connythecreator/crimson-veil/3Dmodels/case/drawings/base.png

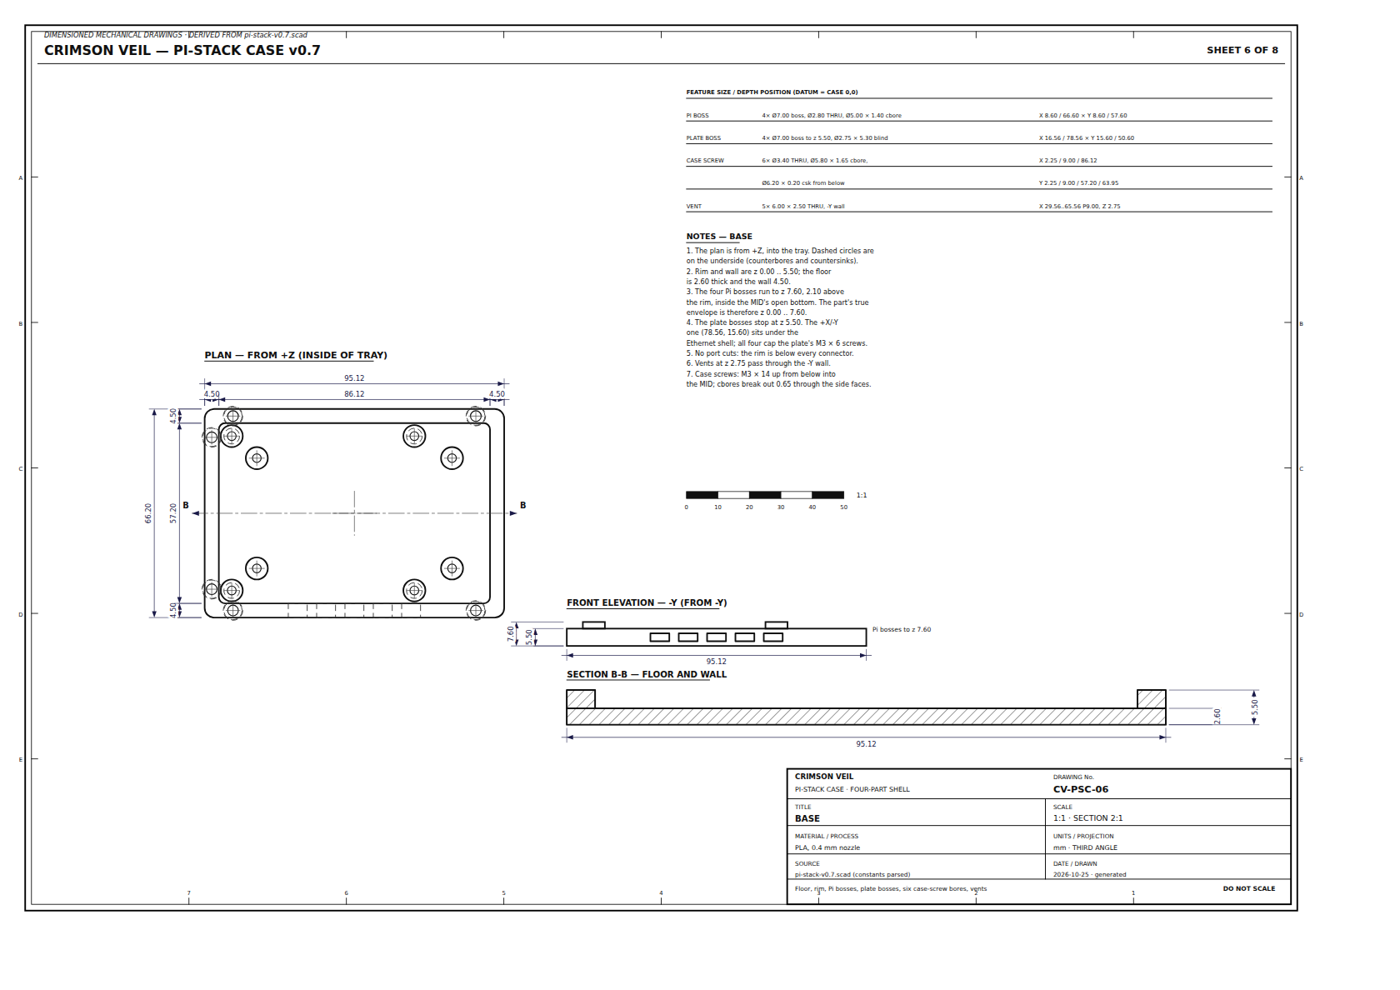
3Dmodels/case/drawings/base.png
