connythecreator/crimson-veil/3Dmodels/case/drawings/bezel.png

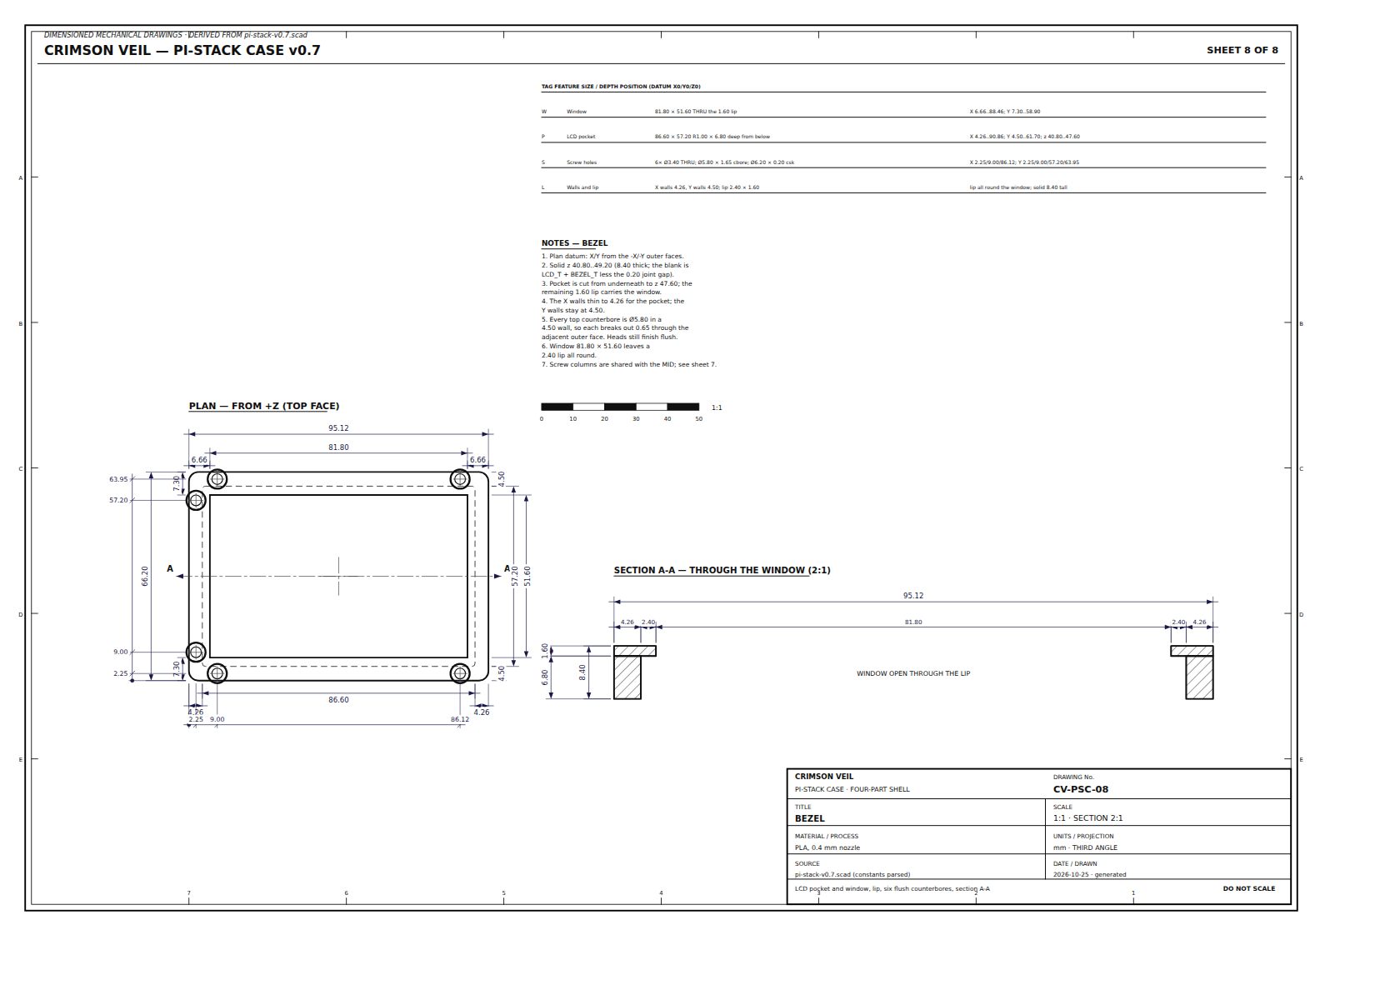
3Dmodels/case/drawings/bezel.png
