connythecreator/crimson-veil/3Dmodels/case/drawings/mid.png

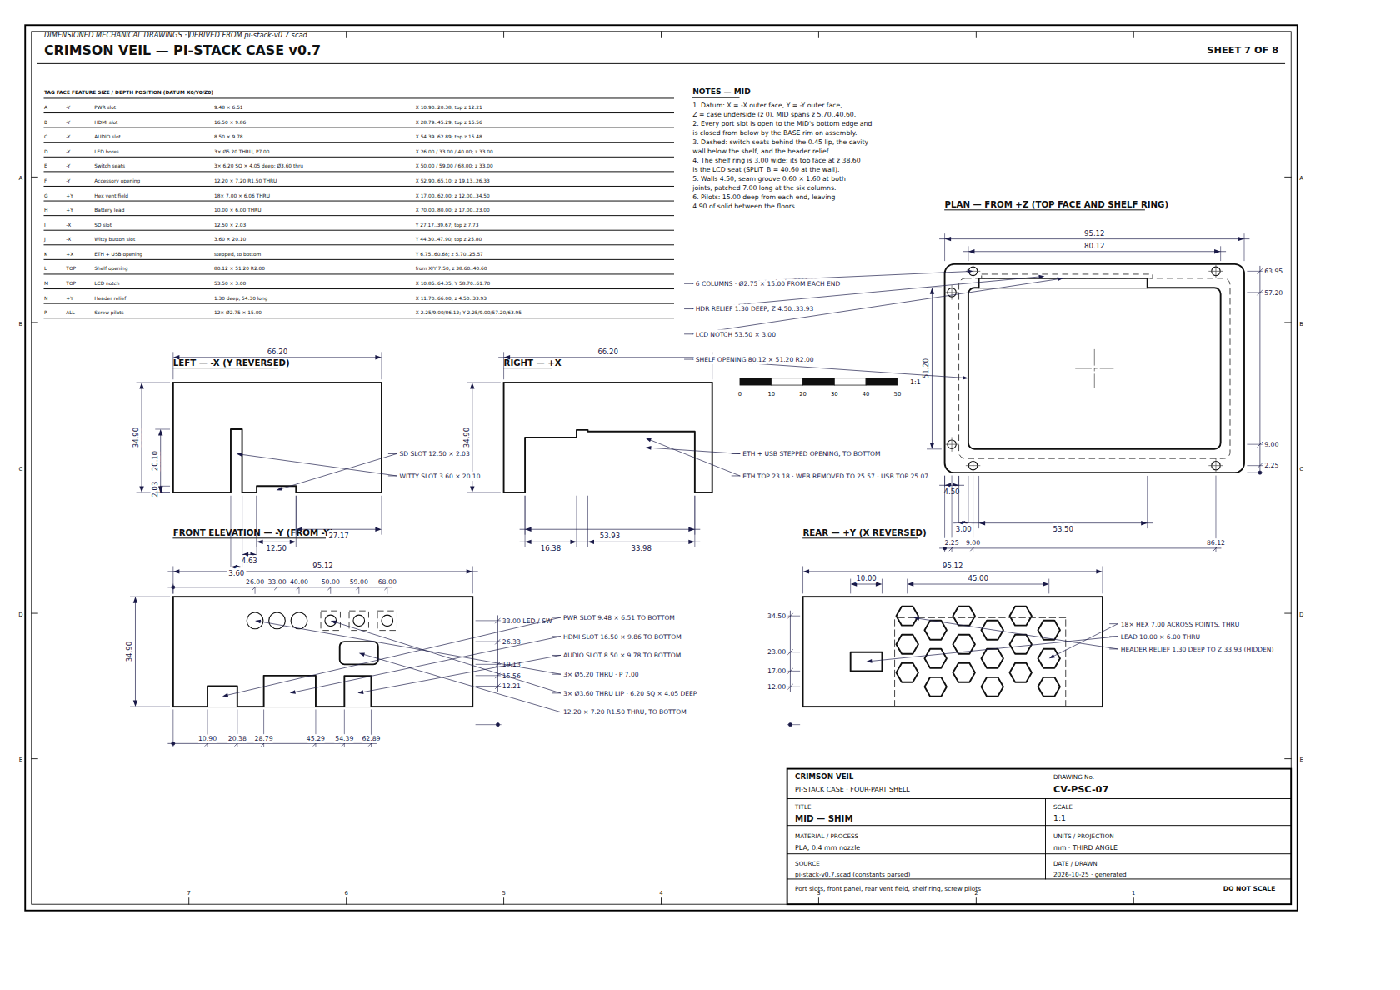
3Dmodels/case/drawings/mid.png
