connythecreator/crimson-veil/3Dmodels/case/drawings/plate.png

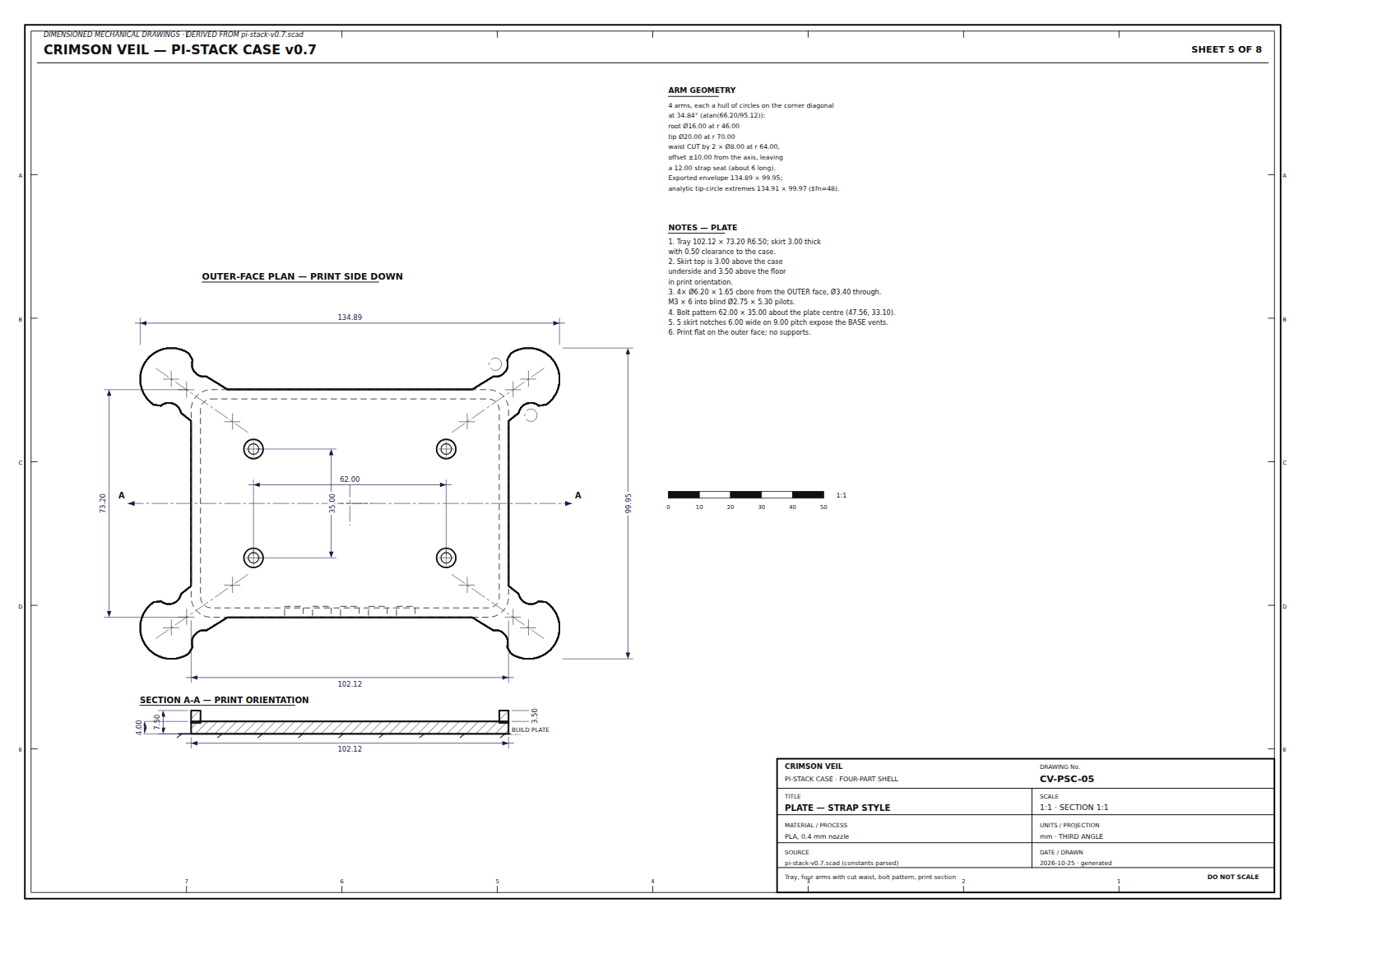
3Dmodels/case/drawings/plate.png
