connythecreator/crimson-veil/3Dmodels/case/preview/pi-stack-v0.1.png

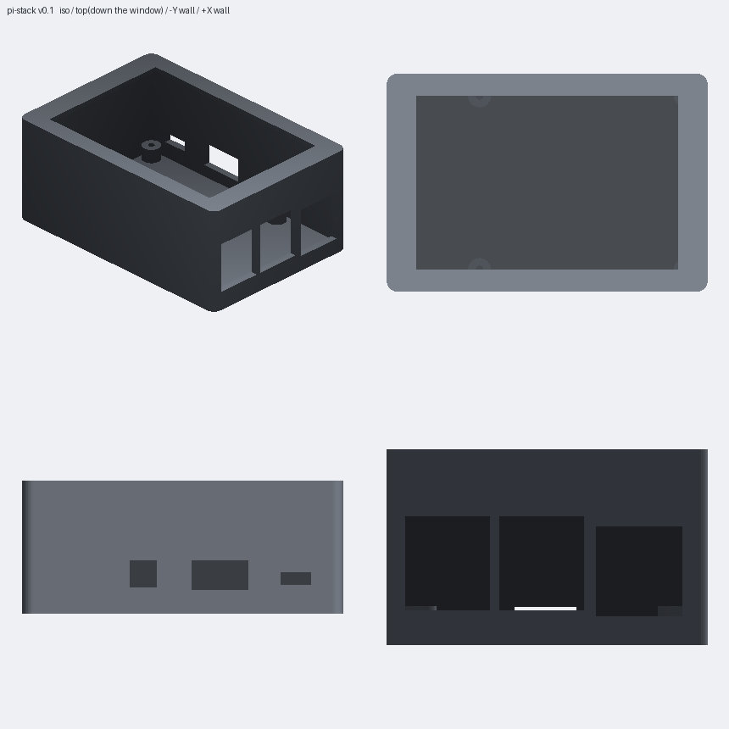
3Dmodels/case/preview/pi-stack-v0.1.png
