connythecreator/crimson-veil/3Dmodels/case/preview/v0.3-internals.png

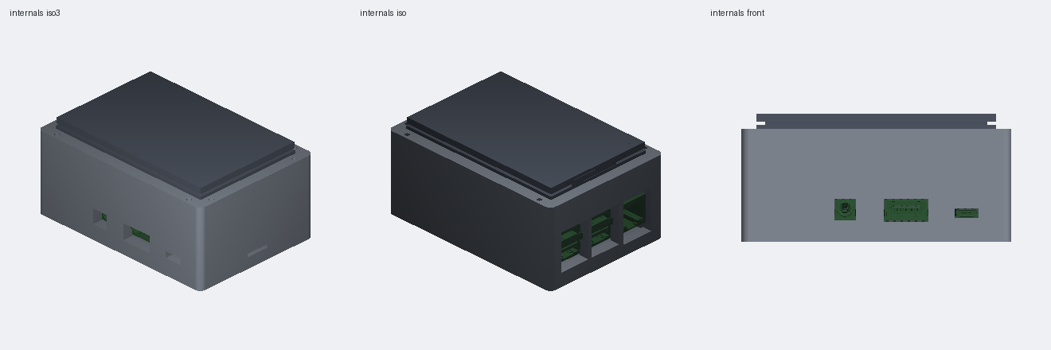
3Dmodels/case/preview/v0.3-internals.png
