connythecreator/crimson-veil/3Dmodels/case/preview/v0.3-stack.png

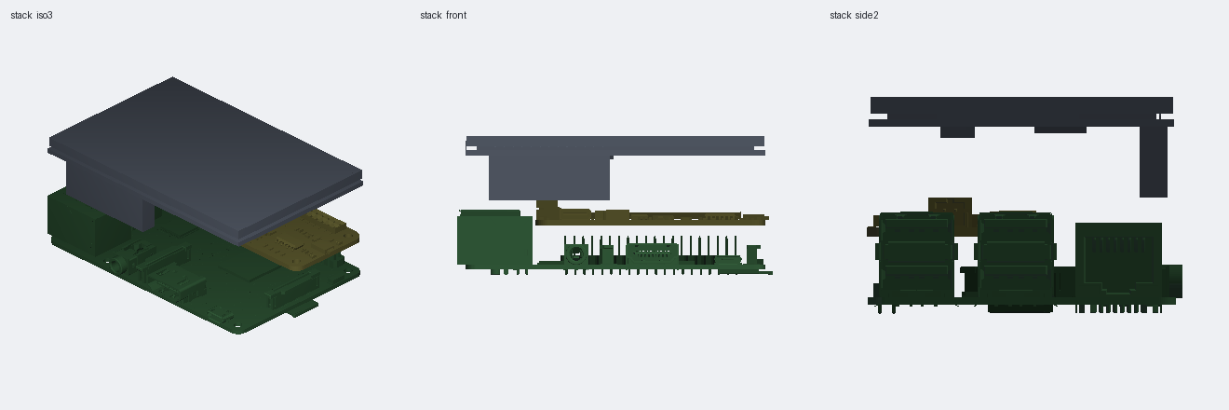
3Dmodels/case/preview/v0.3-stack.png
