connythecreator/crimson-veil/3Dmodels/case/preview/v0.4-joints.png

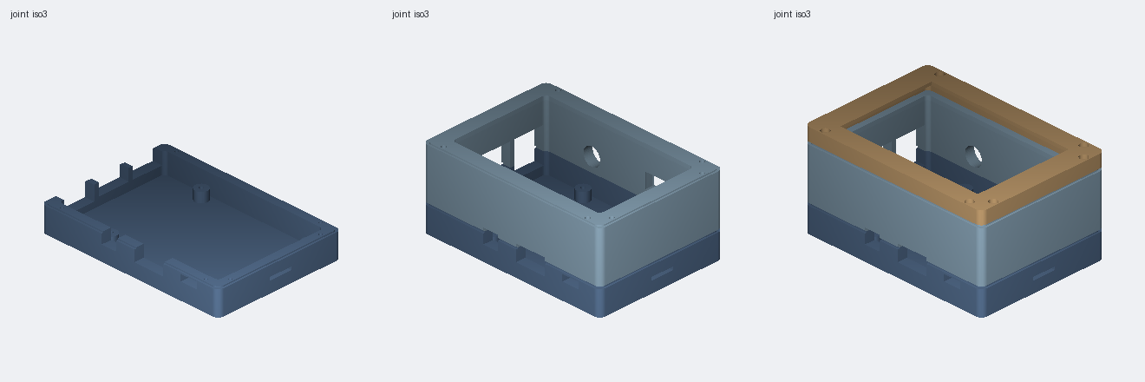
3Dmodels/case/preview/v0.4-joints.png
