connythecreator/crimson-veil/3Dmodels/case/preview/v0.5-joints.png

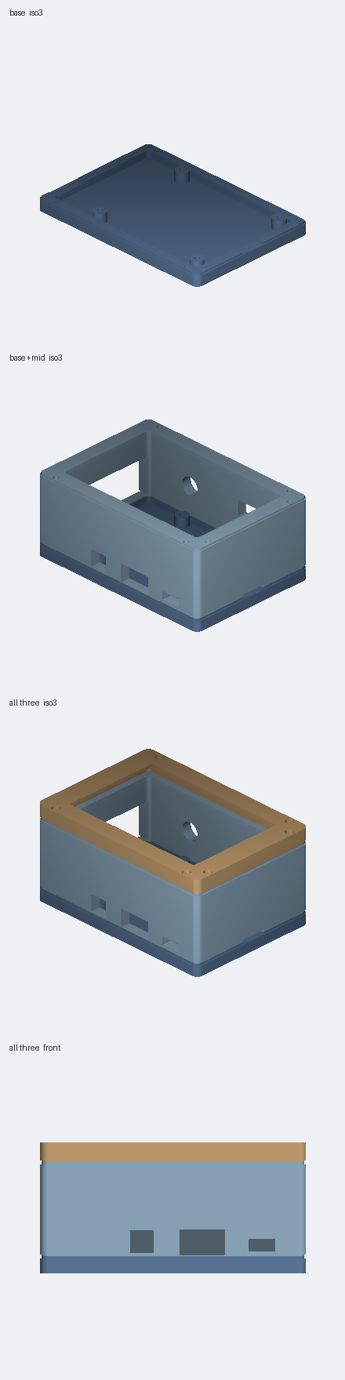
3Dmodels/case/preview/v0.5-joints.png
