connythecreator/crimson-veil/3Dmodels/case/preview/v0.6-joints.png

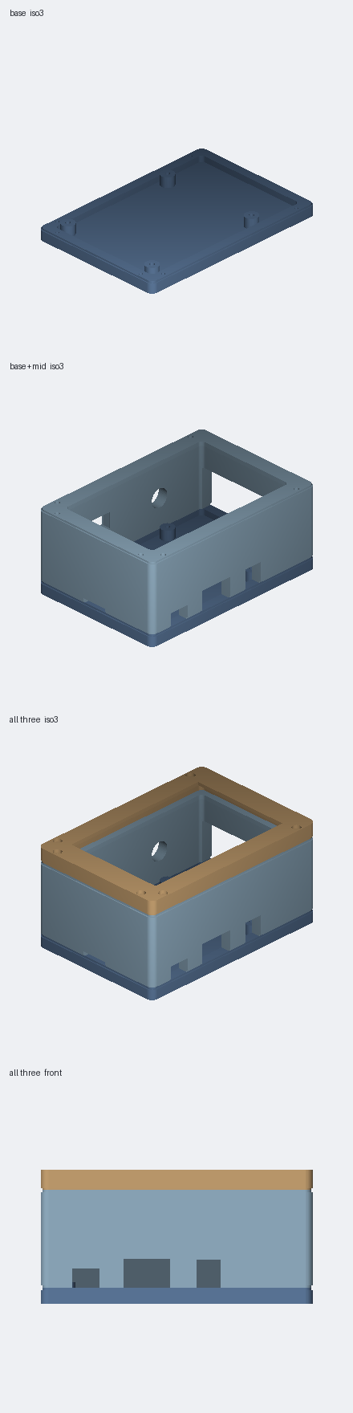
3Dmodels/case/preview/v0.6-joints.png
