connythecreator/crimson-veil/3Dmodels/case/preview/v0.6-section.png

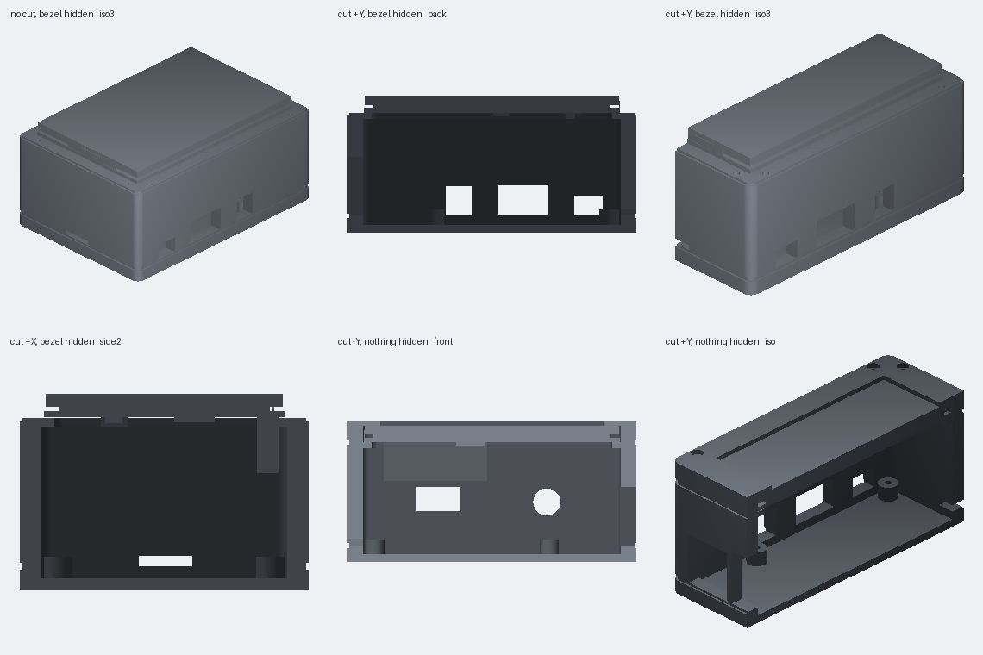
3Dmodels/case/preview/v0.6-section.png
