connythecreator/crimson-veil/3Dmodels/case/preview/v0.6-stack.png

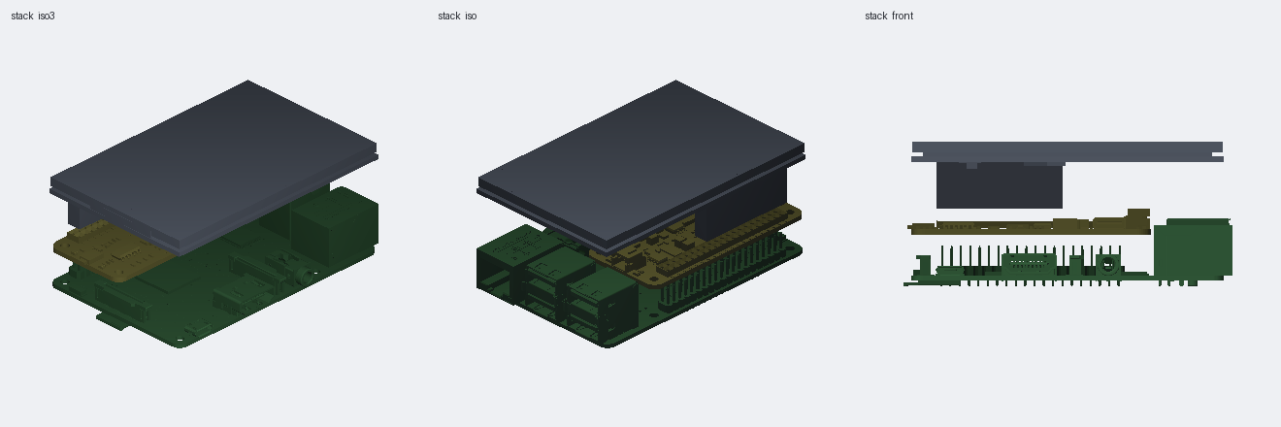
3Dmodels/case/preview/v0.6-stack.png
