connythecreator/crimson-veil/3Dmodels/case/preview/v0.7-base.png

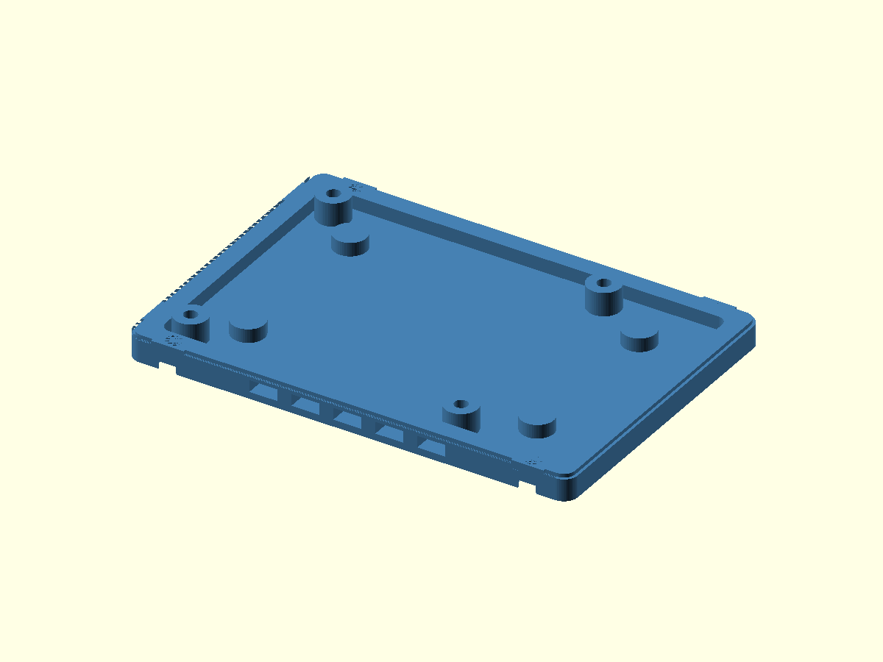
3Dmodels/case/preview/v0.7-base.png
