connythecreator/crimson-veil/3Dmodels/case/preview/v0.7-fittings.png

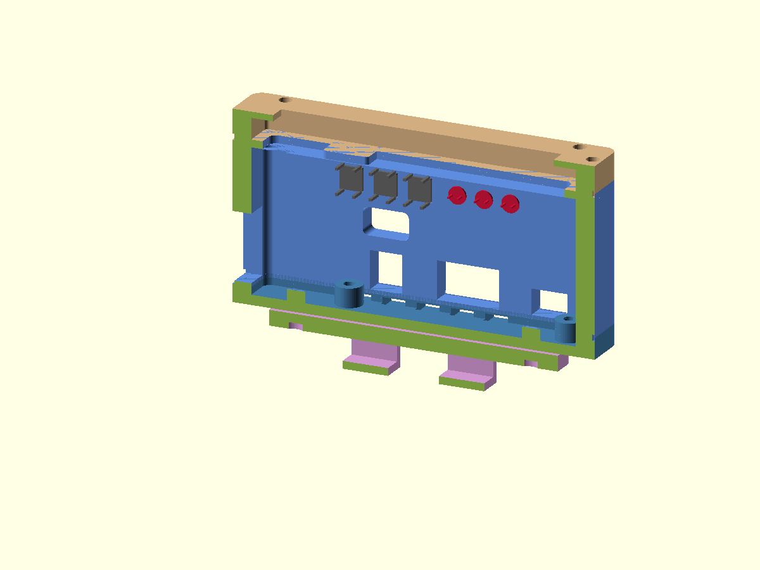
3Dmodels/case/preview/v0.7-fittings.png
