connythecreator/crimson-veil/3Dmodels/case/preview/v0.7-front.png

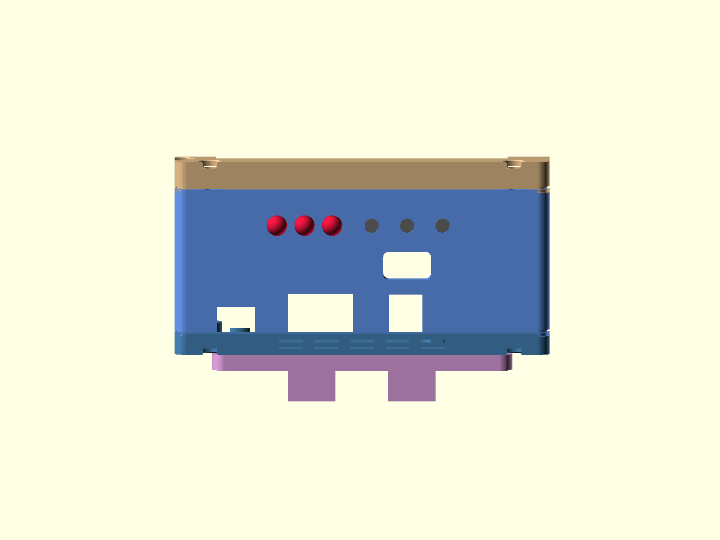
3Dmodels/case/preview/v0.7-front.png
