connythecreator/crimson-veil/3Dmodels/case/preview/v0.7-internals.png

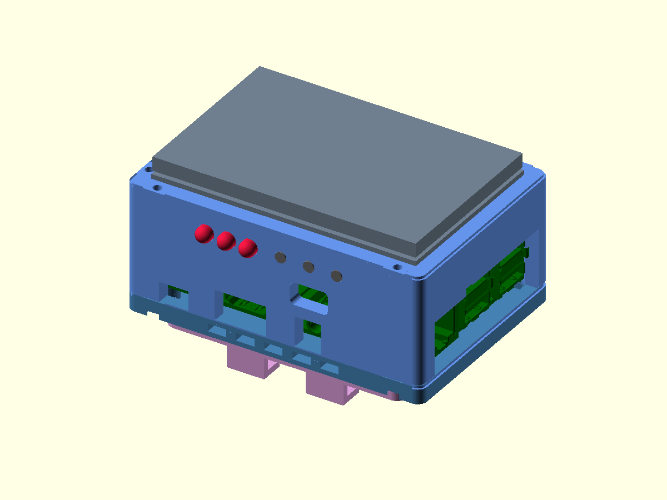
3Dmodels/case/preview/v0.7-internals.png
