connythecreator/crimson-veil/3Dmodels/case/preview/v0.7-joints.png

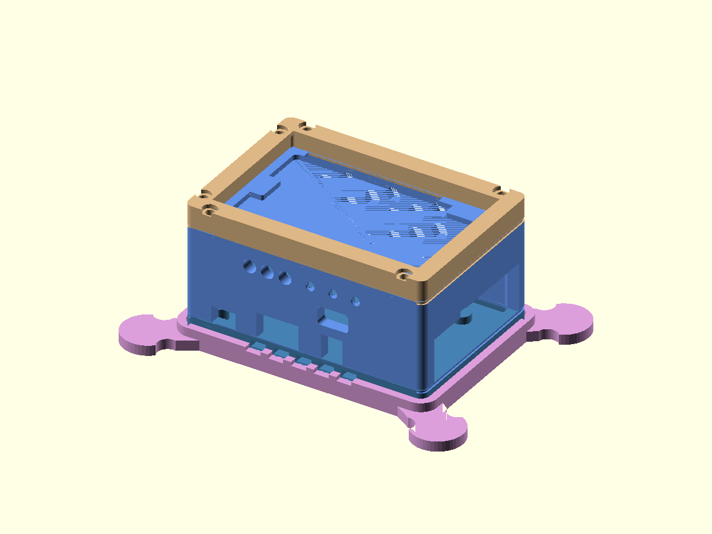
3Dmodels/case/preview/v0.7-joints.png
