connythecreator/crimson-veil/3Dmodels/case/preview/v0.7-midpanel.png

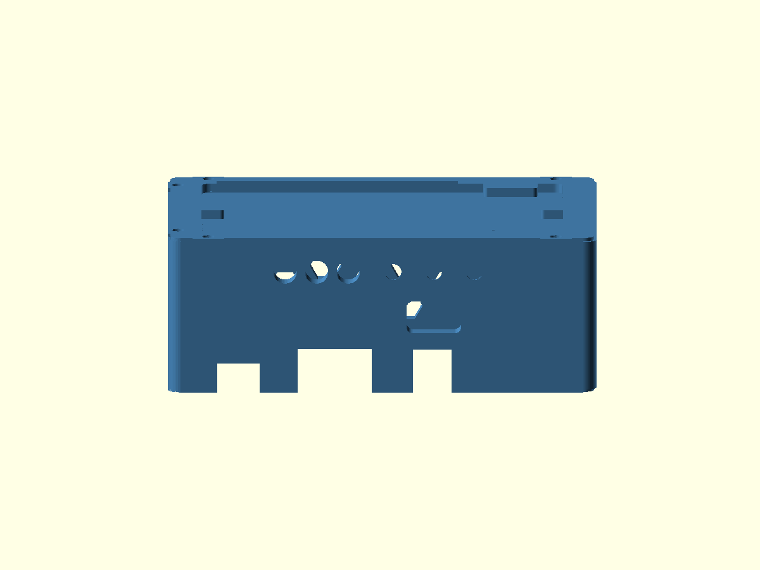
3Dmodels/case/preview/v0.7-midpanel.png
