connythecreator/crimson-veil/3Dmodels/case/preview/v0.7-pads.png

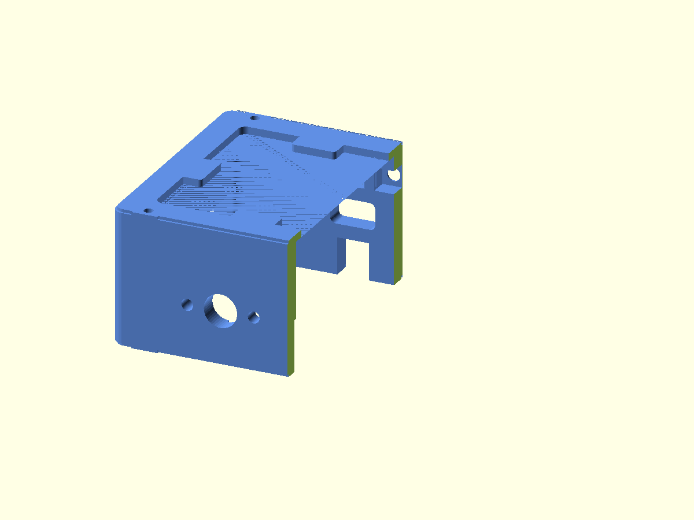
3Dmodels/case/preview/v0.7-pads.png
