connythecreator/crimson-veil/3Dmodels/case/preview/v0.7-panel.png

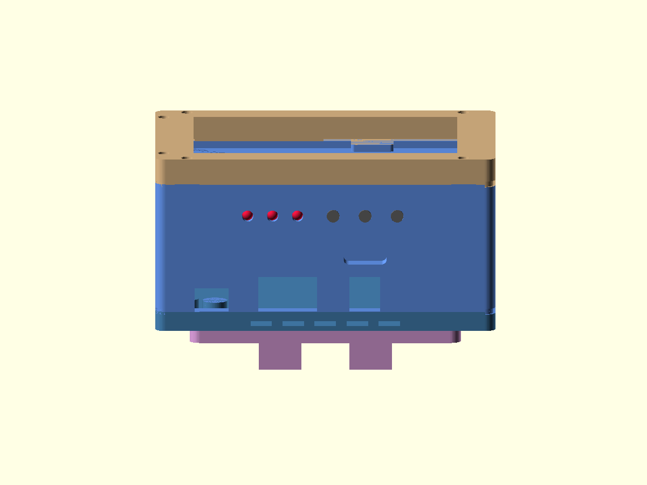
3Dmodels/case/preview/v0.7-panel.png
