connythecreator/crimson-veil/3Dmodels/case/preview/v0.7-plate.png

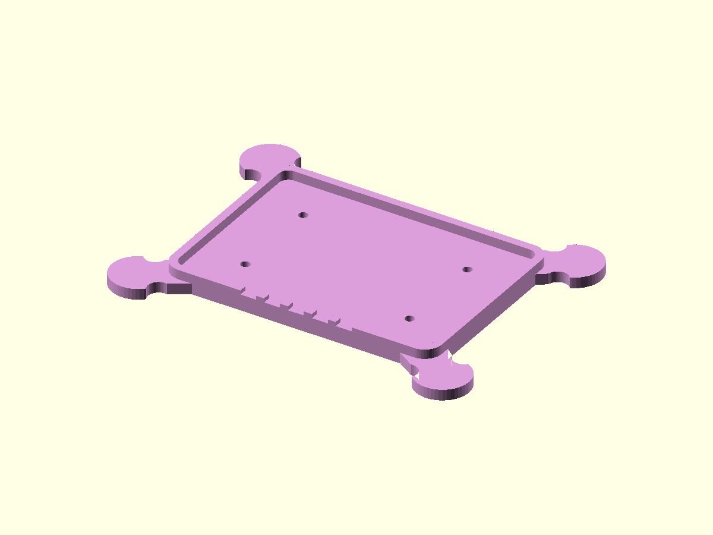
3Dmodels/case/preview/v0.7-plate.png
