connythecreator/crimson-veil/3Dmodels/case/preview/v0.7-rear.png

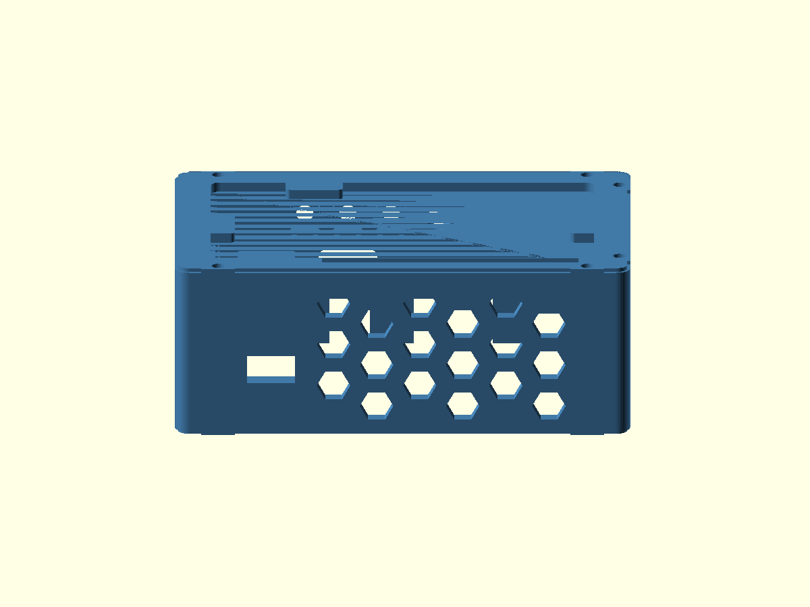
3Dmodels/case/preview/v0.7-rear.png
