connythecreator/crimson-veil/3Dmodels/case/preview/v0.7-section.png

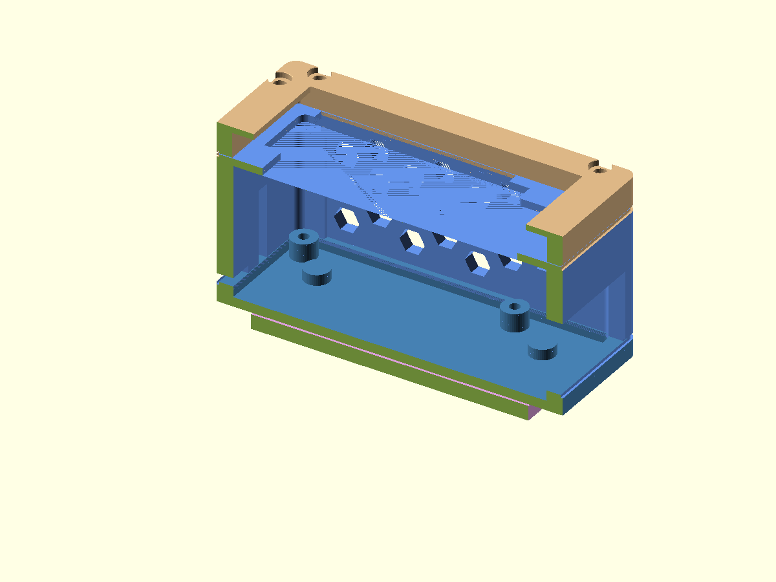
3Dmodels/case/preview/v0.7-section.png
