connythecreator/crimson-veil/3Dmodels/case/preview/v0.7-stack.png

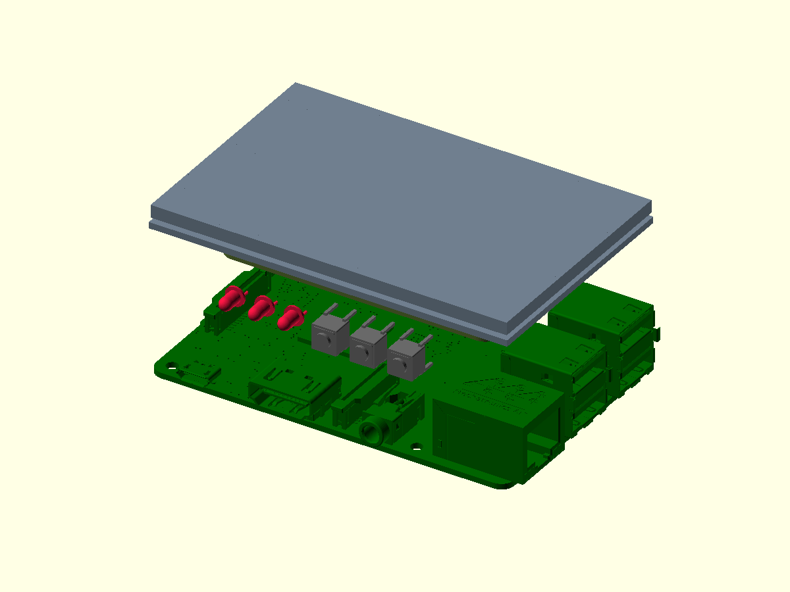
3Dmodels/case/preview/v0.7-stack.png
