connythecreator/crimson-veil/3Dmodels/case/preview/v0.7-underside.png

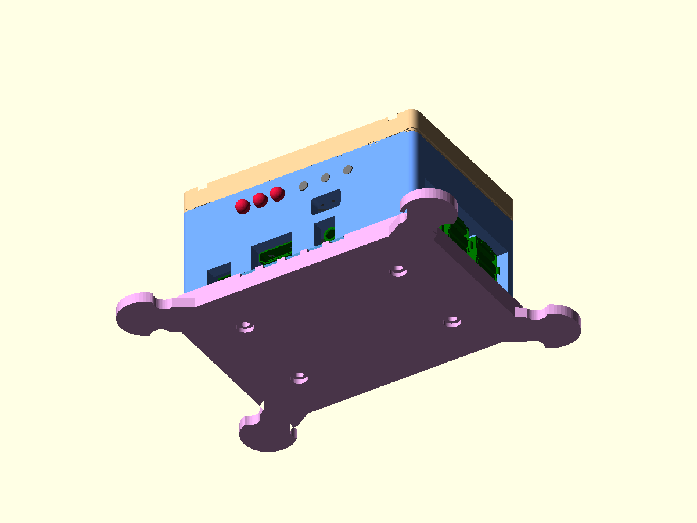
3Dmodels/case/preview/v0.7-underside.png
