connythecreator/crimson-veil/architecture-repo-wide.png

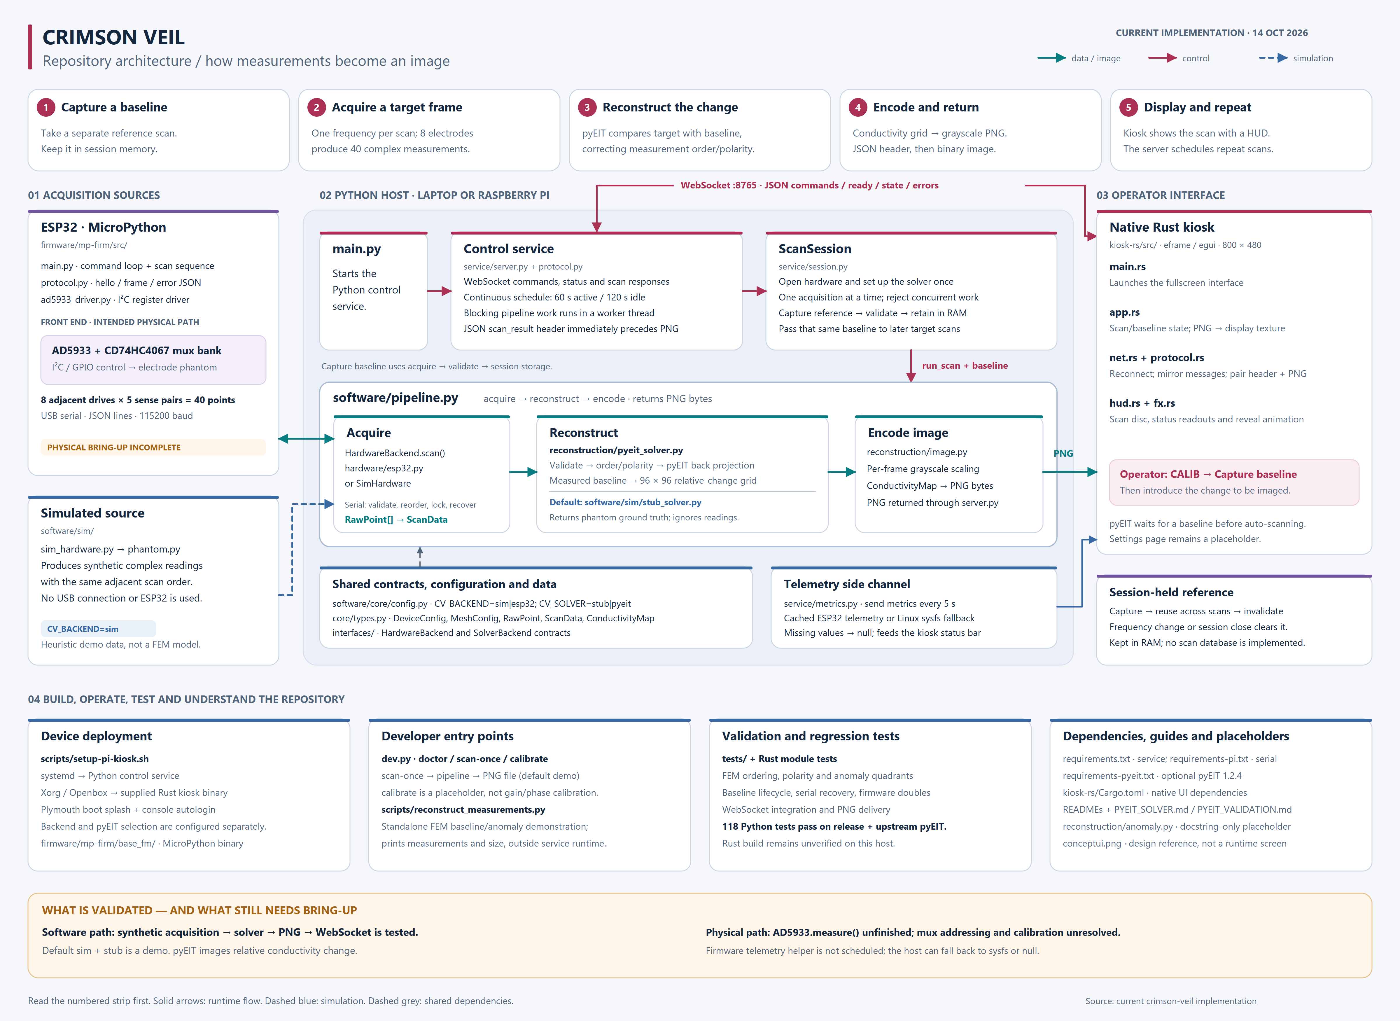
architecture-repo-wide.png
