connythecreator/crimson-veil/bleed/Pasted image.png

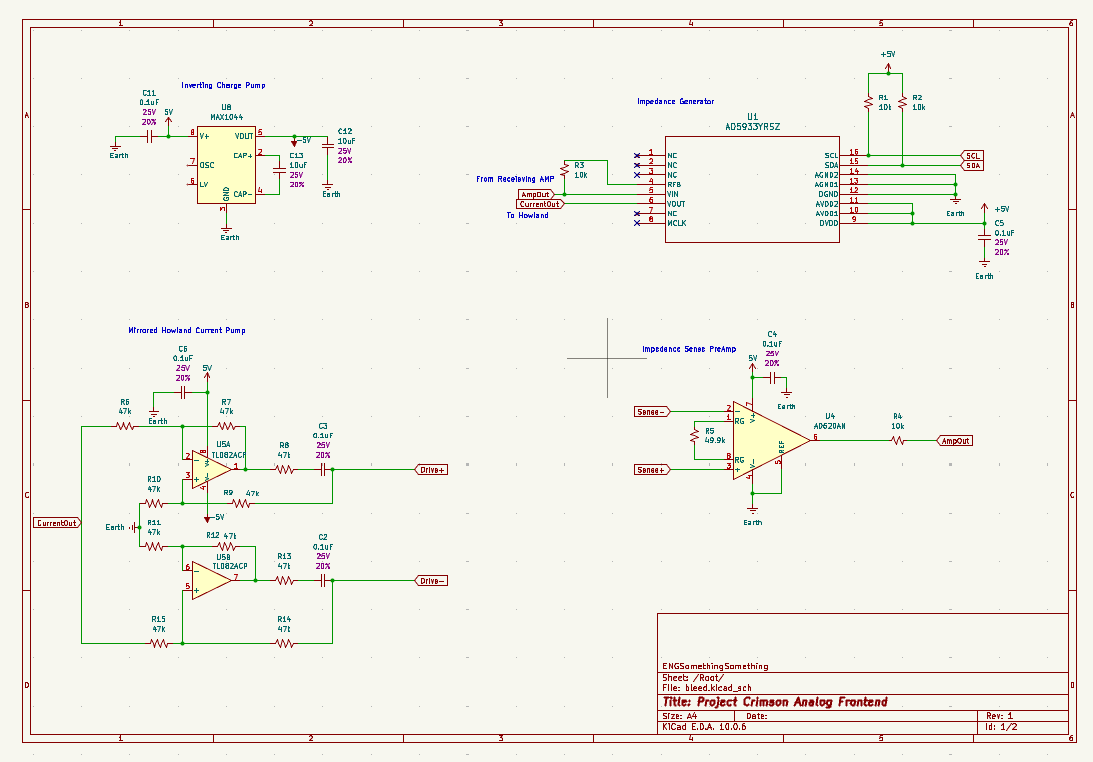
bleed/Pasted image.png
