connythecreator/crimson-veil/conceptui.png

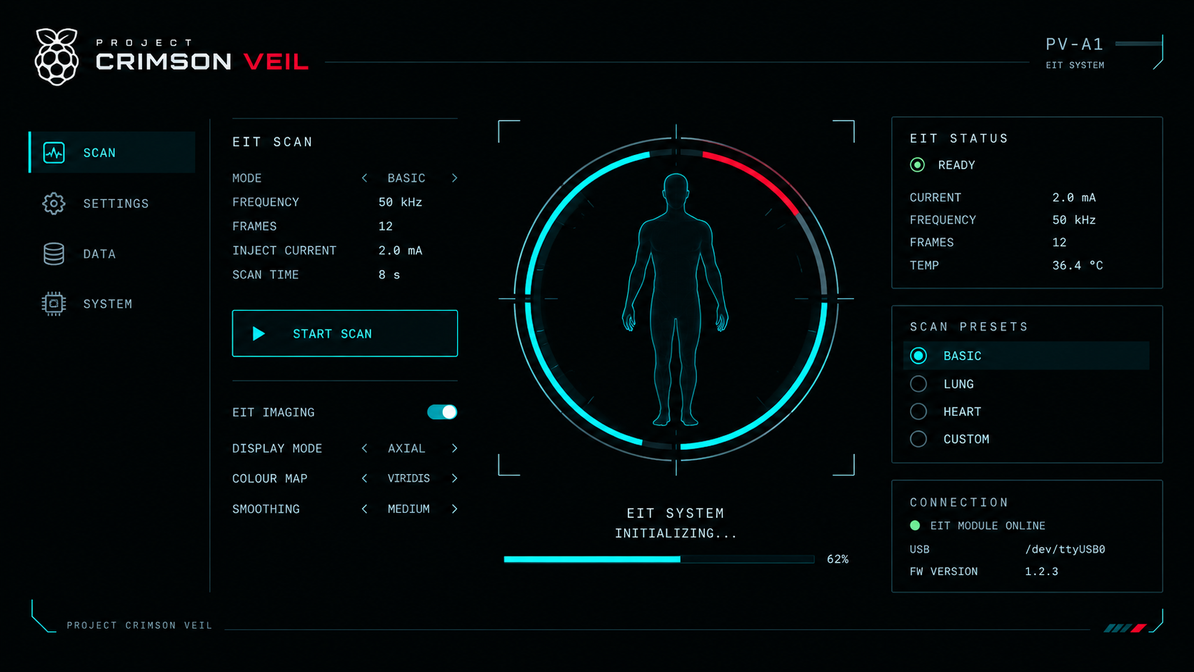
conceptui.png
