connythecreator/crimson-veil/3Dmodels/case/preview/v0.2-parts.png

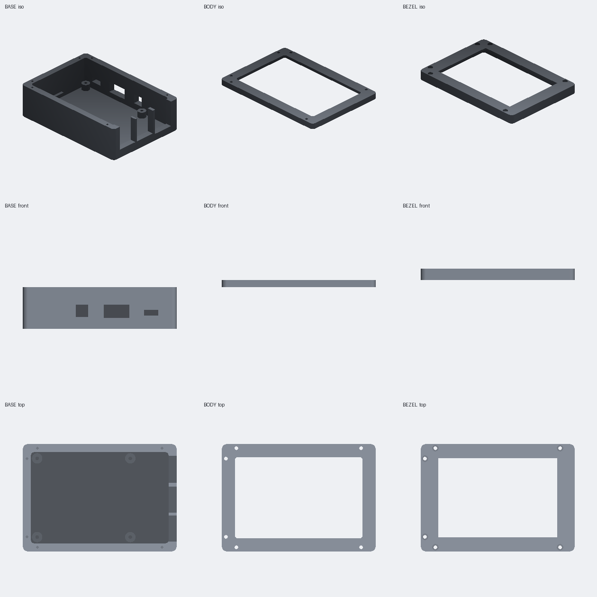
3Dmodels/case/preview/v0.2-parts.png
