connythecreator/crimson-veil/3Dmodels/case/preview/v0.6-parts.png

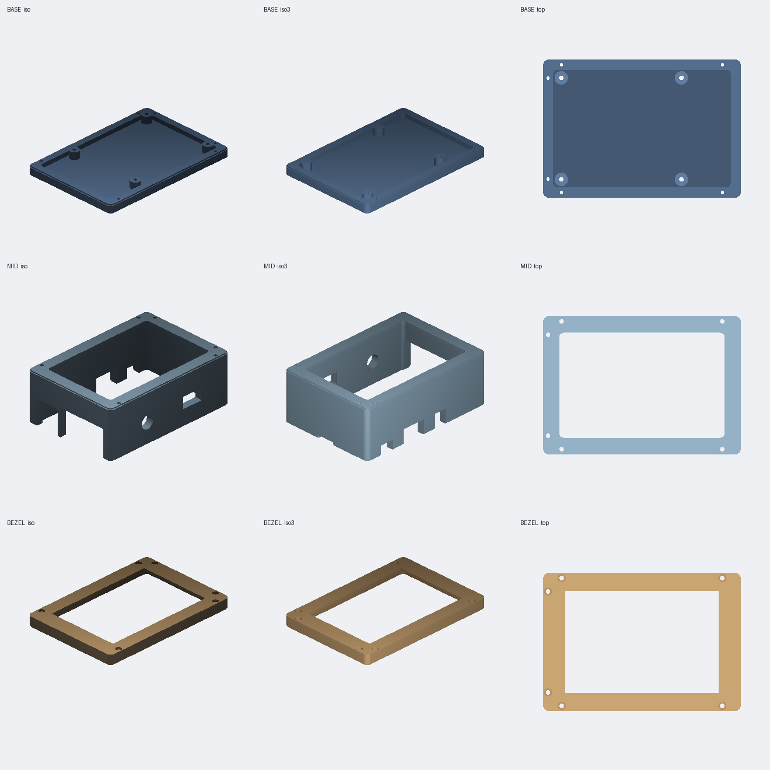
3Dmodels/case/preview/v0.6-parts.png
