connythecreator/crimson-veil/3Dmodels/case/preview/v0.7-parts.png

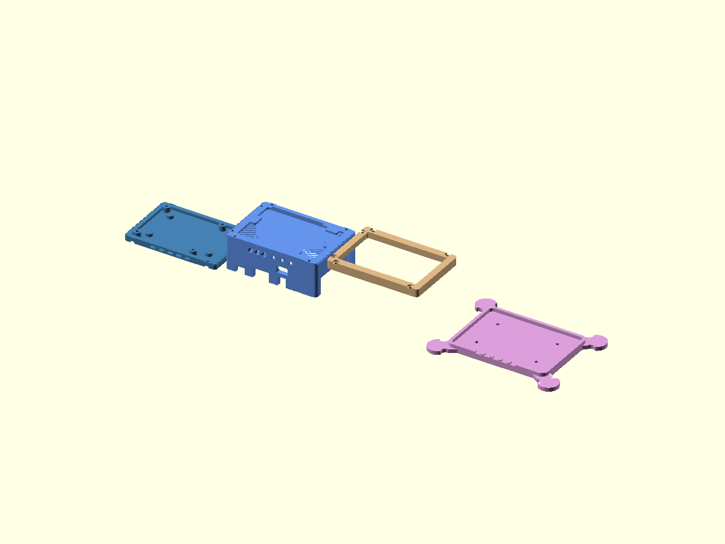
3Dmodels/case/preview/v0.7-parts.png
