connythecreator/crimson-veil/3Dmodels/base/ECG Snap Button 4mm.STEP

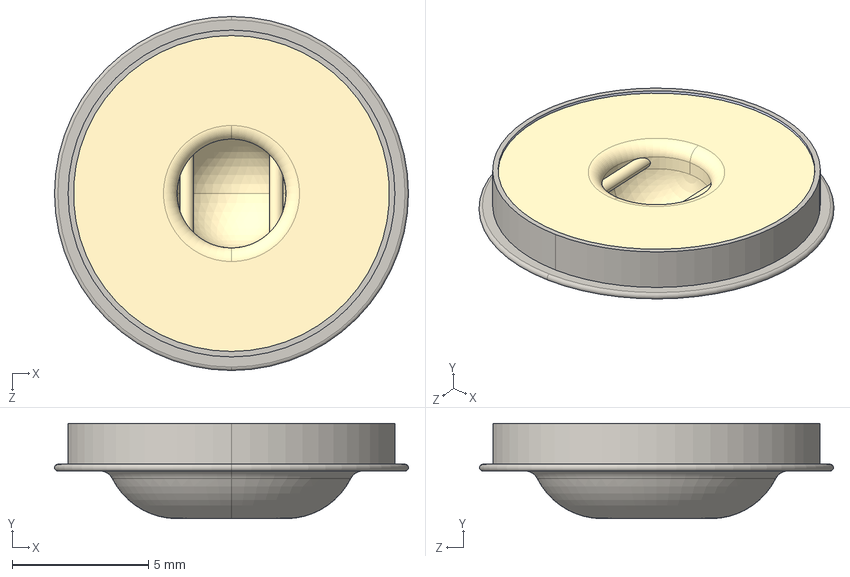
[picture p32: CAD file, 2026-10-19]
3Dmodels/base/ECG Snap Button 4mm.STEP
13.0 x 3.50 x 13.0 mm
