connythecreator/crimson-veil/3Dmodels/base/caseHighVents.stl

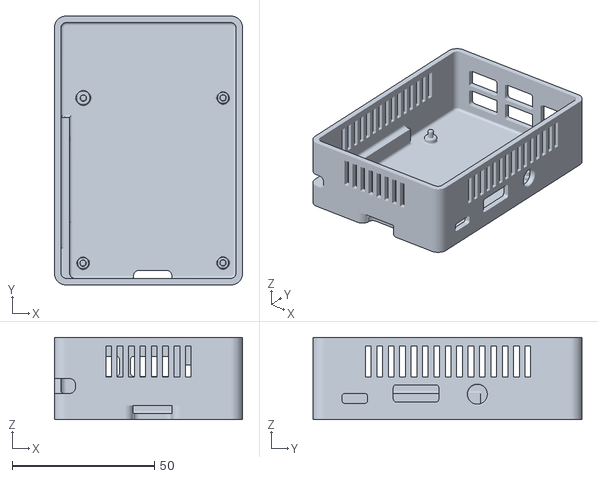
[picture p33: CAD file, 2026-10-19]
3Dmodels/base/caseHighVents.stl
66.0 x 94.4 x 29.0
