connythecreator/crimson-veil/3Dmodels/derived/WittyPi4L3V7.stl

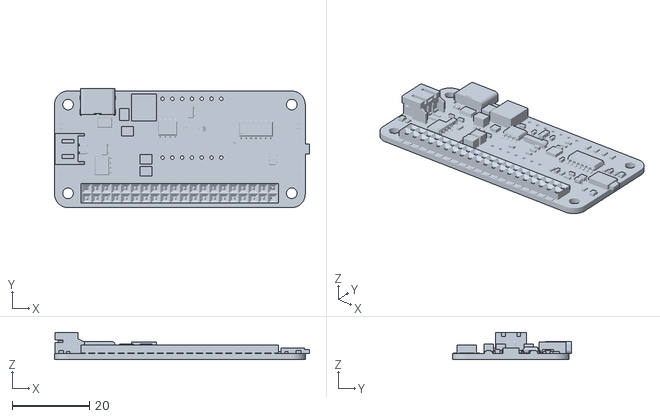
[picture p34: CAD file, 2026-10-19]
3Dmodels/derived/WittyPi4L3V7.stl
66.1 x 30.9 x 7.08
