connythecreator/crimson-veil/3Dmodels/base/3.5inch RPi LCD.stp

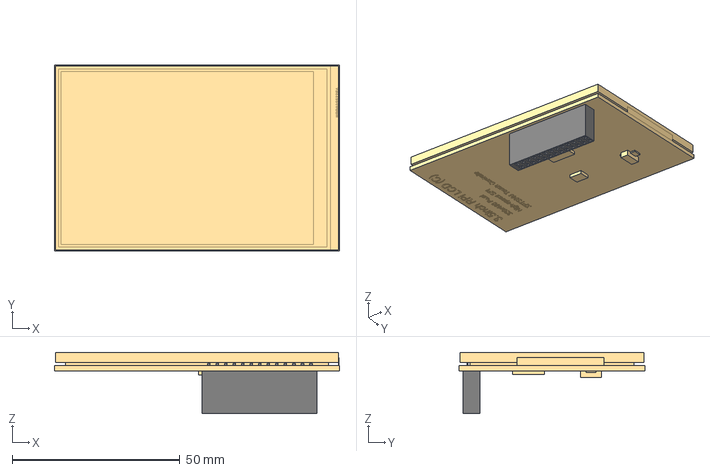
[picture p35: CAD file, 2026-10-19]
3Dmodels/base/3.5inch RPi LCD.stp
85.0 x 55.5 x 18.3 mm
