connythecreator/crimson-veil/3Dmodels/case/stl/pi-stack-v0.7-plate.stl

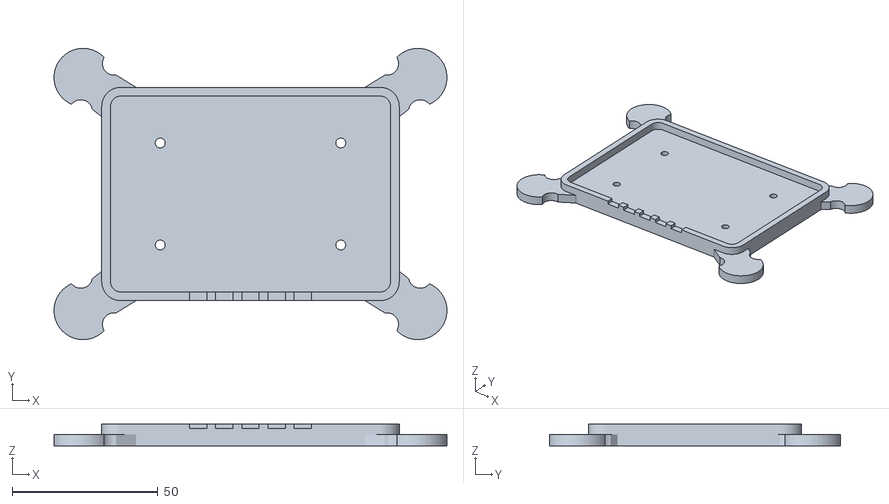
[picture p36: CAD file, 2026-10-27]
3Dmodels/case/stl/pi-stack-v0.7-plate.stl
134.9 x 100.0 x 7.50
