connythecreator/crimson-veil/3Dmodels/case/stl/pi-stack-v0.7-base.stl

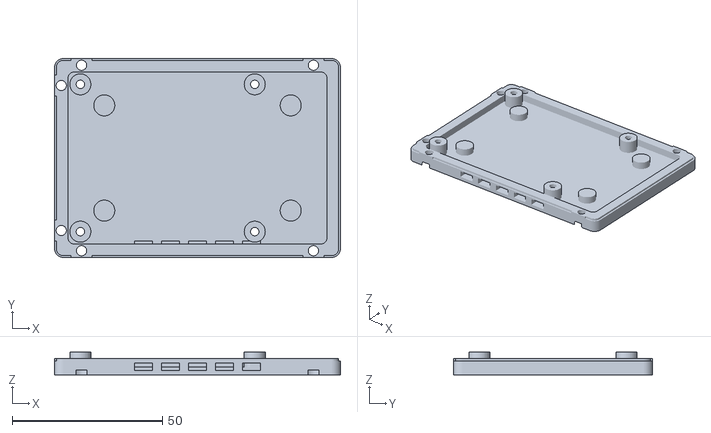
[picture p37: CAD file, 2026-10-19]
3Dmodels/case/stl/pi-stack-v0.7-base.stl
95.1 x 66.2 x 7.60
