connythecreator/crimson-veil/3Dmodels/base/topEdit3.stl

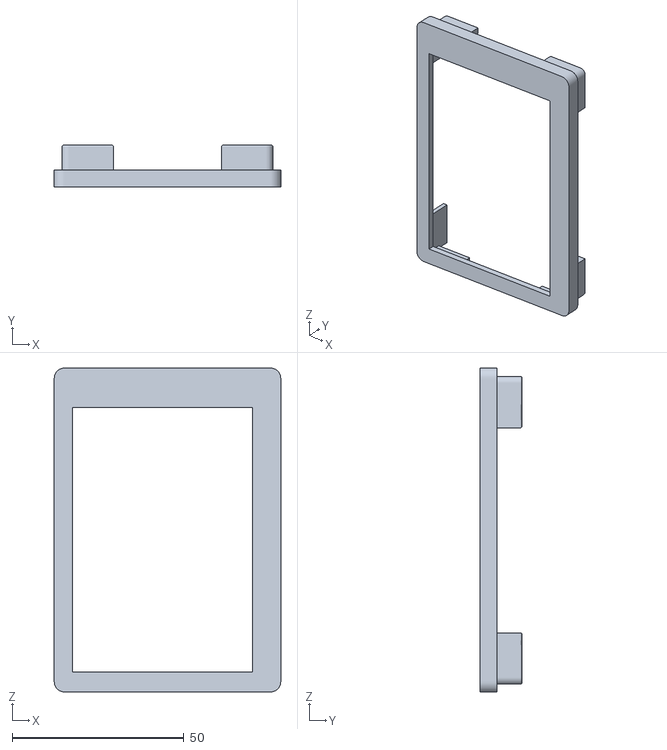
[picture p38: CAD file, 2026-10-19]
3Dmodels/base/topEdit3.stl
66.0 x 12.3 x 94.4
