connythecreator/crimson-veil/3Dmodels/case/stl/pi-stack-v0.7-mid.stl

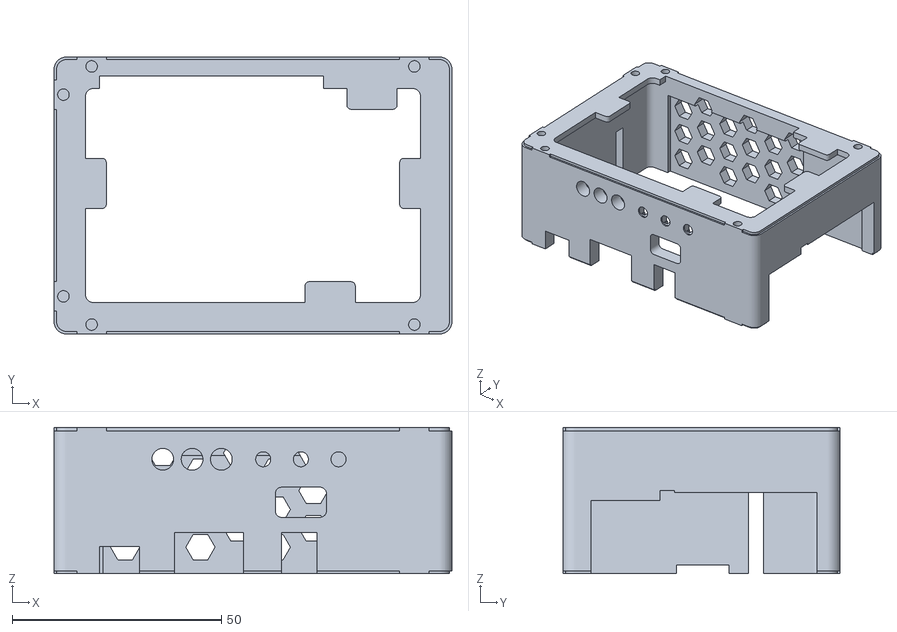
[picture p39: CAD file, 2026-10-19]
3Dmodels/case/stl/pi-stack-v0.7-mid.stl
95.1 x 66.2 x 34.9
