connythecreator/crimson-veil/3Dmodels/case/stl/pi-stack-v0.7-bezel.stl

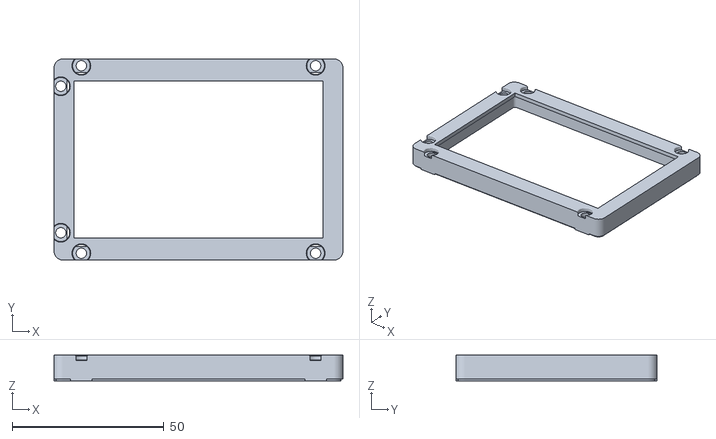
[picture p40: CAD file, 2026-10-19]
3Dmodels/case/stl/pi-stack-v0.7-bezel.stl
95.1 x 66.2 x 8.40
