connythecreator/crimson-veil/3Dmodels/case/stl/ce07929-lid.stl

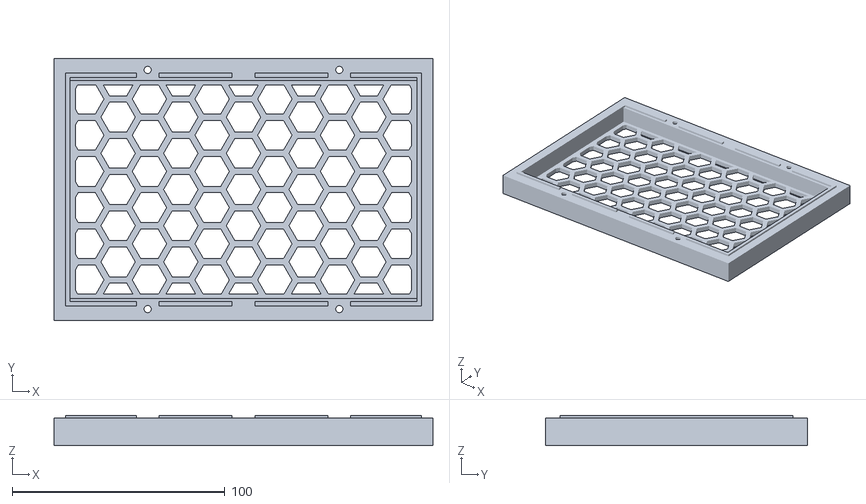
[picture p41: CAD file, 2026-11-07]
3Dmodels/case/stl/ce07929-lid.stl
178.0 x 123.0 x 14.2
