connythecreator/crimson-veil/3Dmodels/case/stl/ce07929-base.stl

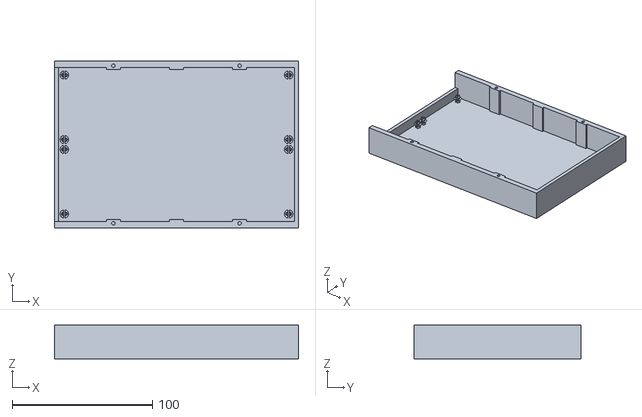
[picture p42: CAD file, 2026-11-07]
3Dmodels/case/stl/ce07929-base.stl
174.0 x 119.0 x 24.0
