connythecreator/crimson-veil/3Dmodels/case/stl/pi-stack-mid.stl

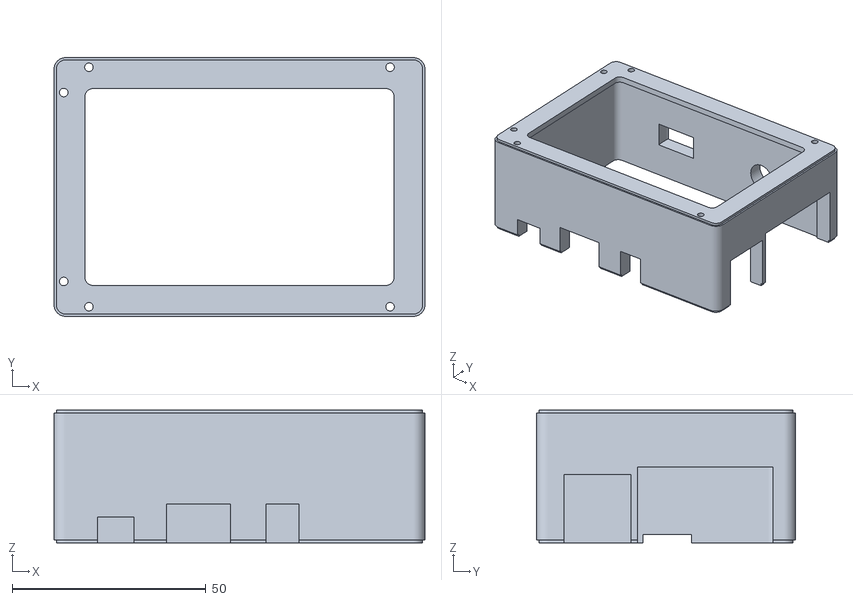
[picture p43: CAD file, 2026-10-19, an earlier design]
3Dmodels/case/stl/pi-stack-mid.stl
95.6 x 66.7 x 34.3
