connythecreator/crimson-veil/(list of files, cad)

Other CAD files:
3Dmodels/derived/ECG_Snap_Button_4mm.stl
3Dmodels/derived/3.5inch_RPi_LCD.stl
3Dmodels/base/WittyPi4L3V7.step
