connythecreator/crimson-veil/software/reconstruction/mock-impedances.csv

n_electrodes | point | table | drive_pos | drive_neg | sense_pos | sense_neg | raw_re | raw_im | z_k1_re | z_k1_im
4 | 0 | baseline | 0 | 1 | 2 | 3 | -0.22052067 | 0 | -4.53472230064 | -0
4 | 1 | baseline | 1 | 2 | 3 | 0 | -0.22062943 | 0 | -4.53248689443 | -0
4 | 2 | baseline | 2 | 3 | 0 | 1 | -0.22052067 | 0 | -4.53472230064 | -0
4 | 3 | baseline | 3 | 0 | 1 | 2 | -0.22062943 | 0 | -4.53248689443 | -0
4 | 0 | target_0 | 0 | 1 | 2 | 3 | -0.212828996 | 0 | -4.69860789082 | -0
4 | 1 | target_0 | 1 | 2 | 3 | 0 | -0.211870575 | 0 | -4.71986258592 | -0
4 | 2 | target_0 | 2 | 3 | 0 | 1 | -0.212828996 | 0 | -4.69860789082 | -0
4 | 3 | target_0 | 3 | 0 | 1 | 2 | -0.211870575 | 0 | -4.71986258592 | -0
4 | 0 | target_1 | 0 | 1 | 2 | 3 | -0.222228389 | 0 | -4.49987512622 | -0
4 | 1 | target_1 | 1 | 2 | 3 | 0 | -0.208803419 | 0 | -4.7891936099 | -0
4 | 2 | target_1 | 2 | 3 | 0 | 1 | -0.222228389 | 0 | -4.49987512622 | -0
4 | 3 | target_1 | 3 | 0 | 1 | 2 | -0.208803419 | 0 | -4.7891936099 | -0
4 | 0 | target_2 | 0 | 1 | 2 | 3 | -0.212983037 | 0 | -4.69520960019 | -0
4 | 1 | target_2 | 1 | 2 | 3 | 0 | -0.212698911 | 0 | -4.70148152286 | -0
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
