connythecreator/crimson-veil/3Dmodels/case/drawings/assembly-bottom.png

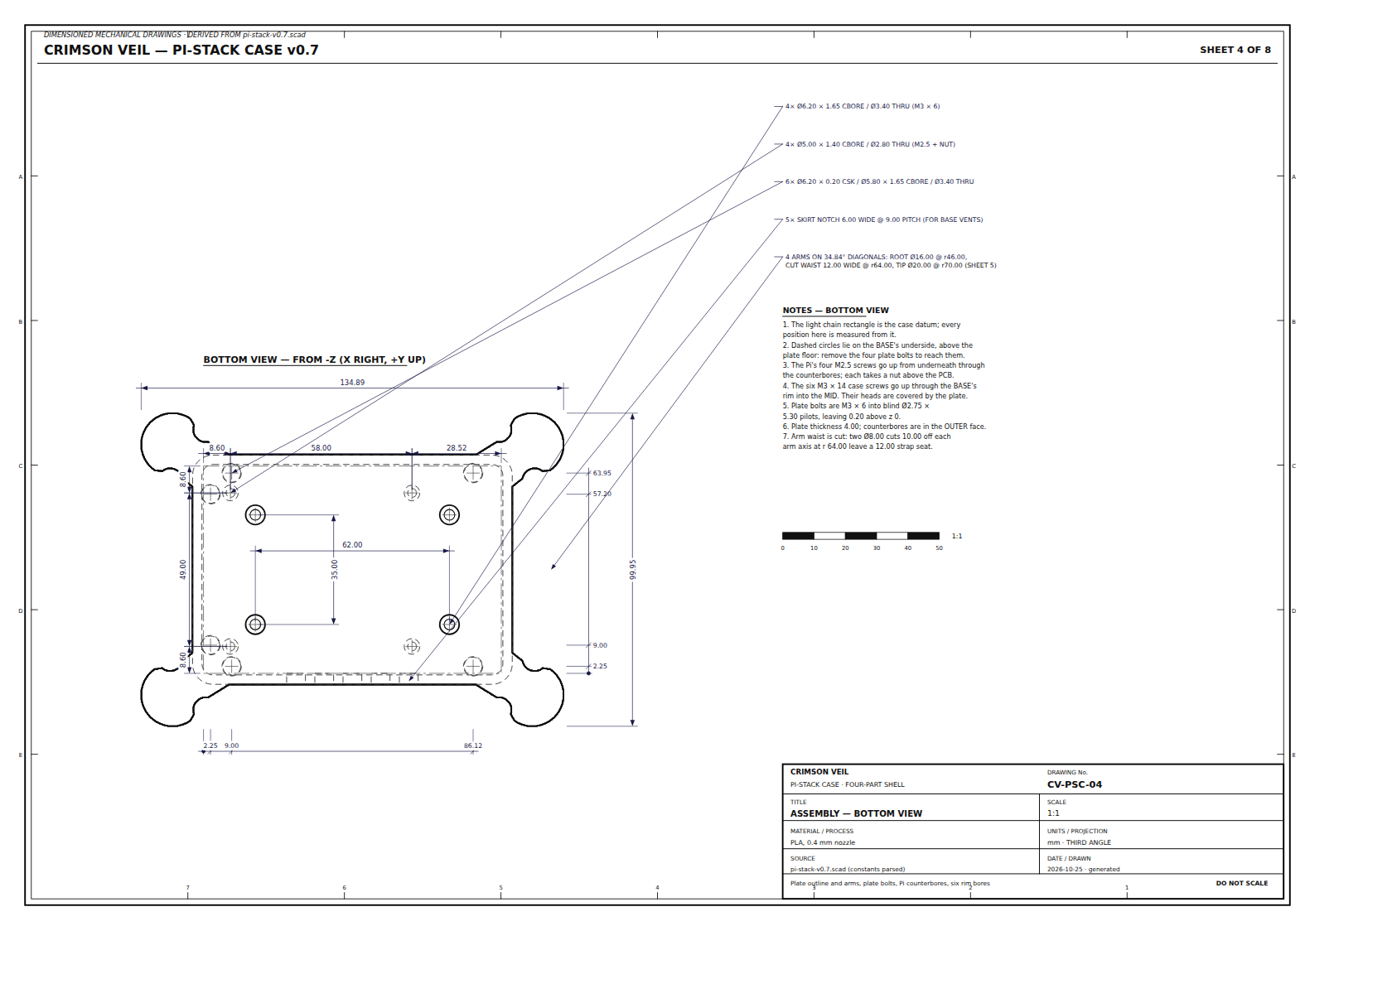
3Dmodels/case/drawings/assembly-bottom.png
