connythecreator/crimson-veil/3Dmodels/case/drawings/assembly-front.png

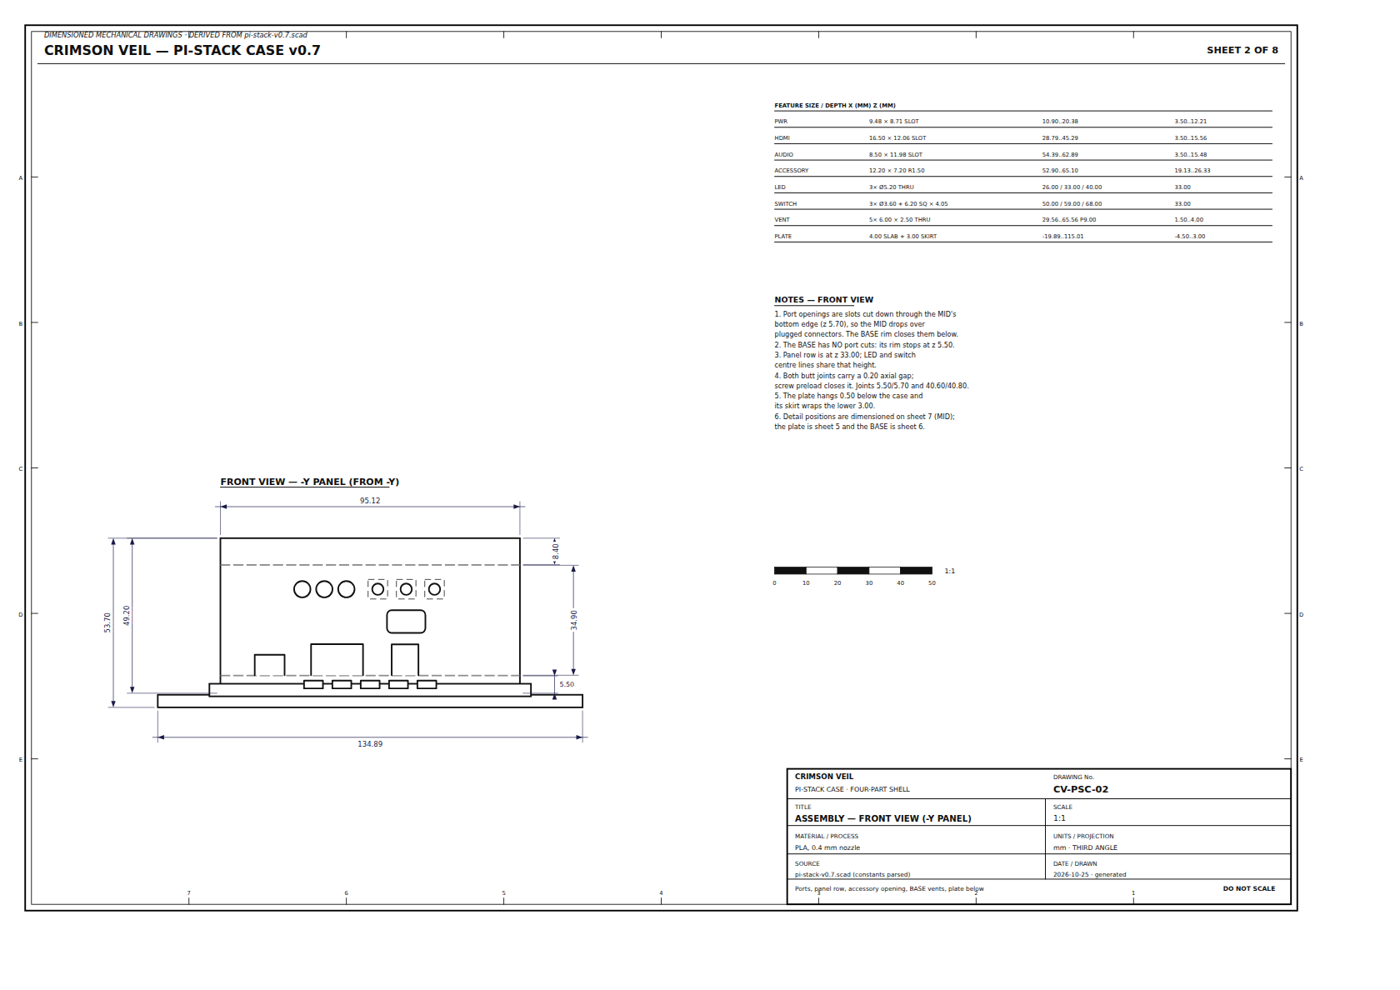
3Dmodels/case/drawings/assembly-front.png
