connythecreator/crimson-veil/3Dmodels/case/drawings/assembly-side.png

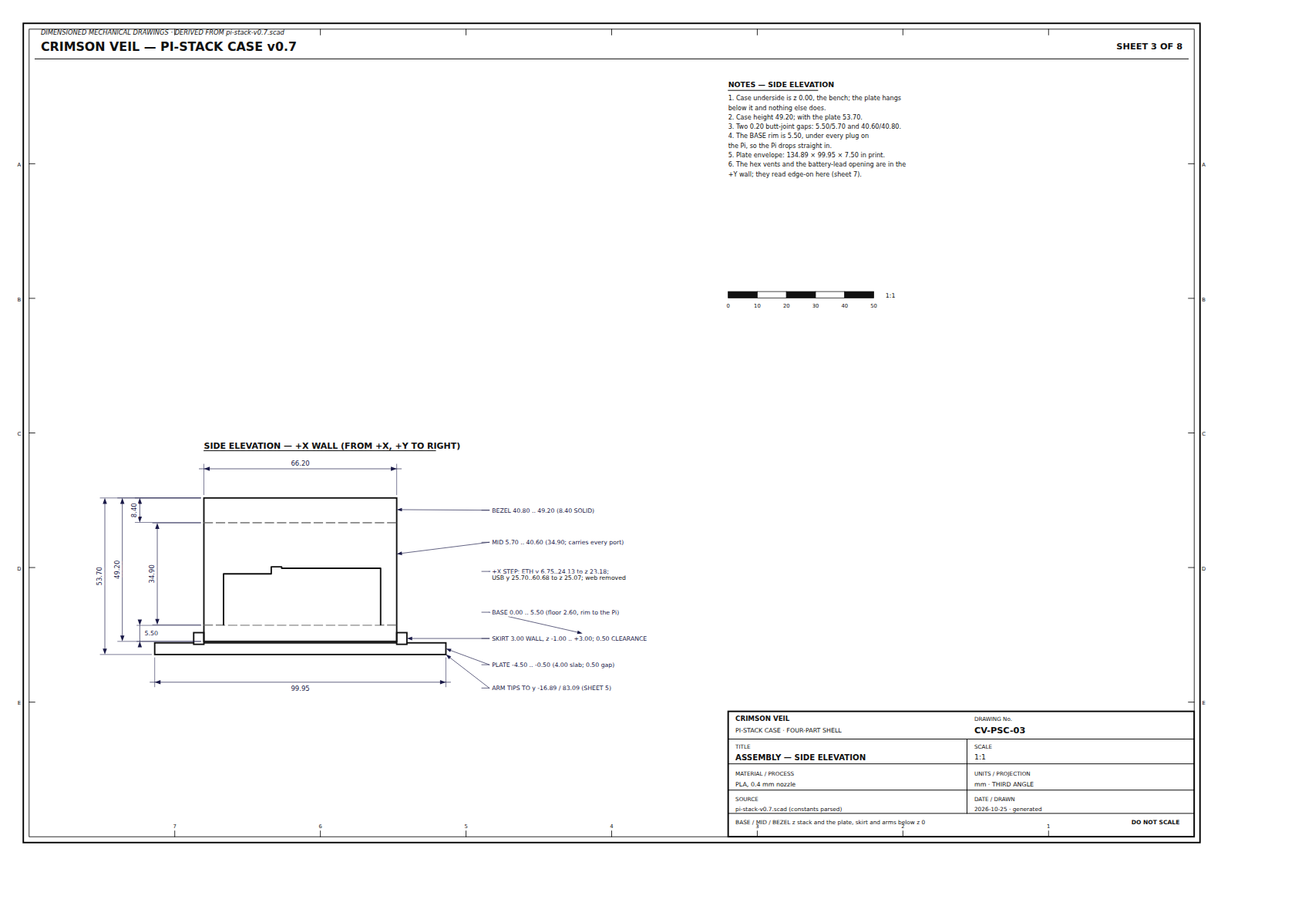
3Dmodels/case/drawings/assembly-side.png
