connythecreator/crimson-veil/3Dmodels/case/drawings/assembly-top.png

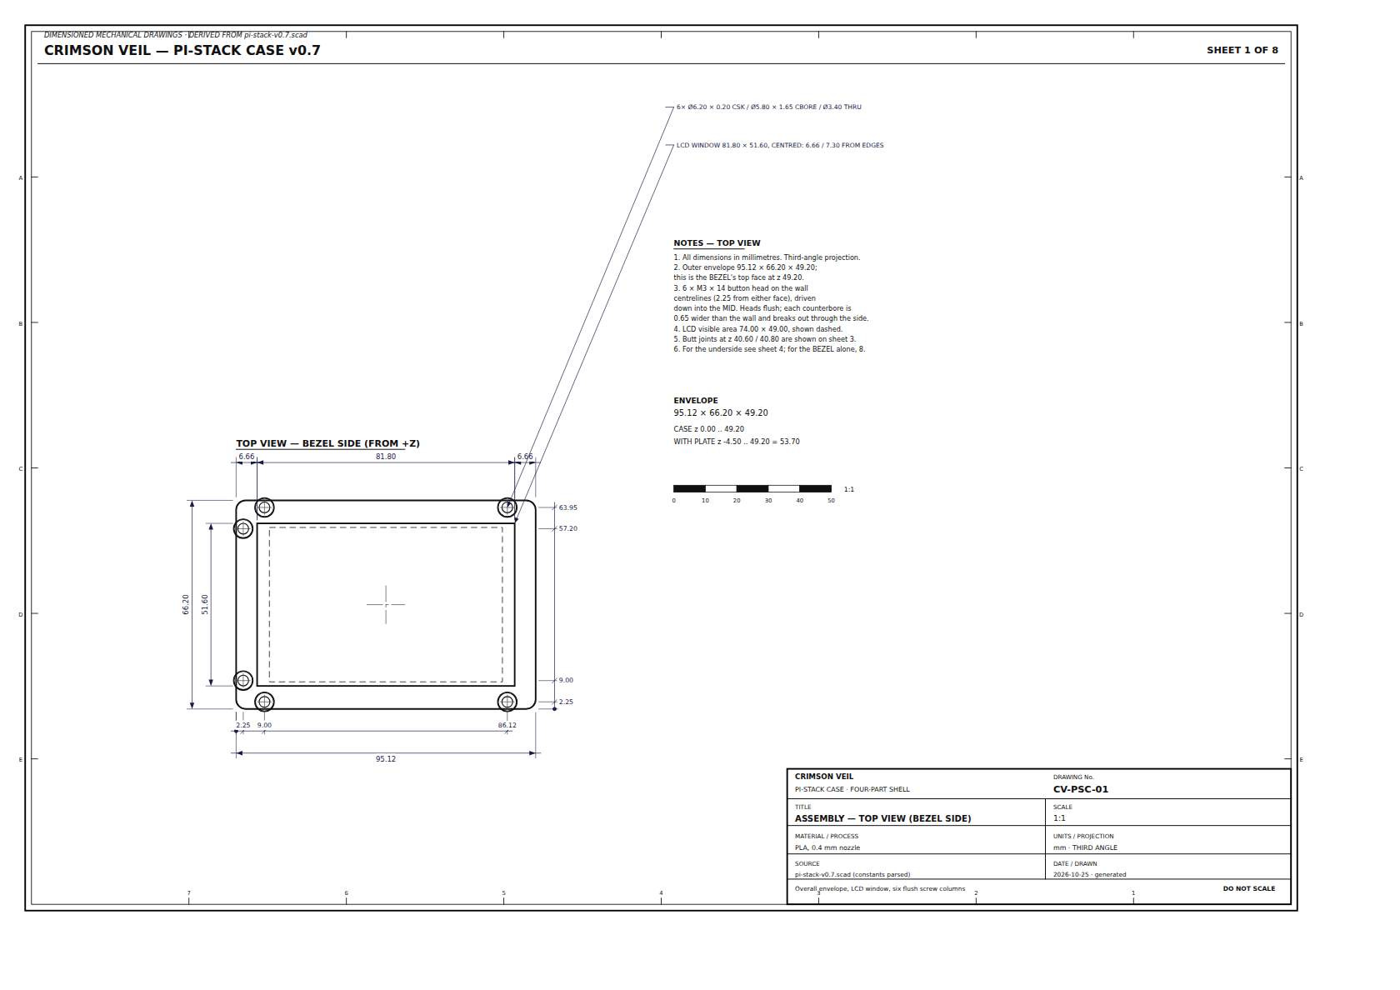
3Dmodels/case/drawings/assembly-top.png
