connythecreator/crimson-veil/3Dmodels/case/preview/v0.2-assembly.png

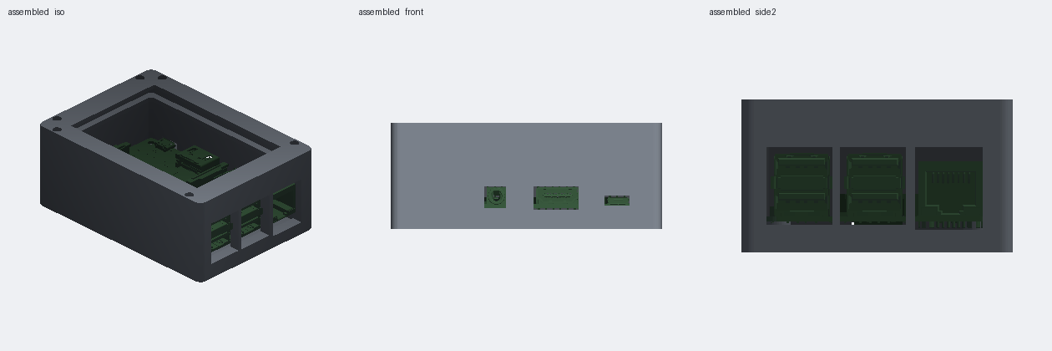
3Dmodels/case/preview/v0.2-assembly.png
