connythecreator/crimson-veil/3Dmodels/case/preview/v0.6-assembly.png

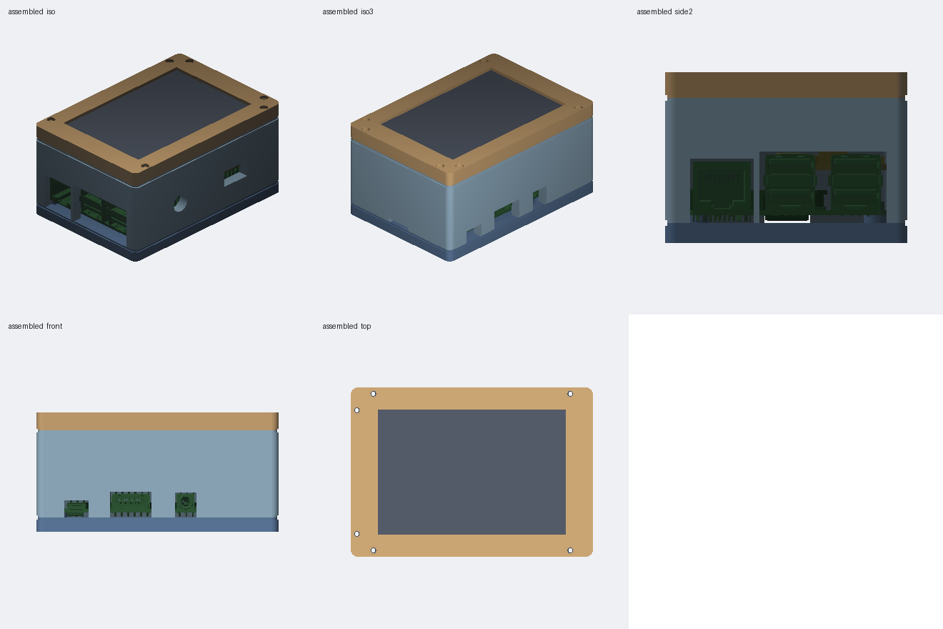
3Dmodels/case/preview/v0.6-assembly.png
