connythecreator/crimson-veil/software/reconstruction/PYEIT_VALIDATION.md

# pyEIT integration validation

Validated on 14 October 2026, and re-run against the current host and firmware
on 28 October 2026. The numerical solver, host pipeline and synthetic
end-to-end path pass. The as-built analog chain (excluding the mux bank) has
been bench-verified; the mux wiring and a full saline phantom have not.

## Reference comparison

The [EIT Community page](https://eit.org.uk/systems/software_python/pyEIT/pyEIT_index.html)
identifies pyEIT and links to its repository; it does not specify a separate
pipeline or API. Implementation checks used the official
[eitcom/pyEIT repository](https://github.com/eitcom/pyEIT), at commit
`106863ab123e7763e6cdad0d43b338672731121c`, and the installed 1.2.4 release.

| Reference | Project behavior and result |
| --- | --- |
| [BP example](https://github.com/eitcom/pyEIT/blob/106863ab123e7763e6cdad0d43b338672731121c/examples/eit_dynamic_bp.py) | Circular mesh, adjacent drive/sense, `parser_meas="std"`, `weight="none"`, and `solve(v1, v0, normalize=True)` match. The example's display multiplier is not needed for arbitrary-unit, per-frame PNG scaling. |
| [Protocol](https://github.com/eitcom/pyEIT/blob/106863ab123e7763e6cdad0d43b338672731121c/pyeit/eit/protocol.py) | Added support for upstream flat `[N, M, excitation_index]` rows while retaining 1.2.4's grouped sense pairs. Count is derived from the mapped rows. Drive electrodes are excluded from voltage measurement. |
| [BP normalization](https://github.com/eitcom/pyEIT/blob/106863ab123e7763e6cdad0d43b338672731121c/pyeit/eit/bp.py) | BP divides differences by `sign(v0.real)`. Finite readings and nonzero real baseline values are now required. This is not amplitude normalisation or an absolute conductivity estimate. |
| [Forward solver](https://github.com/eitcom/pyEIT/blob/106863ab123e7763e6cdad0d43b338672731121c/pyeit/eit/fem.py) | Independent test acquisition samples node potentials in firmware order, without consulting the adapter mapping. Reordered measurements agree with upstream boundary voltages. |
| [Mesh geometry](https://github.com/eitcom/pyEIT/blob/106863ab123e7763e6cdad0d43b338672731121c/pyeit/mesh/shape.py) | Electrode 0 lies at the left of the unit disk; increasing indices run clockwise through the upper half. Descending image y coordinates preserve quadrant orientation. Physical placement must match. |

## Corrections made

- Support both upstream protocol layouts, maintaining one-to-one ordering and
  sense polarity correction.
- Render difference maps on a symmetric zero-centred scale using the classic
  EIT blue/white/red ramp: positive conductivity change (lower impedance) is
  red, the baseline is white and negative change (higher impedance) is blue.
  Difference PNGs are RGB and the kiosk crops the full field; absolute maps
  stay grayscale and keep the luminance crop.
- Treat the mock impedance tables as post-calibration boundary voltages. The
  firmware now skips `Z = K / S` for a mock driver (`is_mock`), and an empty
  calibration leaves measurements unchanged instead of returning their
  reciprocal. Previously the mock's single baseline/target pair was inverted
  in the live kiosk and in the saved diagnostic figures.
- Require a captured baseline by default. The homogeneous unit-model reference
  is available only with explicit `allow_homogeneous_reference=True` for FEM
  simulations. Raw device counts do not have a demonstrated common scale with it.
- Add validated baseline capture and retention in `ScanSession`, WebSocket
  commands, and the kiosk's CALIB page. Frequency changes invalidate references;
  concurrent capture, scan and frequency changes are rejected.
- Validate serial frame lengths, finite values and indices; restore firmware
  order when indexed points arrive shuffled. Wholly unindexed legacy frames
  retain their incoming order.
- Prevent telemetry from consuming scan responses. Buffer incomplete serial
  lines so nonblocking polling does not discard part of a JSON frame. After a
  receive error, drain through a new identify handshake before another scan;
  delayed old responses cannot become a new target or baseline. Recovery keeps
  the requested frequency and rejects changed electrode counts.
- Keep the firmware command loop alive after scans and stop commands. Close
  partially opened resources after setup failure, and wait for an active scan
  before closing its resources.
- Add `requirements-pyeit.txt` with pyEIT 1.2.4 pinned. Base stub dependencies
  remain separate. Existing untracked user scripts and OneDrive conflict files
  were left unchanged.

## Test evidence

Last re-run on the consolidated tree: Python 3.12, NumPy 2.5.4, pyEIT 1.2.4,
pytest 9.x.

| Final run | Result |
| --- | --- |
| Full suite, installed pyEIT 1.2.4 (`pytest -q`) | **246 passed**, 13.3 seconds |
| Rust kiosk (`cargo test`) | **22 passed** |
| Whitespace/error check (`git diff --check`) | Passed |

The suite covers:

- Adjacent protocols for 4, 8 and 16 electrodes; eight electrodes yield 40 points.
- Independent FEM voltage acquisition, equal baseline/frame producing zero,
  and both increased and decreased conductivity localized in all four quadrants.
- Correct positive/negative reconstruction signs and finite image values.
- Zero-centred classic EIT rendering: positive conductivity change (lower
  impedance) is red, negative change (higher impedance) is blue, and the
  baseline is black. The mock firmware's baseline/target pair is verified end
  to end through the real command loop, including the calibration bypass.
- Rejection of malformed counts, electrode/frequency mismatches, NaN/Inf and
  zero-real baseline measurements.
- Real `Esp32Hardware` parsing → `ScanSession` baseline capture → `pipeline` →
  `PyEITSolver` → PNG → live localhost WebSocket client. The fake serial device
  sends independently generated FEM readings, shuffled indices and telemetry.
  Two target scans return the expected PNG exactly and retain the same baseline.
- Frequency invalidation, busy handling, capture failure/retry, cleanup after
  setup failure, shutdown during acquisition, and recovery from complete or
  partial delayed serial frames without reusing stale data.
- Firmware command-loop and calibration-file behavior using host-side driver
  doubles; these do not exercise real GPIO, I2C or an AD5933.

Run from the repository root:

```bash
.venv/bin/python -m pytest -q
cargo test --manifest-path kiosk-rs/Cargo.toml
```

For upstream verification, download the pyEIT repository at the commit above
into a separate folder and place that folder first on `sys.path` for a test
process. Do not overwrite the installed package. Both layouts are exercised
against actual pyEIT implementations, not just mocked protocol objects.

## Remaining limits

1. **Full-ring physical acquisition is unverified.** The AD5933 driver and
   analog chain (excluding the mux bank) are bench-verified, and
   `tools/hwtest.py` exercises the channel with a known fixture, but no
   full-ring capture has been compared against a phantom or an independent
   impedance analyser.
2. **Mux bank and full-ring scan are unverified.** The firmware drives four
   independent 3-bit address buses for the always-enabled, non-latching muxes,
   and `selftest` now runs an all-roles-per-electrode continuity check that
   fails if any electrode is open. The real mux wiring, channel matching and
   on-resistance still need bench confirmation, and `cal.json` must be
   re-derived with the mux bank in the signal path.
3. **Calibration is bench-derived, not clinical.** The production firmware now
   loads `cal.json` written by `firmware/mp-firm/hwtest/` and refuses scans when
   it is missing or invalid. That establishes gain and phase for the bench
   fixture; it does not establish polarity, units or geometry on the body.
4. **Default `SimHardware` is a demonstration model.** Its heuristic impedance
   values are not FEM-consistent. Quantitative validation uses independent FEM
   acquisition in the tests, not the default toy phantom.
5. **The Rust kiosk is covered by protocol/state tests only.** `cargo test`
   passes; the CALIB flow still needs a check on the target kiosk panel.

These checks demonstrate numerical and host transport correctness for synthetic
data. They do not establish physical phantom performance, clinical accuracy,
absolute conductivity, or robustness to electrode contact impedance and noise.
