connythecreator/crimson-veil/bleed/sim/afe_parts_build.asc

C2: cap; 0.1u
C3: cap; 0.1u
C17: cap; 10u
C18: cap; 0.1u
R4: res; 10k
R6: res; 47k
R7: res; 47k
R8: res; 10k
R9: res; 47k
R10: res; 47k
R11: res; 47k
R12: res; 47k
R13: res; 10k
R14: res; 47k
R15: res; 47k
R16: res; 10k
R17: res; 10k
R18: res; 10k
R20: res; 47k
R21: res; 47k
RL: res; 1k
RV1: res; 50k
U4: DIP8; AD620
U5A: opamp2; ADTL082
U5B: opamp2; ADTL082
U6A: opamp2; ADTL082
VCC: voltage; 5
VEE: voltage; 5
VOUT: voltage; DC 2.24 AC 1 SINE(2.24 {VAMP} 50k)
VVIN: voltage; 2.5
Named nets: 0, VOUT, IN_NET, VCC, VEE, DRV_P, DRV_M, VREF, AMP_OUT
Parts-constrained AFE: 5k current-set, AD620, 2.5 V ref
AD5933 output 3.00 V p-p at 2.24 V bias
RL = 1k electrode/load stand-in
.include ADTL082.lib
.include AD620.lib
.tran 0 2m 0 0.05u
.param VAMP 1.5
.step param VAMP list 1.5 0.735
