connythecreator/crimson-veil/bleed/sim/howland_parts.asc

C2: cap; 0.1u
C3: cap; 0.1u
CIN: cap; 10u
R6: res; 47k
R7: res; 47k
R8: res; 3.33k
R9: res; 47k
R10: res; 47k
R11: res; 47k
R12: res; 47k
R13: res; 3.33k
R14: res; 47k
R15: res; 47k
RBIAS: res; 47k
RL: res; 1k
U5A: opamp2; ADTL082
U5B: opamp2; ADTL082
VCC: voltage; 5
VEE: voltage; 5
VOUT: voltage; DC 0 AC 1 SINE(0 1.5 50k)
Named nets: 0, IN, IN_NET, VCC, VEE, DRV_P, DRV_M
Parts build: R8=R13=3.33k (3x10k), RBIAS=47k
Input HPF CIN=10u
.include ADTL082.lib
.tran 0 20m 0 0.05u
.meas tran iL_pp PP I(RL) FROM 19m TO 20m
