connythecreator/crimson-veil/bleed/sim/afe_body.asc

C2: cap; 0.1u
C3: cap; 0.1u
C17: cap; 10u
C18: cap; 0.1u
R4: res; 10k
R6: res; 47k
R7: res; 47k
R8: res; 10k
R9: res; 47k
R10: res; 47k
R11: res; 47k
R12: res; 47k
R13: res; 10k
R14: res; 47k
R15: res; 47k
R16: res; 10k
R17: res; 10k
R18: res; 10k
R20: res; 47k
R21: res; 47k
RBIAS: res; {RBIAS}
RCD1: res; 300
RCD2: res; 300
RCS1: res; 300
RCS2: res; 300
RT: res; {RTIS}
RV1: res; {RG}
U4: DIP8; AD620
U5A: opamp2; ADTL082
U5B: opamp2; ADTL082
U6A: opamp2; ADTL082
VCC: voltage; 5
VEE: voltage; 5
VOUT: voltage; DC 2.24 AC 1 SINE(2.24 1.5 50k)
VVIN: voltage; 2.5
Named nets: 0, VOUT, IN_NET, VCC, VEE, DRV_P, DRV_M, SP, SM, VREF, AMP_OUT
Tetrapolar body model: drive contact, tissue, sense contact
RTIS swept 10/20/50 ohm; RG 50k/4.95k
RBIAS swept 1e12 (none) and 10k (spare part)
.include ADTL082.lib
.include AD620.lib
.tran 0 2m 0 0.05u
.param RTIS 20
.param RG 50k
.param RBIAS 1e12
.step param RTIS list 10 20 50
.step param RG list 50k 4.95k
.step param RBIAS list 1e12 10k
