connythecreator/crimson-veil/bleed/sim/afe_body_ac.asc

C2: cap; 0.1u
C3: cap; 0.1u
C17: cap; 10u
C18: cap; 0.1u
R4: res; 10k
R6: res; 47k
R7: res; 47k
R8: res; 10k
R9: res; 47k
R10: res; 47k
R11: res; 47k
R12: res; 47k
R13: res; 10k
R14: res; 47k
R15: res; 47k
R16: res; 10k
R17: res; 10k
R18: res; 10k
R20: res; 47k
R21: res; 47k
RBIAS: res; 10k
RCD1: res; 300
RCD2: res; 300
RCS1: res; 300
RCS2: res; 300
RT: res; 20
RV1: res; 4.95k
U4: DIP8; AD620
U5A: opamp2; ADTL082
U5B: opamp2; ADTL082
U6A: opamp2; ADTL082
VCC: voltage; 5
VEE: voltage; 5
VOUT: voltage; DC 2.24 AC 1
VVIN: voltage; 2.5
Named nets: 0, VOUT, IN_NET, VCC, VEE, DRV_P, DRV_M, SP, SM, VREF, AMP_OUT
Body model frequency response, 500 Hz to 2 MHz
.include ADTL082.lib
.include AD620.lib
.ac dec 20 500 2meg
