connythecreator/crimson-veil/bleed/sim/afe_body_loads.asc

C2: cap; 0.1u
C3: cap; 0.1u
C17: cap; 10u
C18: cap; 0.1u
R4: res; 10k
R6: res; 47k
R7: res; 47k
R8: res; 10k
R9: res; 47k
R10: res; 47k
R11: res; 47k
R12: res; 47k
R13: res; 10k
R14: res; 47k
R15: res; 47k
R16: res; 10k
R17: res; 10k
R18: res; 10k
R20: res; 47k
R21: res; 47k
RBIAS: res; 10k
RCD1: res; {RC}
RCD2: res; {RC}
RCS1: res; {RC}
RCS2: res; {RC}
RT: res; 20
RV1: res; 4.95k
U4: DIP8; AD620
U5A: opamp2; ADTL082
U5B: opamp2; ADTL082
U6A: opamp2; ADTL082
VCC: voltage; 5
VEE: voltage; 5
VOUT: voltage; DC 2.24 AC 1 SINE(2.24 1.5 50k)
VVIN: voltage; 2.5
Named nets: 0, VOUT, IN_NET, VCC, VEE, DRV_P, DRV_M, SP, SM, VREF, AMP_OUT
Electrode contact sweep: 100 ohm to 4.7k
Sensed voltage should stay nearly flat (tetrapolar)
.include ADTL082.lib
.include AD620.lib
.tran 0 2m 0 0.05u
.param RC 300
.step param RC list 100 300 1k 2.2k 4.7k
