connythecreator/crimson-veil/bleed/sim/howland_1mA_peak.asc

C2: cap; 0.1u
C3: cap; 0.1u
R6: res; 47k
R7: res; 47k
R8: res; 1k
R9: res; 47k
R10: res; 47k
R11: res; 47k
R12: res; 47k
R13: res; 1k
R14: res; 47k
R15: res; 47k
RL: res; 1k
U5A: opamp2; ADTL082
U5B: opamp2; ADTL082
VCC: voltage; 5
VEE: voltage; 5
VOUT: voltage; DC 1.65 AC 1 SINE(1.65 1.0 50k)
Named nets: 0, IN, VCC, VEE, DRV_P, DRV_M
Mirrored Howland, 1 mA peak operating point
2 V p-p input, R8=R13=1k, 47k bridge, RL=1k
.include ADTL082.lib
.tran 0 20m 0 0.05u
.meas tran vin_pp PP V(IN) FROM 19m TO 20m
.meas tran iL_pp PP I(RL) FROM 19m TO 20m
.meas tran vL_pp PP V(DRV_P,DRV_M) FROM 19m TO 20m
