connythecreator/crimson-veil/bleed/sim/howland_5v_r2_dc.asc

C2: cap; 0.1u
C3: cap; 0.1u
R6: res; 47k
R7: res; 47k
R8: res; 1k
R9: res; 47k
R10: res; 47k
R11: res; 47k
R12: res; 47k
R13: res; 1k
R14: res; 47k
R15: res; 47k
RL: res; 1k
U5A: opamp2; ADTL082
U5B: opamp2; ADTL082
VCC: voltage; 5
VEE: voltage; 5
VOUT: voltage; DC 1.152 AC 1 SINE(1.152 0.735 50k)
Named nets: 0, IN, VCC, VEE, DRV_P, DRV_M
1000 mV p-p range: DC and AC load current
.include ADTL082.lib
.tran 0 20m 0 0.05u
.meas tran iL_pp PP I(RL) FROM 19m TO 20m
.meas tran iL_dc AVG I(RL) FROM 19m TO 20m
.meas tran vp_dc AVG V(DRV_P) FROM 19m TO 20m
.meas tran vm_dc AVG V(DRV_M) FROM 19m TO 20m
