connythecreator/crimson-veil/bleed/sim/howland_asdrawn.asc

C2: cap; 0.1u
C3: cap; 0.1u
R6: res; 47k
R7: res; 47k
R8: res; 47k
R9: res; 47k
R10: res; 47k
R11: res; 47k
R12: res; 47k
R13: res; 47k
R14: res; 47k
R15: res; 47k
RL: res; 1k
U5A: opamp2; ADTL082
U5B: opamp2; ADTL082
VCC: voltage; 5
VEE: voltage; 5
VOUT: voltage; DC 0 AC 1 SINE(0 0.5 50k)
Named nets: 0, IN, VCC, VEE, DRV_P, DRV_M
As drawn: every resistor 47k
R8/R13=47k gives only 26.5 uA p-p, not 1 mA
.include ADTL082.lib
.tran 0 400u 0 0.02u
.meas tran iL_pp PP I(RL) FROM 300u TO 400u
.meas tran ir8_pp PP I(R8) FROM 300u TO 400u
.meas tran ir13_pp PP I(R13) FROM 300u TO 400u
