connythecreator/crimson-veil/bleed/sim/howland_dcbias.asc

C2: cap; 0.1u
C3: cap; 0.1u
R6: res; 47k
R7: res; 47k
R8: res; 1k
R9: res; 47k
R10: res; 47k
R11: res; 47k
R12: res; 47k
R13: res; 1k
R14: res; 47k
R15: res; 47k
RL: res; 1k
U5A: opamp2; ADTL082
U5B: opamp2; ADTL082
VCC: voltage; 5
VEE: voltage; 5
VOUT: voltage; DC {VDC} AC 1 SINE({VDC} 0.5 50k)
Named nets: 0, IN, VCC, VEE, DRV_P, DRV_M
VOUT DC bias sweep: 0, 1.65, 2.5 V
.include ADTL082.lib
.param VDC 1.65
.step param VDC list 0 1.65 2.5
.tran 0 20m 0 0.05u
