connythecreator/crimson-veil/bleed/bleed.kicad_sch

## KiCad design bleed/bleed.kicad_sch (2026-10-27)

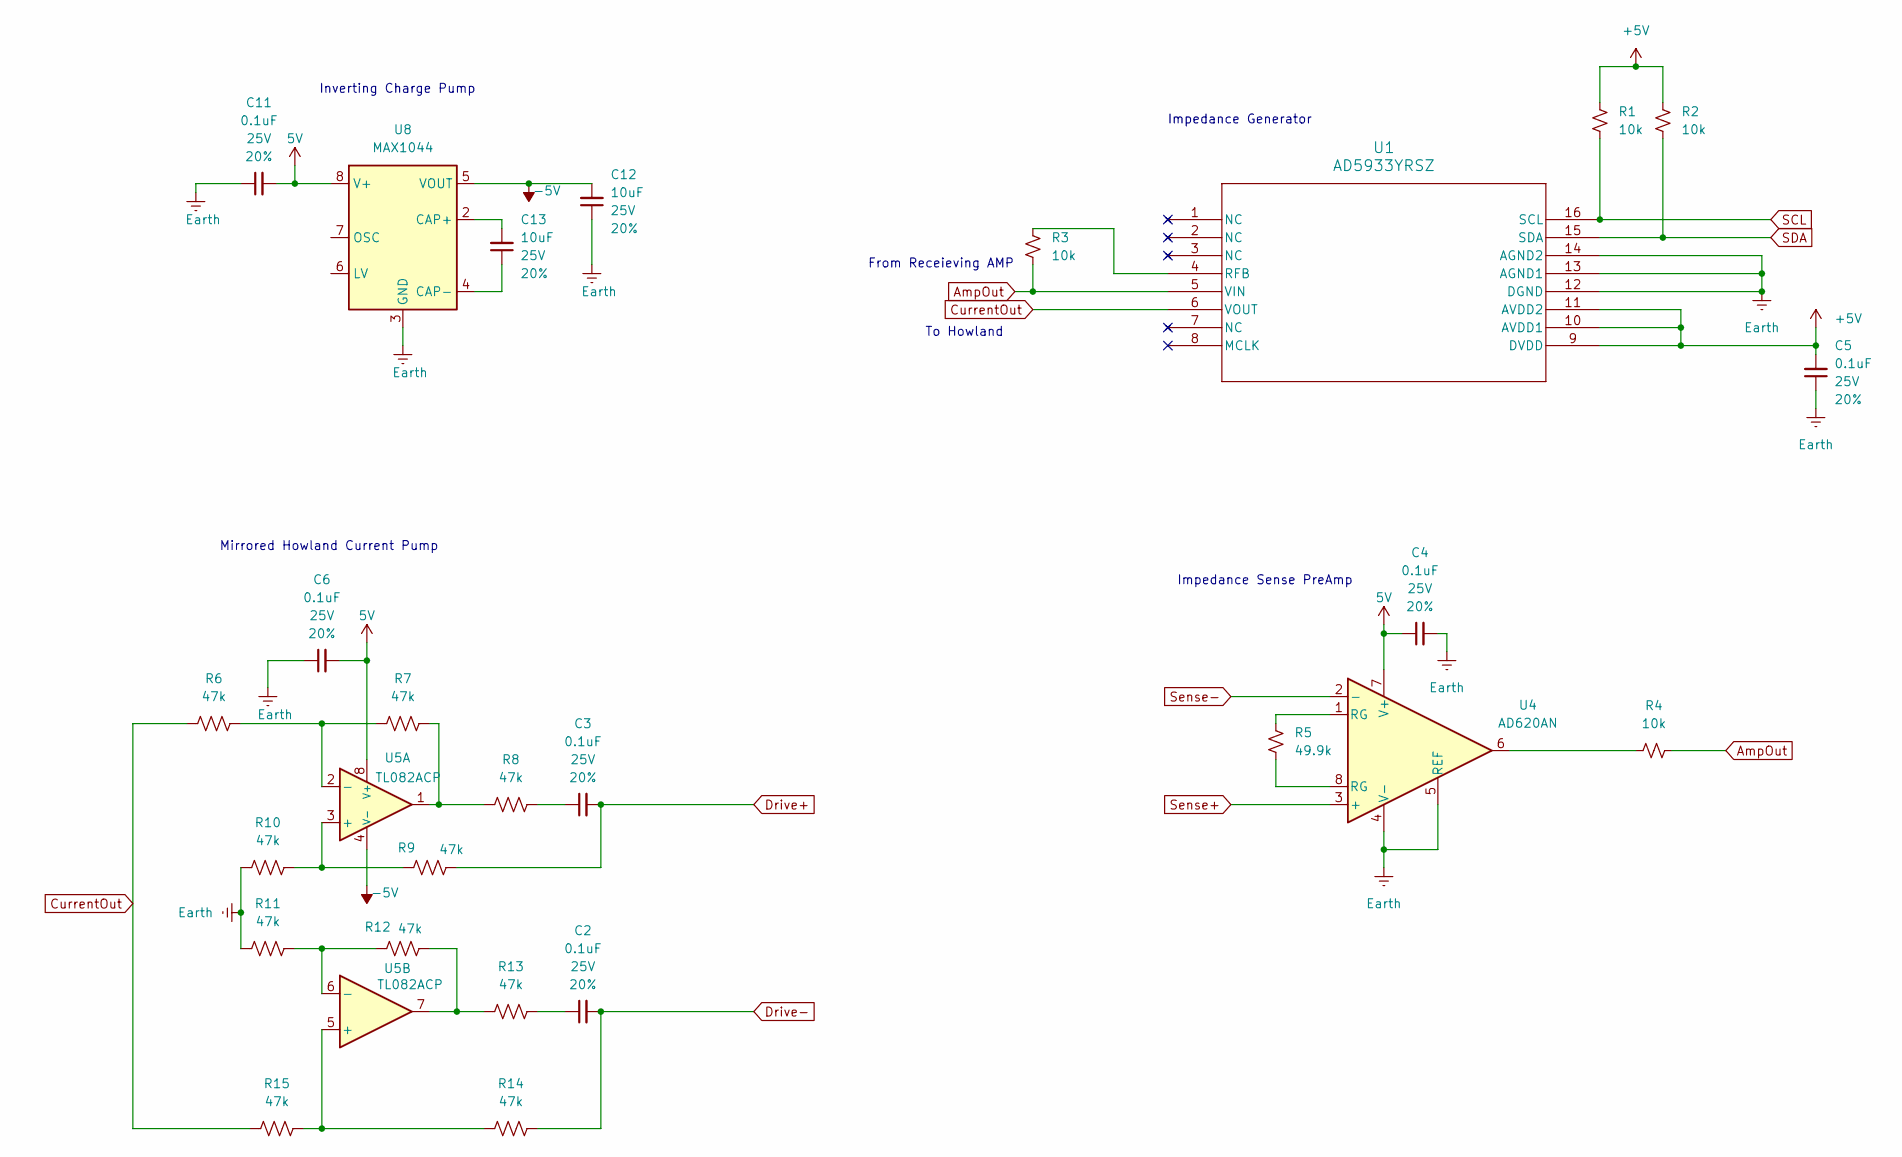
[picture p50: schematic bleed.kicad_sch]

Parts:
C2, C3, C4, C5, C6, C11: 0.1uF; C_0603_1608Metric; Voltage 25V; Tolerance 20%
C12, C13: 10uF; C_0603_1608Metric; Voltage 25V; Tolerance 20%
R1, R2, R3, R4: 10k; R_Axial_DIN0207_L6.3mm_D2.5mm_P7.62mm_Horizontal
R5: 49.9k; R_0603_1608Metric; Tolerance 1%
R6, R7, R8, R9, R10, R11, R12, R13, R14, R15: 47k; R_0603_1608Metric
U1: AD5933YRSZ; RS_16_ADI
U4: AD620AN; DIP-8_W7.62mm_LongPads
U5: TL082ACP; DIP-8_W7.62mm_LongPads
U8: MAX1044

Connections:
5V: C4.1, C6.2, C11.2, U4.7 (V+), U5.8 (V+), U8.8 (V+)
+5V: C5.2, R1.2, R2.2, U1.9 (DVDD), U1.10 (AVDD1), U1.11 (AVDD2)
-5V: C12.2, U5.4 (V-), U8.5 (VOUT)
AmpOut: R3.1, R4.1, U1.5 (VIN)
CurrentOut: R6.2, R15.2, U1.6 (VOUT)
Drive+: C3.2, R9.1
Drive-: C2.2, R14.1
Earth: C4.2, C5.1, C6.1, C11.1, C12.1, R10.2, R11.2, U1.12 (DGND), U1.13 (AGND1), U1.14 (AGND2), U4.4 (V-), U4.5 (REF), U8.3 (GND)
unnamed: C2.1, R13.1
unnamed: C3.1, R8.1
unnamed: C13.1, U8.4 (CAP-)
unnamed: C13.2, U8.2 (CAP+)
unnamed: R3.2, U1.4 (RFB)
unnamed: R4.2, U4.6
unnamed: R5.1, U4.8 (RG)
unnamed: R5.2, U4.1 (RG)
unnamed: R6.1, R7.2, U5.2 (-)
unnamed: R7.1, R8.2, U5.1
unnamed: R9.2, R10.1, U5.3 (+)
unnamed: R11.1, R12.2, U5.6 (-)
unnamed: R12.1, R13.2, U5.7
unnamed: R14.2, R15.1, U5.5 (+)
SCL: R1.1, U1.16 (SCL)
SDA: R2.1, U1.15 (SDA)
Sense+: U4.3 (+)
Sense-: U4.2 (-)

Notes on the sheet:
To Howland
Inverting Charge Pump
From Receieving AMP
Impedance Generator
Impedance Sense PreAmp
Mirrored Howland Current Pump
