connythecreator/crimson-veil/bleed/bleed_parts_build.kicad_sch

## KiCad design bleed/bleed_parts_build.kicad_sch (2026-11-07)

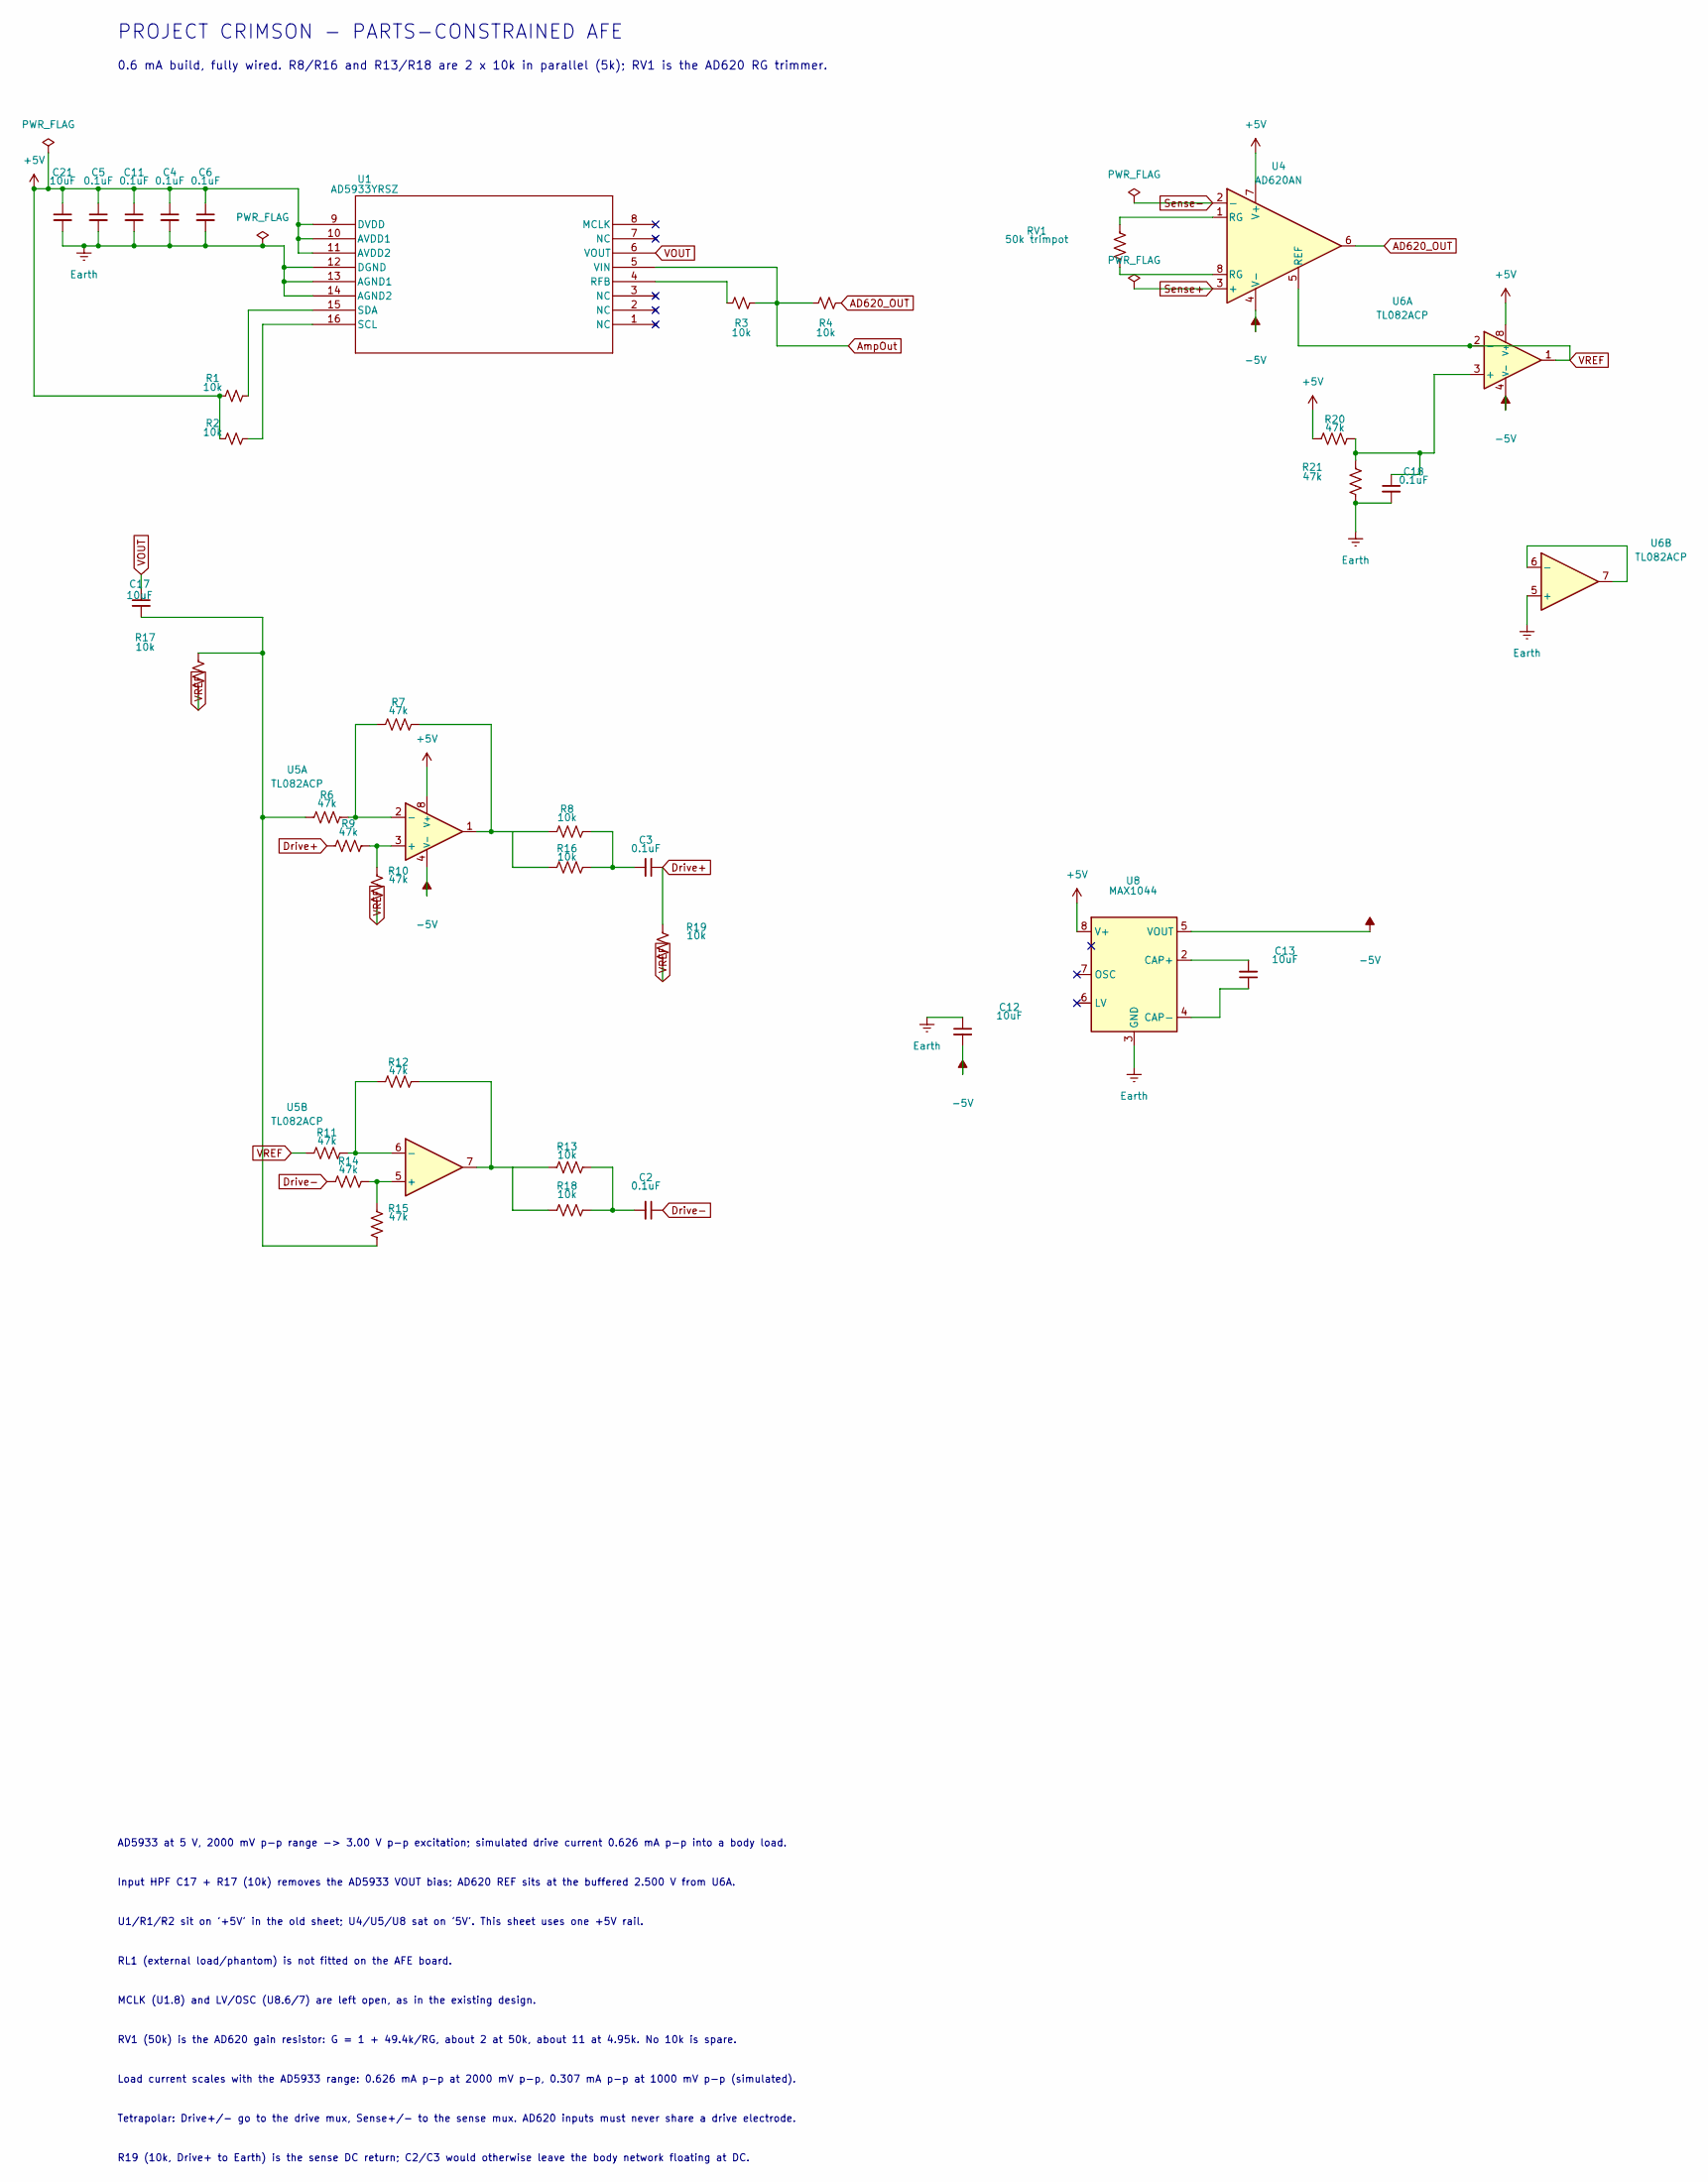
[picture p51: schematic bleed_parts_build.kicad_sch]

Parts:
C2, C3, C4, C5, C6, C11, C18: 0.1uF; C_0603_1608Metric
C12, C13, C17, C21: 10uF; C_0603_1608Metric
R1, R2, R3, R4, R8, R13, R16, R17, R18, R19: 10k; R_Axial_DIN0207_L6.3mm_D2.5mm_P7.62mm_Horizontal
R6, R7, R9, R10, R11, R12, R14, R15, R20, R21: 47k; R_Axial_DIN0207_L6.3mm_D2.5mm_P7.62mm_Horizontal
RV1: 50k trimpot; R_Axial_DIN0207_L6.3mm_D2.5mm_P7.62mm_Horizontal
U1: AD5933YRSZ; RS_16_ADI
U4: AD620AN; DIP-8_W7.62mm_LongPads
U5, U6: TL082ACP; DIP-8_W7.62mm_LongPads
U8: MAX1044

Connections:
+5V: C4.1, C5.1, C6.1, C11.1, C21.1, R1.1, R2.1, R20.2, U1.9 (DVDD), U1.10 (AVDD1), U1.11 (AVDD2), U4.7 (V+), U5.8 (V+), U6.8 (V+), U8.8 (V+)
-5V: C12.2, U4.4 (V-), U5.4 (V-), U6.4 (V-), U8.5 (VOUT)
AD620_OUT: R4.2, U4.6
AmpOut: R3.1, R4.1, U1.5 (VIN)
Drive+: C3.1, R9.2, R19.1
Drive-: C2.1, R14.2
Earth: C4.2, C5.2, C6.2, C11.2, C12.1, C18.2, C21.2, R21.2, U1.12 (DGND), U1.13 (AGND1), U1.14 (AGND2), U6.5 (+), U8.3 (GND)
unnamed: C2.2, R13.2, R18.2
unnamed: C3.2, R8.2, R16.2
unnamed: C13.1, U8.4 (CAP-)
unnamed: C13.2, U8.2 (CAP+)
unnamed: C17.2, R6.1, R15.2, R17.1
unnamed: C18.1, R20.1, R21.1, U6.3 (+)
unnamed: R1.2, U1.15 (SDA)
unnamed: R2.2, U1.16 (SCL)
unnamed: R3.2, U1.4 (RFB)
unnamed: R6.2, R7.1, U5.2 (-)
unnamed: R9.1, R10.1, U5.3 (+)
unnamed: R11.2, R12.1, U5.6 (-)
unnamed: R12.2, R13.1, R18.1, U5.7
unnamed: R14.1, R15.1, U5.5 (+)
unnamed: R7.2, R8.1, R16.1, U5.1
unnamed: RV1.1, U4.1 (RG)
unnamed: RV1.2, U4.8 (RG)
unnamed: U6.6 (-), U6.7
Sense+: U4.3 (+)
Sense-: U4.2 (-)
VOUT: C17.1, U1.6 (VOUT)
VREF: R10.2, R11.1, R17.2, R19.2, U4.5 (REF), U6.1, U6.2 (-)

Notes on the sheet:
PROJECT CRIMSON - PARTS-CONSTRAINED AFE
U1/R1/R2 sit on '+5V' in the old sheet; U4/U5/U8 sat on '5V'. This sheet uses one +5V rail.
RV1 (50k) is the AD620 gain resistor: G = 1 + 49.4k/RG, about 2 at 50k, about 11 at 4.95k. No 10k is spare.
Tetrapolar: Drive+/- go to the drive mux, Sense+/- to the sense mux. AD620 inputs must never share a drive electrode.
Input HPF C17 + R17 (10k) removes the AD5933 VOUT bias; AD620 REF sits at the buffered 2.500 V from U6A.
RL1 (external load/phantom) is not fitted on the AFE board.
AD5933 at 5 V, 2000 mV p-p range -> 3.00 V p-p excitation; simulated drive current 0.626 mA p-p into a body load.
MCLK (U1.8) and LV/OSC (U8.6/7) are left open, as in the existing design.
R19 (10k, Drive+ to Earth) is the sense DC return; C2/C3 would otherwise leave the body network floating at DC.
0.6 mA build, fully wired. R8/R16 and R13/R18 are 2 x 10k in parallel (5k); RV1 is the AD620 RG trimmer.
Load current scales with the AD5933 range: 0.626 mA p-p at 2000 mV p-p, 0.307 mA p-p at 1000 mV p-p (simulated).
