connythecreator/crimson-veil/bleed/untitled.kicad_sch

## KiCad design bleed/untitled.kicad_sch (2026-10-27)

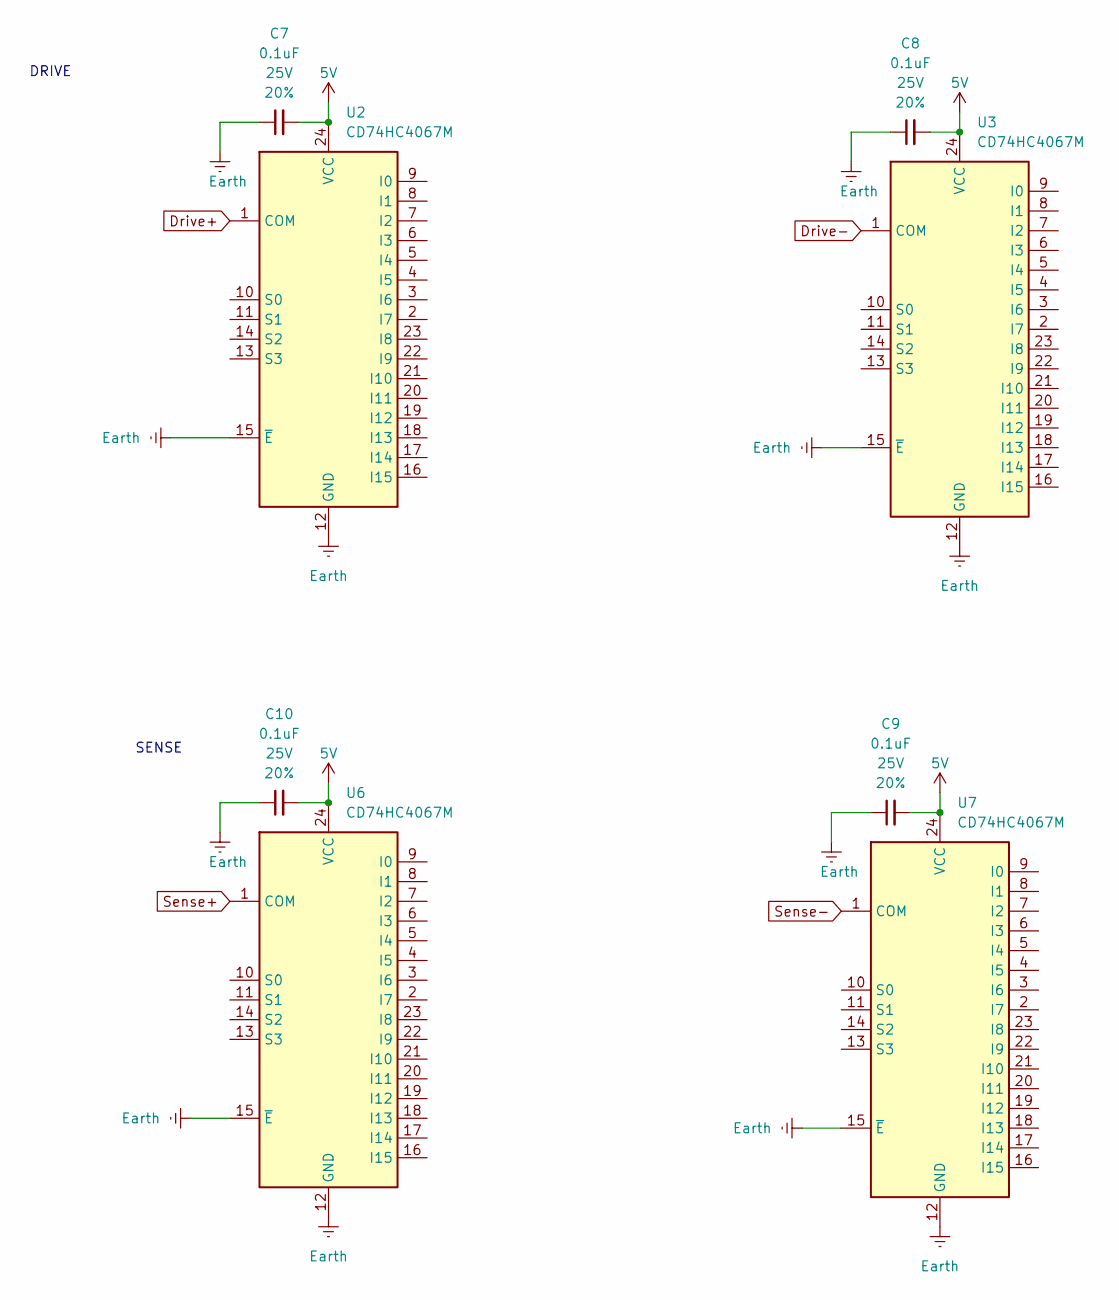
[picture p52: schematic untitled.kicad_sch]

Parts:
C7, C8, C9, C10: 0.1uF; C_0603_1608Metric; Voltage 25V; Tolerance 20%
U2, U3, U6, U7: CD74HC4067M; SOIC-24W_7.5x15.4mm_P1.27mm

Connections:
5V: C7.2, C8.2, C9.2, C10.2, U2.24 (VCC), U3.24 (VCC), U6.24 (VCC), U7.24 (VCC)
Drive+: U2.1 (COM)
Drive-: U3.1 (COM)
Earth: C7.1, C8.1, C9.1, C10.1, U2.12 (GND), U2.15 (~E), U3.12 (GND), U3.15 (~E), U6.12 (GND), U6.15 (~E), U7.12 (GND), U7.15 (~E)
Sense+: U6.1 (COM)
Sense-: U7.1 (COM)

Notes on the sheet:
DRIVE
SENSE
