connythecreator/crimson-veil/kiosk-rs/src/app.rs

//! Kiosk application: state machine, networking glue, and egui frame.

use std::time::{Duration, Instant};

use eframe::egui;
use egui::{Color32, ColorImage, TextureHandle, TextureOptions};

use crate::fx::ScanFx;
use crate::hud::{self, Action};
use crate::net::{Net, NetEvent};
use crate::protocol::{Check, ClientMessage, ServerMessage};

pub const FPS: u64 = 15;
pub const FRAME: Duration = Duration::from_millis(1000 / FPS);
// Effects animate at a higher cadence for smoothness (Pi 3 can afford this
// briefly): ~30 fps while scanning/revealing.
pub const ANIM_FRAME: Duration = Duration::from_millis(33);
// Debounce intervals (seconds): scan often while the user is interacting,
// back off when idle. The server enforces these; sent on continuous start.
// Overridable via CV_ACTIVE_INTERVAL_S / CV_IDLE_INTERVAL_S for testing.
pub fn active_interval_s() -> f64 {
    env_f64("CV_ACTIVE_INTERVAL_S", 15.0)
}
pub fn idle_interval_s() -> f64 {
    env_f64("CV_IDLE_INTERVAL_S", 30.0)
}
fn env_f64(key: &str, default: f64) -> f64 {
    std::env::var(key).ok().and_then(|v| v.parse().ok()).unwrap_or(default)
}
fn env_f32(key: &str, default: f32) -> f32 {
    std::env::var(key).ok().and_then(|v| v.parse().ok()).unwrap_or(default)
}
fn env_u32(key: &str, default: u32) -> u32 {
    std::env::var(key).ok().and_then(|v| v.parse().ok()).unwrap_or(default)
}

/// Turn a scan PNG into a circular disc: crop a square centred on the content
/// and bake a hard circular alpha so the padding corners disappear.
///
/// `full_field` is used for the RGB difference heatmap, where the circular
/// field already fills the square and a black baseline is valid content. The
/// grayscale absolute map keeps the luminance bounding-box crop.
fn to_disc(src: &image::RgbaImage, full_field: bool) -> ColorImage {
    let (w, h) = (src.width() as i32, src.height() as i32);
    if w == 0 || h == 0 {
        return ColorImage::default();
    }
    let lum = |p: &image::Rgba<u8>| (p[0] as u32 + p[1] as u32 + p[2] as u32) / 3;

    // Content bounds: pixels brighter than the near-black background.
    let (mut minx, mut miny, mut maxx, mut maxy) = (w, h, -1i32, -1i32);
    if !full_field {
        for y in 0..h {
            for x in 0..w {
                if lum(src.get_pixel(x as u32, y as u32)) > 18 {
                    minx = minx.min(x);
                    miny = miny.min(y);
                    maxx = maxx.max(x);
                    maxy = maxy.max(y);
                }
            }
        }
    }
    if full_field || maxx < 0 {
        // The heatmap square is the field; or the grayscale frame is all
        // black. Either way, mask the whole square to a circle.
        minx = 0;
        miny = 0;
        maxx = w - 1;
        maxy = h - 1;
    }

    let (cx, cy) = ((minx + maxx) as f32 / 2.0, (miny + maxy) as f32 / 2.0);
    // Inscribed square side = the smaller content extent (the body is round).
    // Extents are inclusive pixel coordinates, so add one for the pixel count.
    let side = ((maxx - minx + 1).min(maxy - miny + 1)).max(2) as f32;
    let radius = side / 2.0;
    let out = side as usize;
    let mut pixels = vec![egui::Color32::TRANSPARENT; out * out];
    let r2 = radius * radius;

    for oy in 0..out {
        for ox in 0..out {
            let dx = ox as f32 + 0.5 - radius;
            let dy = oy as f32 + 0.5 - radius;
            if dx * dx + dy * dy > r2 {
                continue; // outside the disc -> transparent
            }
            let sx = (cx + dx).round().clamp(0.0, (w - 1) as f32) as u32;
            let sy = (cy + dy).round().clamp(0.0, (h - 1) as f32) as u32;
            let p = src.get_pixel(sx, sy);
            pixels[oy * out + ox] = egui::Color32::from_rgb(p[0], p[1], p[2]);
        }
    }

    ColorImage {
        size: [out, out],
        pixels,
    }
}

#[derive(Debug, Clone, Copy, PartialEq, Eq)]
pub enum Connection {
    Connecting,
    Connected,
}

/// Left-hand menu destinations.
#[derive(Debug, Clone, Copy, PartialEq, Eq)]
pub enum Page {
    Scan,
    Settings,
    Calibration,
}

/// Pre-start self-test, or the main HUD.
#[derive(Debug, Clone, Copy, PartialEq, Eq)]
pub enum Phase {
    SelfTest,
    Main,
}

pub struct AppState {
    pub connection: Connection,
    pub page: Page,
    pub phase: Phase,
    pub checks: Vec<Check>,
    pub self_test_running: bool,
    pub self_test_done: bool,
    pub baseline_ready: bool,
    pub capturing_baseline: bool,
    pub backend: String,
    pub solver: String,
    pub n_electrodes: u32,
    pub frequency_hz: f64,
    pub active_interval_s: f64,
    pub idle_interval_s: f64,
    pub scanning: bool,
    pub continuous: bool,
    pub scan_count: u32,
    pub last_result: Option<Instant>,
    pub boot_error: Option<String>,
    pub last_error: Option<String>,
    pub frames: u64,
    // Device metrics.
    pub battery_pct: Option<f32>,
    pub battery_charging: bool,
    pub on_battery: bool,
    pub battery_v: Option<f32>,
    pub runtime_s: Option<u32>,
    pub low_v: Option<f32>,
    pub temp_wittypi_c: Option<f32>,
    pub temp_esp32_c: Option<f32>,
    pub temp_ad5933_c: Option<f32>,
    pub temp_pi_c: Option<f32>,
    // Difference-image anomaly alert.
    pub anomaly_score: f32,
    pub anomaly_streak: u32,
    pub anomaly_alert: bool,
    pub anomaly_threshold: f32,
    pub anomaly_persist_scans: u32,
    pub demo_mode: bool,
    pub demo_busy: bool,
}

impl Default for AppState {
    fn default() -> Self {
        Self {
            connection: Connection::Connecting,
            page: Page::Scan,
            phase: Phase::SelfTest,
            checks: Vec::new(),
            self_test_running: false,
            self_test_done: false,
            baseline_ready: false,
            capturing_baseline: false,
            backend: "connecting...".into(),
            solver: "-".into(),
            n_electrodes: 8,
            frequency_hz: 0.0,
            active_interval_s: active_interval_s(),
            idle_interval_s: idle_interval_s(),
            scanning: false,
            continuous: false,
            scan_count: 0,
            last_result: None,
            boot_error: None,
            last_error: None,
            frames: 0,
            battery_pct: None,
            battery_charging: false,
            on_battery: false,
            battery_v: None,
            runtime_s: None,
            low_v: None,
            temp_wittypi_c: None,
            temp_esp32_c: None,
            temp_ad5933_c: None,
            temp_pi_c: None,
            anomaly_score: 0.0,
            anomaly_streak: 0,
            anomaly_alert: false,
            anomaly_threshold: env_f32("CV_ANOMALY_THRESHOLD", 0.05),
            anomaly_persist_scans: env_u32("CV_ANOMALY_PERSIST_SCANS", 3),
            demo_mode: false,
            demo_busy: false,
        }
    }
}

impl AppState {
    pub fn connection_label(&self) -> (String, Color32) {
        if let Some(err) = &self.boot_error {
            return (format!("BOOT ERROR  ({err})"), Color32::from_rgb(255, 59, 74));
        }
        if let Some(err) = &self.last_error {
            return (format!("SCAN ERROR  ({err})"), Color32::from_rgb(255, 59, 74));
        }
        let base = match self.connection {
            Connection::Connecting => "CONNECTING".to_string(),
            Connection::Connected => {
                if self.scanning {
                    "SCANNING".to_string()
                } else if self.continuous {
                    "CONTINUOUS".to_string()
                } else {
                    "READY".to_string()
                }
            }
        };
        let color = match self.connection {
            Connection::Connecting => Color32::from_rgb(234, 179, 8),
            Connection::Connected => Color32::from_rgb(34, 197, 94),
        };
        (base, color)
    }

    /// pyEIT reconstruction needs a measured reference before scans.
    pub fn needs_baseline(&self) -> bool {
        self.solver == "pyeit" && !self.baseline_ready
    }

    pub fn can_scan(&self) -> bool {
        !self.needs_baseline()
    }
}

pub struct KioskApp {
    net: Net,
    state: AppState,
    texture: Option<TextureHandle>,
    pending_image: Option<ColorImage>,
    fx: ScanFx,
    dev: bool,
    self_test_requested: bool,
    self_test_started: Instant,
    started: Instant,
}

impl KioskApp {
    pub fn new(url: &str, dev: bool) -> Self {
        let mut state = AppState::default();
        if dev {
            // Mock visuals: skip the hardware gate entirely.
            state.phase = Phase::Main;
        }
        Self {
            net: Net::new(url),
            state,
            texture: None,
            pending_image: None,
            fx: ScanFx::default(),
            dev,
            self_test_requested: false,
            self_test_started: Instant::now(),
            started: Instant::now(),
        }
    }

    fn handle(&mut self, event: NetEvent) {
        match event {
            NetEvent::Connected => {
                self.state.connection = Connection::Connected;
                self.request_self_test();
            }
            NetEvent::Disconnected => {
                self.state.connection = Connection::Connecting;
                self.state.boot_error = None;
                self.state.scanning = false;
                self.state.capturing_baseline = false;
                self.state.demo_busy = false;
                self.fx.abort();
                // Allow a fresh request when the service reconnects.
                self.self_test_requested = false;
            }
            NetEvent::Server(msg) => self.handle_server(msg),
            NetEvent::Image { id, width, height, png } => match image::load_from_memory(&png) {
                Ok(img) => {
                    // RGB PNGs are the difference heatmap and fill the square;
                    // grayscale PNGs are absolute maps and use the luminance box.
                    let full_field = img.color().has_color();
                    let rgba = img.to_rgba8();
                    if width != rgba.width() || height != rgba.height() {
                        log::warn!(
                            "scan {id}: header {width}x{height} != PNG {}x{}",
                            rgba.width(),
                            rgba.height()
                        );
                    }
                    self.pending_image = Some(to_disc(&rgba, full_field));
                }
                Err(err) => log::warn!("failed to decode scan {id} PNG: {err}"),
            },
        }
    }

    fn handle_server(&mut self, msg: ServerMessage) {
        match msg.kind.as_str() {
            "ready" => {
                self.state.backend = msg.backend;
                self.state.solver = msg.solver;
                self.state.n_electrodes = msg.n_electrodes;
                self.state.frequency_hz = msg.frequency_hz;
                self.state.baseline_ready = msg.baseline_ready;
                self.state.boot_error = None;
            }
            "baseline_captured" => {
                self.state.baseline_ready = true;
                self.state.capturing_baseline = false;
                self.state.frequency_hz = msg.frequency_hz;
                self.state.n_electrodes = msg.n_electrodes;
                self.state.last_error = None;
                self.state.anomaly_streak = 0;
                self.state.anomaly_alert = false;
                self.state.anomaly_score = 0.0;
            }
            "self_test_result" => {
                self.state.checks = msg.checks;
                self.state.self_test_running = false;
                self.state.self_test_done = true;
            }
            "metrics" => {
                self.state.battery_pct = msg.battery_pct;
                self.state.battery_charging = msg.battery_charging;
                self.state.on_battery = msg.on_battery;
                self.state.battery_v = msg.battery_v;
                self.state.runtime_s = msg.runtime_s;
                self.state.low_v = msg.low_v;
                self.state.temp_wittypi_c = msg.temp_wittypi_c;
                self.state.temp_esp32_c = msg.temp_esp32_c;
                self.state.temp_ad5933_c = msg.temp_ad5933_c;
                self.state.temp_pi_c = msg.temp_pi_c;
            }
            "firmware_uploaded" => {
                self.state.demo_busy = false;
                self.state.demo_mode = msg.mock;
                self.state.baseline_ready = false;
                self.state.last_error = None;
                if msg.electrodes >= 4 {
                    self.state.n_electrodes = msg.electrodes;
                }
            }
            "mock_mode_result" => {
                self.state.last_error = None;
            }
            "boot_error" => {
                self.state.boot_error = Some(msg.message);
                self.state.demo_busy = false;
            }
            "scan_error" => {
                self.state.last_error = Some(msg.message);
                self.state.scanning = false;
                self.state.capturing_baseline = false;
                self.state.demo_busy = false;
                self.fx.abort();
            }
            "progress" => {
                self.state.scanning = true;
                self.fx.start_scan();
            }
            "state" => {
                self.state.continuous = msg.continuous;
                self.state.scanning = msg.scanning;
                if msg.scanning {
                    self.fx.start_scan();
                } else if !msg.continuous {
                    // Stopped: any cancelled acquisition will never deliver a
                    // frame, so clear the pulsing field.
                    self.fx.abort();
                }
            }
            "scan_result" => {
                self.state.scanning = true; // animating until the image frame lands
                update_anomaly_state(&mut self.state, msg.anomaly_score);
                self.fx.start_scan();
            }
            _ => {}
        }
    }

    fn request_self_test(&mut self) {
        if self.dev || self.state.phase != Phase::SelfTest || self.self_test_requested {
            return;
        }
        if !self.net.is_connected() {
            return;
        }
        self.self_test_requested = true;
        self.state.self_test_running = true;
        self.state.self_test_done = false;
        self.state.checks.clear();
        self.self_test_started = Instant::now();
        self.net.send(&ClientMessage::SelfTest);
    }

    /// Close/reopen the hardware backend and re-run the self-test. This is the
    /// UI recovery path when the ESP was unplugged, reset, or dropped off USB.
    fn retry_hardware(&mut self) {
        if self.dev || !self.net.is_connected() {
            return;
        }
        self.state.phase = Phase::SelfTest;
        self.self_test_requested = true;
        self.state.self_test_running = true;
        self.state.self_test_done = false;
        self.state.checks.clear();
        self.state.boot_error = None;
        self.self_test_started = Instant::now();
        self.net.send(&ClientMessage::HardwareRetry);
    }

    fn dismiss_bleeding_alert(&mut self) {
        self.state.anomaly_alert = false;
        self.state.anomaly_streak = 0;
    }

    /// Upload the mock firmware (or restore real firmware if already in demo),
    /// then let the service capture the homogeneous mock baseline.
    fn enable_demo_mode(&mut self) {
        if self.dev || self.state.demo_busy || !self.net.is_connected() {
            return;
        }
        self.state.demo_busy = true;
        self.state.last_error = None;
        self.state.anomaly_alert = false;
        self.state.anomaly_streak = 0;
        let mock = !self.state.demo_mode;
        self.net.send(&ClientMessage::UploadFirmware {
            mock,
            electrodes: self.state.n_electrodes.max(4),
        });
    }

    /// Force the mock target table and immediately run one scan. Three presses
    /// (or subsequent SINGLE SCAN presses) satisfy the persistence alert.
    fn inject_anomaly(&mut self) {
        if self.dev
            || self.state.demo_busy
            || !self.state.demo_mode
            || !self.state.baseline_ready
            || self.state.scanning
            || !self.net.is_connected()
        {
            return;
        }
        self.state.last_error = None;
        self.net.send(&ClientMessage::MockMode {
            mode: "target".into(),
        });
        self.send_scan();
    }

    /// Capture the measured reference required by pyEIT.
    fn request_baseline(&mut self) {
        if self.state.scanning
            || self.state.continuous
            || self.state.capturing_baseline
            || self.state.solver != "pyeit"
        {
            return;
        }
        self.state.capturing_baseline = true;
        self.state.last_error = None;
        self.net.send(&ClientMessage::CaptureBaseline {
            id: "kiosk-baseline".into(),
        });
    }

    /// Ask the service for one single-shot scan.
    fn send_scan(&mut self) {
        if self.state.continuous || self.state.scanning || !self.state.can_scan() {
            return;
        }
        self.state.scanning = true;
        self.state.last_error = None;
        self.fx.start_scan();
        self.net.send(&ClientMessage::Scan {
            id: format!("kiosk-{}", self.state.scan_count + 1),
        });
    }

    /// Toggle continuous ("monitor") mode.
    fn toggle_monitor(&mut self) {
        if self.state.capturing_baseline || !self.state.can_scan() {
            return;
        }
        let on = !self.state.continuous;
        self.state.continuous = on;
        if on {
            self.state.last_error = None;
        } else {
            // Cancelled mid-scan: no result will arrive.
            self.state.scanning = false;
            self.fx.abort();
        }
        self.net.send(&ClientMessage::Continuous {
            on,
            active_interval_s: self.state.active_interval_s,
            idle_interval_s: self.state.idle_interval_s,
        });
    }
}

/// Track a difference-EIT anomaly across consecutive scan headers. The alert
/// only fires after the score stays above threshold for the configured number
/// of scans, so a single noisy frame cannot trigger it.
fn update_anomaly_state(state: &mut AppState, score: f32) {
    state.anomaly_score = score;
    if score >= state.anomaly_threshold {
        state.anomaly_streak = state.anomaly_streak.saturating_add(1);
    } else {
        state.anomaly_streak = 0;
    }
    if state.anomaly_streak >= state.anomaly_persist_scans {
        state.anomaly_alert = true;
    }
}

impl eframe::App for KioskApp {
    fn update(&mut self, ctx: &egui::Context, _frame: &mut eframe::Frame) {
        // Any input counts as activity: ask the server to stay on the active
        // (frequent) scan interval.
        let interacting = ctx.input(|i| {
            i.pointer.any_down()
                || i.pointer.any_released()
                || i.raw_scroll_delta != egui::Vec2::ZERO
                || !i.events.is_empty()
        });
        if interacting {
            self.net.send(&ClientMessage::Activity);
        }

        for event in self.net.poll() {
            self.handle(event);
        }

        // Self-test screen: a tap continues once results are in, or retries the
        // request if the service has not answered yet.
        if self.state.phase == Phase::SelfTest {
            let clicked = ctx.input(|i| i.pointer.any_click());
            let failed = self.state.boot_error.is_some()
                || self.state.checks.iter().any(|check| check.status == "fail");
            if clicked {
                if self.state.self_test_done && !failed {
                    self.state.phase = Phase::Main;
                } else if !self.state.self_test_done
                    && self.self_test_started.elapsed() > Duration::from_secs(12)
                {
                    self.self_test_requested = false;
                    self.request_self_test();
                }
            }
        }

        self.fx.tick();
        // Keep repainting faster than the pacing cadence while an effect runs,
        // so the field/dissolve animate smoothly.
        let animating = self.fx.is_scanning() || self.fx.is_revealing();

        if let Some(color) = self.pending_image.take() {
            let size = color.size;
            self.texture = Some(ctx.load_texture("scan", color, TextureOptions::LINEAR));
            self.state.scan_count += 1;
            self.state.scanning = false;
            self.state.last_result = Some(Instant::now());
            self.state.last_error = None;
            // Hold the field for its minimum time, then dissolve the image in.
            self.fx.on_result();
            log::info!("scan #{} received ({}x{})", self.state.scan_count, size[0], size[1]);
        }

        ctx.set_visuals(egui::Visuals::dark());
        let screen = ctx.screen_rect();
        let time_s = self.started.elapsed().as_secs_f32();
        if let Some(action) =
            hud::draw(ctx, screen, &mut self.state, &self.fx, time_s, self.texture.as_ref())
        {
            match action {
                Action::Scan => self.send_scan(),
                Action::ToggleMonitor => self.toggle_monitor(),
                Action::CaptureBaseline => self.request_baseline(),
                Action::RetryHardware => self.retry_hardware(),
                Action::DismissBleeding => self.dismiss_bleeding_alert(),
                Action::EnableDemo => self.enable_demo_mode(),
                Action::InjectAnomaly => self.inject_anomaly(),
                Action::ContinueAnyway => self.state.phase = Phase::Main,
            }
        }

        self.state.frames += 1;
        // Frame pacing: repaint at FPS while idle; a smoother cadence while an
        // effect animates so the field/dissolve do not stutter.
        let cadence = if animating { ANIM_FRAME } else { FRAME };
        ctx.request_repaint_after(cadence);
    }
}


#[cfg(test)]
mod tests {
    use super::*;

    fn anomaly_state() -> AppState {
        let mut state = AppState::default();
        state.anomaly_threshold = 0.05;
        state.anomaly_persist_scans = 3;
        state
    }

    #[test]
    fn anomaly_alert_requires_consecutive_scans() {
        let mut state = anomaly_state();
        update_anomaly_state(&mut state, 0.10);
        update_anomaly_state(&mut state, 0.10);
        assert!(!state.anomaly_alert);
        assert_eq!(state.anomaly_streak, 2);

        update_anomaly_state(&mut state, 0.10);
        assert!(state.anomaly_alert);
        assert_eq!(state.anomaly_streak, 3);
    }

    #[test]
    fn anomaly_streak_resets_below_threshold() {
        let mut state = anomaly_state();
        update_anomaly_state(&mut state, 0.10);
        update_anomaly_state(&mut state, 0.10);
        update_anomaly_state(&mut state, 0.01);
        assert_eq!(state.anomaly_streak, 0);
        assert!(!state.anomaly_alert);

        update_anomaly_state(&mut state, 0.10);
        assert!(!state.anomaly_alert);
        assert_eq!(state.anomaly_streak, 1);
    }

    #[test]
    fn heatmap_full_field_keeps_the_whole_square() {
        let mut img = image::RgbaImage::new(4, 4);
        img.put_pixel(1, 1, image::Rgba([255, 0, 0, 255]));

        let full = to_disc(&img, true);
        assert_eq!(full.size, [4, 4]);
        assert_eq!(full.pixels[0], egui::Color32::TRANSPARENT);

        // The grayscale path still crops to the bright content.
        let cropped = to_disc(&img, false);
        assert_ne!(cropped.size, [4, 4]);
    }
}
