connythecreator/crimson-veil/firmware/mp-firm/src/mock_tables_16.py

"""FEM mock tables for 16 electrodes at 50 kHz.

Flat lists: re, im, re, im, ... in the firmware's adjacent order.
Generated with pyEIT; see mock_ad5933.py.
"""

BASELINE = [
    -0.0965878724, 0, -0.0418933085, 0, -0.0252762071, 0, -0.0180129329, 0,
    -0.0145450485, 0, -0.0128558661, 0, -0.0123728767, 0, -0.0128302514, 0,
    -0.0145262772, 0, -0.0180121257, 0, -0.0251334898, 0, -0.0418965421, 0,
    -0.0967068974, 0, -0.0962454782, 0, -0.0420524395, 0, -0.0251723795, 0,
    -0.0180477707, 0, -0.0145205087, 0, -0.0128615835, 0, -0.012328727, 0,
    -0.0128593484, 0, -0.0145196766, 0, -0.0180000883, 0, -0.0252813819, 0,
    -0.0420638077, 0, -0.0964859002, 0, -0.0964374836, 0, -0.0417943008, 0,
    -0.0252222664, 0, -0.0180221285, 0, -0.0145224692, 0, -0.0128257115, 0,
    -0.0123626283, 0, -0.012853415, 0, -0.0145036251, 0, -0.0180854701, 0,
    -0.0252230591, 0, -0.0419717027, 0, -0.0965878724, 0, -0.0966290725, 0,
    -0.042094027, 0, -0.0252634726, 0, -0.0180447563, 0, -0.0145067468, 0,
    -0.0128678646, 0, -0.0123537482, 0, -0.0128280028, 0, -0.0145512681, 0,
    -0.0179863527, 0, -0.0251823905, 0, -0.0418933085, 0, -0.0962454782, 0,
    -0.0961971508, 0, -0.0419314553, 0, -0.0251831161, 0, -0.0180040945, 0,
    -0.0145395003, 0, -0.0128573087, 0, -0.0123393875, 0, -0.0128927003, 0,
    -0.0145062845, 0, -0.0180602303, 0, -0.0252762071, 0, -0.0420524395, 0,
    -0.0964374836, 0, -0.0970105441, 0, -0.0419387313, 0, -0.0252170738, 0,
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
        -0.0127198549, 0, -0.0120933336, 0, -0.012416107, 0, -0.0137650286, 0,
        -0.0166904049, 0, -0.0224689822, 0, -0.0363239424, 0, -0.0895487958, 0,
        -0.0977871167, 0, -0.0425543588, 0, -0.0255584726, 0, -0.0183267118, 0,
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
    ],
]
