connythecreator/crimson-veil/software/core/config.py

"""Suite configuration.

Central place for selecting the hardware backend, solver backend, and scan
parameters. ``main.py`` reads this at boot; ``dev.py`` may override fields.

Defaults target a development laptop: the ``sim`` backend runs with no hardware.
On the device the ESP32 is the primary interface and is selected with
``CV_BACKEND=esp32``; install ``requirements-pi.txt`` for the serial transport.
"""

from __future__ import annotations

import os

from .types import DeviceConfig, MeshConfig

# "sim"   -> software.sim.sim_hardware (no hardware, laptop/CI)
# "esp32" -> hardware.esp32 (the ESP32 over USB serial; the device default)
HARDWARE_BACKEND = os.environ.get("CV_BACKEND", "sim")

# "stub" -> software.sim.stub_solver (placeholder image)
# "pyeit" -> real reconstruction (see software/reconstruction/PYEIT_SOLVER.md)
SOLVER_BACKEND = os.environ.get("CV_SOLVER", "stub")

# One excitation frequency per scan (the front end runs a single frequency).
# The AD5933 ceiling is ~100 kHz. The ESP32 is authoritative once connected; it
# reports its frequency in ``hello`` and the backend uses that.
DEFAULT_FREQUENCY_HZ = float(os.environ.get("CV_FREQUENCY_HZ", "50000"))

# The ESP32 is authoritative for the electrode count and pairing; this value is
# only a fallback used by the sim backend and before the ESP32 handshake.
N_ELECTRODES = 8

# USB serial to the ESP32.
# Empty = auto-detect: prefer CP210x/CH340/Espressif by USB ID, then ttyUSB,
# then ttyACM. Set CV_ESP32_PORT to pin an exact device.
ESP32_PORT = os.environ.get("CV_ESP32_PORT", "")
ESP32_BAUD = int(os.environ.get("CV_ESP32_BAUD", "115200"))

# Kiosk display: the 3.5" SPI panel is 480x320; kept for reference/tools.
KIOSK_WIDTH = 480
KIOSK_HEIGHT = 320


def override(*, hardware: str | None = None, solver: str | None = None) -> None:
    """Override the selected backends at runtime (used by ``server --dev``)."""
    global HARDWARE_BACKEND, SOLVER_BACKEND
    if hardware is not None:
        HARDWARE_BACKEND = hardware
    if solver is not None:
        SOLVER_BACKEND = solver


def device_config(backend: str | None = None) -> DeviceConfig:
    """Build a :class:`DeviceConfig` from the current suite settings."""
    return DeviceConfig(
        backend=backend or HARDWARE_BACKEND,
        frequency_hz=DEFAULT_FREQUENCY_HZ,
        options={"port": ESP32_PORT, "baud": ESP32_BAUD},
    )


def mesh_config(n_electrodes: int | None = None) -> MeshConfig:
    return MeshConfig(
        n_electrodes=N_ELECTRODES if n_electrodes is None else n_electrodes,
        shape="circle",
    )
