connythecreator/crimson-veil/firmware/mp-firm/src/mock_tables_8.py

"""FEM mock tables for 8 electrodes at 50 kHz.

Flat lists: re, im, re, im, ... in the firmware's adjacent order.
Generated with pyEIT; see mock_ad5933.py.
"""

BASELINE = [
    -0.110581707, 0, -0.0599305835, 0, -0.0503823652, 0, -0.0599610632, 0,
    -0.110300096, 0, -0.110590551, 0, -0.0599199617, 0, -0.0504527884, 0,
    -0.0599733634, 0, -0.110336774, 0, -0.110341396, 0, -0.0599652459, 0,
    -0.0504519344, 0, -0.059900058, 0, -0.110581707, 0, -0.110249202, 0,
    -0.0599429419, 0, -0.0503594962, 0, -0.0599305835, 0, -0.110590551, 0,
    -0.110507297, 0, -0.0598492531, 0, -0.0503823652, 0, -0.0599199617, 0,
    -0.110341396, 0, -0.11048977, 0, -0.0599610632, 0, -0.0504527884, 0,
    -0.0599652459, 0, -0.110249202, 0, -0.110300096, 0, -0.0599733634, 0,
    -0.0504519344, 0, -0.0599429419, 0, -0.110507297, 0, -0.110336774, 0,
    -0.059900058, 0, -0.0503594962, 0, -0.0598492531, 0, -0.11048977, 0,
]

TARGETS = [
    [
        -0.11192339, 0, -0.0577248358, 0, -0.0469287473, 0, -0.0609503367, 0,
        -0.11118278, 0, -0.109044794, 0, -0.0544292245, 0, -0.0510906411, 0,
        -0.0608913097, 0, -0.111198068, 0, -0.0979520181, 0, -0.0589493628, 0,
        -0.0511134361, 0, -0.0608716989, 0, -0.11192339, 0, -0.0978746827, 0,
        -0.05486523, 0, -0.0473815647, 0, -0.0577248358, 0, -0.109044794, 0,
        -0.108124797, 0, -0.0570691807, 0, -0.0469287473, 0, -0.0544292245, 0,
        -0.0979520181, 0, -0.111904972, 0, -0.0609503367, 0, -0.0510906411, 0,
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
        -0.053979802, 0, -0.0962889642, 0, -0.111861392, 0, -0.0610659347, 0,
        -0.051132862, 0, -0.058636515, 0, -0.0967271023, 0, -0.111343616, 0,
        -0.0609405639, 0, -0.0510257127, 0, -0.053902228, 0, -0.10818766, 0,
    ],
]
