connythecreator/crimson-veil/firmware/mp-firm/src/board_config.py

"""On-device configuration written by the firmware uploader.

`hardware/firmware_upload.py` overwrites this file on the ESP32 with the chosen
mode. Keeping it a plain module means the firmware can read it with a normal
import on MicroPython.
"""

USE_MOCK = False
# Reported to the host in `hello`; the kiosk ring renders this many electrodes.
# Supported by the mock tables: 4, 8 or 16.
N_ELECTRODES = 8
