connythecreator/crimson-veil/firmware/mp-firm/src/mock_tables_4.py

"""FEM mock tables for 4 electrodes at 50 kHz.

Flat lists: re, im, re, im, ... in the firmware's adjacent order.
Generated with pyEIT; see mock_ad5933.py.
"""

BASELINE = [
    -0.22052067, 0, -0.22062943, 0, -0.22052067, 0, -0.22062943, 0,
]

TARGETS = [
    [
        -0.212828996, 0, -0.211870575, 0, -0.212828996, 0, -0.211870575, 0,
    ],
    [
        -0.222228389, 0, -0.208803419, 0, -0.222228389, 0, -0.208803419, 0,
    ],
    [
        -0.212983037, 0, -0.212698911, 0, -0.212983037, 0, -0.212698911, 0,
    ],
    [
        -0.20734984, 0, -0.222800925, 0, -0.20734984, 0, -0.222800925, 0,
    ],
    [
        -0.213074166, 0, -0.213455394, 0, -0.213074166, 0, -0.213455394, 0,
    ],
    [
        -0.221688707, 0, -0.208808501, 0, -0.221688707, 0, -0.208808501, 0,
    ],
    [
        -0.212818037, 0, -0.212734713, 0, -0.212818037, 0, -0.212734713, 0,
    ],
    [
        -0.208473086, 0, -0.22196853, 0, -0.208473086, 0, -0.22196853, 0,
    ],
]
