connythecreator/crimson-veil/firmware/mp-firm/hwtest/main.py

"""Standalone bench-test firmware for the AD5933 front end.

This firmware is intentionally separate from the production EIT firmware in
``firmware/mp-firm/src``. The analog test exercises only the AD5933 and the
analog channel wired directly to it; a separate ``hwtest_mux`` command runs the
all-roles-per-electrode mux continuity cycle.

Bench fixture:
    C = 0.1 uF between Drive+ and Drive-
    Sense+ strapped to Drive+, Sense- strapped to Drive-

On boot it emits ``hwtest_hello`` and runs the default check (50 kHz). It then
accepts line-delimited JSON commands over USB serial.
"""

import json
import math
import sys
import time

try:
    from machine import I2C, Pin
except ImportError:  # CPython / unit tests
    I2C = None
    Pin = None

import hwtest_core
import status_led
from ad5933_driver import (
    AD5933,
    OUTPUT_RANGE_1VPP,
    OUTPUT_RANGE_2VPP,
    OUTPUT_RANGE_200MV,
    OUTPUT_RANGE_400MV,
    PGA_GAIN_1,
    AD5933Error,
)

FIRMWARE_VERSION = "hwtest 1.4.0"

CALIBRATION_FILE = "cal.json"
DEFAULT_FREQ_HZ = 50_000.0
DEFAULT_CAL_FREQS = (10_000.0, 50_000.0)
DEFAULT_FIXTURE_KIND = "capacitor"
DEFAULT_CAPACITANCE_F = 0.1e-6
DEFAULT_RESISTANCE_OHM = 100.0
DEFAULT_SAMPLES = 16
MIN_SIGNAL_CODES = 50.0
DEFAULT_TOL_PCT = 5.0
DEFAULT_TOL_DEG = 5.0
DEFAULT_DRIFT_PCT = 2.0
DEFAULT_DRIFT_DEG = 2.0
DEFAULT_RANGE_NAME = "1vpp"
RANGE_VALUES = {
    "2vpp": OUTPUT_RANGE_2VPP,
    "1vpp": OUTPUT_RANGE_1VPP,
    "400mv": OUTPUT_RANGE_400MV,
    "200mv": OUTPUT_RANGE_200MV,
}
CAL_REF_MAG_TOL_PCT = 10.0
CAL_REF_PHASE_TOL_DEG = 5.0

I2C_ID = 0
# Bench wiring: GPIO22 = SCL, GPIO21 = SDA.
I2C_SCL = 22
I2C_SDA = 21
I2C_FREQ = 100_000
AD5933_ADDR = 0x0D

AD5933_MCLK_HZ = 16_776_000.0
AD5933_OUTPUT_RANGE = OUTPUT_RANGE_1VPP
AD5933_PGA_GAIN = PGA_GAIN_1
AD5933_SETTLE_CYCLES = 15
AD5933_TIMEOUT_MS = 1000

# GPIO2 is active-high on this build and must be low during boot.
LED_PIN = 2
LED_ACTIVE_HIGH = True
LED_FLASH_MS = 100
LED_FLASH_DURATION_MS = 5_000

# Mux continuity cycle: all four roles on the same electrode.
MUX_ROLES = ("drive_pos", "drive_neg", "sense_pos", "sense_neg")
MUX_ADDR = {
    "drive_pos": (25, 33, 32),
    "drive_neg": (14, 27, 26),
    "sense_pos": (16, 17, 19),
    "sense_neg": (18, 23, 13),
}
MUX_ELECTRODES = 8
MUX_TEST_OPEN_RAW = 10.0


def _default_sink(line):
    print(line)


sink = _default_sink


def emit(message):
    sink(json.dumps(message))


def read_line(stream):
    raw = stream.readline()
    if not raw:
        return None
    if isinstance(raw, bytes):
        try:
            raw = raw.decode("utf-8")
        except UnicodeError:
            # Serial noise on open must not crash the command loop.
            return ""
    return raw.rstrip("\r\n")


def _status(checks):
    if any(item["status"] == "fail" for item in checks):
        return "fail"
    if any(item["status"] == "warn" for item in checks):
        return "warn"
    return "pass"


def load_calibration_file(path=None):
    """Load existing entries so a calibration run can merge into them."""
    if path is None:
        path = CALIBRATION_FILE
    try:
        handle = open(path)
        try:
            data = json.loads(handle.read())
        finally:
            handle.close()
    except OSError:
        return {}, "calibration file missing: " + path
    except ValueError as exc:
        return {}, "calibration file invalid: " + str(exc)

    entries = data.get("entries") if isinstance(data, dict) else None
    result = {}
    for entry in entries or []:
        try:
            freq = float(entry["f"])
            k_re = float(entry["k_re"])
            k_im = float(entry["k_im"])
        except (AttributeError, KeyError, TypeError, ValueError):
            continue
        if freq <= 0:
            continue
        fixture = str(entry.get("fixture", "capacitor")).lower()
        if fixture not in ("capacitor", "resistor"):
            continue
        result[(fixture, freq)] = {
            "f": freq,
            "fixture": fixture,
            "range": entry.get("range", "2vpp"),
            "c_f": entry.get("c_f"),
            "r_ohm": entry.get("r_ohm"),
            "k_re": k_re,
            "k_im": k_im,
            "mag": entry.get("mag"),
            "phase_deg": entry.get("phase_deg"),
            "status": entry.get("status", "pass"),
        }
    return result, None


def save_calibration_file(entries, path=None):
    if path is None:
        path = CALIBRATION_FILE
    ordered = [entries[key] for key in sorted(entries.keys())]
    data = {"version": 2, "entries": ordered}
    handle = open(path, "w")
    try:
        handle.write(json.dumps(data))
    finally:
        handle.close()
    return ordered


class MuxBank:
    """CD74HC4067 bank with independent address buses and no enable control.

    The board ties every ``~E`` pin low, so all four muxes are always enabled
    and non-latching. Each role has its own S0..S2 bus.
    """

    def __init__(self):
        self._addr = {
            role: [Pin(pin, Pin.OUT) for pin in MUX_ADDR[role]]
            for role in MUX_ROLES
        }
        self.park_all()

    def set_address(self, role, electrode):
        pins = self._addr.get(role)
        if pins is None:
            raise ValueError(f"unknown mux role: {role!r}")
        if not 0 <= electrode < (1 << len(pins)):
            raise ValueError(
                f"electrode {electrode!r} out of range for {role} "
                f"({len(pins)} address bits)"
            )
        for bit, pin in enumerate(pins):
            pin.value((electrode >> bit) & 1)

    def park_all(self):
        for role in MUX_ROLES:
            self.set_address(role, 0)


class HwTestFirmware:
    """Owns the serial command loop and the bench measurement sequence."""

    def __init__(
        self,
        driver,
        capacitance_f=DEFAULT_CAPACITANCE_F,
        resistance_ohm=DEFAULT_RESISTANCE_OHM,
        fixture_kind=DEFAULT_FIXTURE_KIND,
        range_name=DEFAULT_RANGE_NAME,
        samples=DEFAULT_SAMPLES,
        tol_pct=DEFAULT_TOL_PCT,
        tol_deg=DEFAULT_TOL_DEG,
        drift_pct=DEFAULT_DRIFT_PCT,
        drift_deg=DEFAULT_DRIFT_DEG,
        mux=None,
        led=None,
    ):
        self._driver = driver
        self._mux = mux
        self._led = led
        self._capacitance_f = float(capacitance_f)
        self._resistance_ohm = float(resistance_ohm)
        self._fixture_kind = str(fixture_kind).lower()
        self._range_name = str(range_name).lower()
        self._samples = int(samples)
        self._tol_pct = float(tol_pct)
        self._tol_deg = float(tol_deg)
        self._drift_pct = float(drift_pct)
        self._drift_deg = float(drift_deg)
        self._calibration_entries, self._calibration_error = load_calibration_file()
        self._running = False

    def _set_led(self, failed):
        if self._led is None:
            return
        if failed:
            self._led.fail()
        else:
            self._led.ok()

    def _apply_range(self, range_name=None):
        name = str(self._range_name if range_name is None else range_name).lower()
        if name not in RANGE_VALUES:
            raise ValueError("range must be 2vpp, 1vpp, 400mv or 200mv")
        setter = getattr(self._driver, "set_output_range", None)
        if setter is not None:
            setter(RANGE_VALUES[name])
        self._range_name = name
        return name

    def boot(self):
        emit(
            {
                "type": "hwtest_hello",
                "firmware": FIRMWARE_VERSION,
                "fixture": {
                    "kind": self._fixture_kind,
                    "c_f": self._capacitance_f,
                    "r_ohm": self._resistance_ohm,
                    "range": self._range_name,
                },
                "default_f": DEFAULT_FREQ_HZ,
                "default_samples": self._samples,
                "calibration": {
                    "present": bool(self._calibration_entries),
                    "entries": len(self._calibration_entries),
                    "error": self._calibration_error,
                },
            }
        )

    def stop(self):
        try:
            self._driver.halt()
        except Exception:  # noqa: BLE001 - best effort on stop
            pass

    def _i2c_check(self):
        i2c = getattr(self._driver, "i2c", None)
        if i2c is None or not hasattr(i2c, "scan"):
            return hwtest_core.check("i2c", "skip", "no I2C handle")
        try:
            found = [int(address) for address in i2c.scan()]
        except Exception as exc:  # noqa: BLE001 - report, do not crash
            return hwtest_core.check("i2c", "fail", f"{type(exc).__name__}: {exc}")
        address = hex(AD5933_ADDR)
        if AD5933_ADDR in found:
            return hwtest_core.check("i2c", "pass", "AD5933 at " + address)
        return hwtest_core.check(
            "i2c",
            "fail",
            "AD5933 " + address + " not found; saw " + str(found),
        )

    def _temperature_check(self, temperature):
        if temperature is None:
            return hwtest_core.check("temperature", "warn", "AD5933 temperature unavailable")
        readable = str(round(float(temperature), 2)) + " C"
        if -40.0 <= float(temperature) <= 125.0:
            return hwtest_core.check("temperature", "pass", readable)
        return hwtest_core.check(
            "temperature", "warn", readable + " outside -40..125 C"
        )

    def _acquisition_check(self, samples, requested, error):
        if error:
            return hwtest_core.check("acquisition", "fail", error)
        if len(samples) != requested:
            return hwtest_core.check(
                "acquisition",
                "fail",
                f"collected {len(samples)} of {requested} samples",
            )
        if not samples or all(real == 0 and imag == 0 for real, imag in samples):
            return hwtest_core.check("acquisition", "fail", "raw AD5933 data is all zero")
        for index, (real, imag) in enumerate(samples):
            if hwtest_core.is_saturated(real, imag):
                return hwtest_core.check(
                    "acquisition",
                    "fail",
                    f"sample {index} saturated (re={real}, im={imag})",
                )
        return hwtest_core.check("acquisition", "pass", f"{len(samples)} samples")

    def mux_test(self, seq=0, freq_hz=DEFAULT_FREQ_HZ, min_raw=MUX_TEST_OPEN_RAW):
        """Run the all-roles-per-electrode mux continuity cycle."""
        try:
            freq = float(freq_hz)
            threshold = float(min_raw)
            if freq <= 0:
                raise ValueError("frequency must be positive")
            if threshold < 0:
                raise ValueError("min_raw must be non-negative")
        except (TypeError, ValueError) as exc:
            payload = {
                "type": "hwtest_mux_result",
                "seq": seq,
                "status": "fail",
                "error": f"{type(exc).__name__}: {exc}",
                "points": [],
            }
            emit(payload)
            self._set_led(True)
            return payload

        if self._mux is None:
            payload = {
                "type": "hwtest_mux_result",
                "seq": seq,
                "status": "fail",
                "error": "no mux bank configured",
                "points": [],
            }
            emit(payload)
            self._set_led(True)
            return payload

        points = []
        open_electrodes = []
        try:
            for electrode in range(MUX_ELECTRODES):
                for role in MUX_ROLES:
                    self._mux.set_address(role, electrode)
                raw_re, raw_im = self._driver.measure(freq)
                raw_abs = math.sqrt(raw_re * raw_re + raw_im * raw_im)
                status = "open" if raw_abs < threshold else "connected"
                if status == "open":
                    open_electrodes.append(electrode)
                points.append(
                    {
                        "e": electrode,
                        "raw_re": raw_re,
                        "raw_im": raw_im,
                        "raw_abs": raw_abs,
                        "status": status,
                    }
                )
        except Exception as exc:  # noqa: BLE001 - report, never crash the loop
            try:
                self._mux.park_all()
            except Exception:  # noqa: BLE001
                pass
            payload = {
                "type": "hwtest_mux_result",
                "seq": seq,
                "f_hz": freq,
                "min_raw": threshold,
                "status": "fail",
                "error": f"{type(exc).__name__}: {exc}",
                "points": points,
            }
            emit(payload)
            self._set_led(True)
            return payload

        try:
            self._mux.park_all()
        except Exception:  # noqa: BLE001 - best effort
            pass

        status = "fail" if open_electrodes else "pass"
        payload = {
            "type": "hwtest_mux_result",
            "seq": seq,
            "f_hz": freq,
            "min_raw": threshold,
            "status": status,
            "open_electrodes": open_electrodes,
            "points": points,
        }
        emit(payload)
        self._set_led(status == "fail")
        return payload

    def run_once(
        self,
        seq=0,
        freq_hz=DEFAULT_FREQ_HZ,
        capacitance_f=None,
        resistance_ohm=None,
        fixture_kind=None,
        range_name=None,
        samples=None,
        tol_pct=None,
        tol_deg=None,
        drift_pct=None,
        drift_deg=None,
        emit_result=True,
    ):
        freq_hz = float(freq_hz)
        capacitance_f = float(
            self._capacitance_f if capacitance_f is None else capacitance_f
        )
        resistance_ohm = float(
            self._resistance_ohm if resistance_ohm is None else resistance_ohm
        )
        fixture_kind = str(
            self._fixture_kind if fixture_kind is None else fixture_kind
        ).lower()
        requested = int(self._samples if samples is None else samples)
        tol_pct = float(self._tol_pct if tol_pct is None else tol_pct)
        tol_deg = float(self._tol_deg if tol_deg is None else tol_deg)
        drift_pct = float(self._drift_pct if drift_pct is None else drift_pct)
        drift_deg = float(self._drift_deg if drift_deg is None else drift_deg)

        if fixture_kind == "resistor":
            fixture = {"kind": "resistor", "r_ohm": resistance_ohm}
        else:
            fixture = {"kind": "capacitor", "c_f": capacitance_f}

        try:
            temperature = self._driver.temperature_c()
        except Exception:  # noqa: BLE001 - the check reports the failure
            temperature = None

        checks = [self._i2c_check(), self._temperature_check(temperature)]
        raw_samples = []
        error = None

        try:
            if freq_hz <= 0:
                raise ValueError("frequency must be positive")
            if fixture_kind not in ("capacitor", "resistor"):
                raise ValueError("fixture must be capacitor or resistor")
            if fixture_kind == "capacitor" and capacitance_f <= 0:
                raise ValueError("capacitance must be positive")
            if fixture_kind == "resistor" and resistance_ohm <= 0:
                raise ValueError("resistance must be positive")
            if requested < 2:
                raise ValueError("samples must be at least 2")
            self._apply_range(range_name)
            # Discard one warm-up point: the first post-configuration
            # conversion is often biased and would skew the calibration.
            self._driver.measure(freq_hz)
            for _ in range(requested):
                real, imag = self._driver.measure(freq_hz)
                raw_samples.append((float(real), float(imag)))
        except (AD5933Error, ValueError, TypeError) as exc:
            error = f"{type(exc).__name__}: {exc}"
        except Exception as exc:  # noqa: BLE001 - a hardware fault must be reported
            error = f"{type(exc).__name__}: {exc}"

        acquisition = self._acquisition_check(raw_samples, requested, error)
        checks.append(acquisition)

        if acquisition["status"] == "pass":
            magnitudes = [
                hwtest_core.magnitude(complex(real, imag))
                for real, imag in raw_samples
            ]
            mean_magnitude = sum(magnitudes) / float(len(magnitudes))
            if mean_magnitude < MIN_SIGNAL_CODES:
                checks.append(
                    hwtest_core.check(
                        "signal",
                        "fail",
                        "raw signal near zero ("
                        + str(round(mean_magnitude, 1))
                        + " codes); check AFE power, drive/sense wiring and fixture",
                    )
                )
            else:
                checks.append(
                    hwtest_core.check(
                        "signal",
                        "pass",
                        "mean " + str(round(mean_magnitude, 1)) + " codes",
                    )
                )

        result = {
            "type": "hwtest_result",
            "seq": seq,
            "firmware": FIRMWARE_VERSION,
            "f_hz": freq_hz,
            "temp_ad5933_c": temperature,
            "fixture": fixture,
            "range": self._range_name,
            "expected": None,
            "raw": None,
            "calibration": None,
            "measured": None,
            "drift": None,
            "tolerances": {
                "mag_pct": tol_pct,
                "phase_deg": tol_deg,
                "drift_pct": drift_pct,
                "drift_deg": drift_deg,
            },
            "checks": checks,
            "status": "fail",
            "error": error,
        }

        try:
            if fixture_kind == "resistor":
                expected = hwtest_core.expected_resistor(resistance_ohm)
            else:
                expected = hwtest_core.expected_impedance(freq_hz, capacitance_f)
            result["expected"] = {
                "re": expected.real,
                "im": expected.imag,
                "mag": hwtest_core.magnitude(expected),
                "phase_deg": hwtest_core.phase_deg(expected),
            }
        except ValueError as exc:
            result["error"] = f"{type(exc).__name__}: {exc}"

        if acquisition["status"] == "pass":
            try:
                evaluation = hwtest_core.evaluate_expected(
                    expected,
                    raw_samples,
                    tol_pct=tol_pct,
                    tol_deg=tol_deg,
                    drift_pct=drift_pct,
                    drift_deg=drift_deg,
                )
                result.update(
                    {
                        "raw": evaluation["raw"],
                        "calibration": evaluation["calibration"],
                        "measured": evaluation["measured"],
                        "drift": evaluation["drift"],
                        "expected": evaluation["expected"],
                    }
                )
                checks.extend(evaluation["checks"])
            except (ValueError, ZeroDivisionError) as exc:
                result["error"] = f"{type(exc).__name__}: {exc}"
                checks.append(hwtest_core.check("calibration", "fail", str(exc)))

        result["status"] = _status(checks)
        if emit_result:
            self._set_led(result["status"] == "fail")
            emit(result)
        return result

    def calibrate(
        self,
        seq=0,
        freqs=None,
        capacitance_f=None,
        resistance_ohm=None,
        fixture_kind=None,
        range_name=None,
        samples=None,
        tol_pct=None,
        tol_deg=None,
        drift_pct=None,
        drift_deg=None,
    ):
        """Measure each frequency, merge ``K`` entries, and write cal.json."""
        capacitance_f = float(
            self._capacitance_f if capacitance_f is None else capacitance_f
        )
        resistance_ohm = float(
            self._resistance_ohm if resistance_ohm is None else resistance_ohm
        )
        fixture_kind = str(
            self._fixture_kind if fixture_kind is None else fixture_kind
        ).lower()
        if fixture_kind not in ("capacitor", "resistor"):
            raise ValueError("fixture must be capacitor or resistor")
        requested = int(self._samples if samples is None else samples)
        tol_pct = float(self._tol_pct if tol_pct is None else tol_pct)
        tol_deg = float(self._tol_deg if tol_deg is None else tol_deg)
        drift_pct = float(self._drift_pct if drift_pct is None else drift_pct)
        drift_deg = float(self._drift_deg if drift_deg is None else drift_deg)

        if freqs is None:
            freqs = list(DEFAULT_CAL_FREQS)
        elif isinstance(freqs, str):
            freqs = freqs.split(",")
        frequencies = []
        for value in freqs:
            try:
                frequency = float(value)
            except (TypeError, ValueError):
                continue
            if frequency > 0 and frequency not in frequencies:
                frequencies.append(frequency)

        existing, _ = load_calibration_file()
        entries = dict(existing or self._calibration_entries)
        results = []
        error = None

        if not frequencies:
            error = "no valid calibration frequencies"
        else:
            for frequency in frequencies:
                result = self.run_once(
                    seq=0,
                    freq_hz=frequency,
                    capacitance_f=capacitance_f,
                    resistance_ohm=resistance_ohm,
                    fixture_kind=fixture_kind,
                    range_name=range_name,
                    samples=requested,
                    tol_pct=tol_pct,
                    tol_deg=tol_deg,
                    drift_pct=drift_pct,
                    drift_deg=drift_deg,
                    emit_result=False,
                )
                results.append(result)
                calibration = result.get("calibration")
                if result["status"] in ("pass", "warn") and calibration:
                    entries[(fixture_kind, frequency)] = {
                        "f": frequency,
                        "fixture": fixture_kind,
                        "range": self._range_name,
                        "c_f": capacitance_f if fixture_kind == "capacitor" else None,
                        "r_ohm": resistance_ohm if fixture_kind == "resistor" else None,
                        "k_re": calibration["k_re"],
                        "k_im": calibration["k_im"],
                        "mag": calibration["k_mag"],
                        "phase_deg": calibration["k_phase_deg"],
                        "status": result["status"],
                    }
                elif error is None:
                    error = result.get("error") or (
                        "calibration failed at " + str(frequency) + " Hz"
                    )

        comparison = []
        for frequency in frequencies:
            resistor = entries.get(("resistor", frequency))
            capacitor = entries.get(("capacitor", frequency))
            if not resistor or not capacitor:
                continue
            resistor_mag = hwtest_core.magnitude(
                complex(resistor["k_re"], resistor["k_im"])
            )
            capacitor_mag = hwtest_core.magnitude(
                complex(capacitor["k_re"], capacitor["k_im"])
            )
            mag_diff = (
                abs(resistor_mag - capacitor_mag) / resistor_mag * 100.0
                if resistor_mag
                else 0.0
            )
            phase_diff = abs(
                hwtest_core.wrap_deg(
                    hwtest_core.phase_deg(
                        complex(resistor["k_re"], resistor["k_im"])
                    )
                    - hwtest_core.phase_deg(
                        complex(capacitor["k_re"], capacitor["k_im"])
                    )
                )
            )
            comparison.append(
                {"f": frequency, "mag_diff_pct": mag_diff, "phase_diff_deg": phase_diff}
            )

        reference_ok = all(
            item["mag_diff_pct"] <= CAL_REF_MAG_TOL_PCT
            and item["phase_diff_deg"] <= CAL_REF_PHASE_TOL_DEG
            for item in comparison
        )
        if comparison and not reference_ok:
            error = error or (
                "resistor/capacitor references disagree beyond tolerance ("
                + str(round(CAL_REF_MAG_TOL_PCT))
                + "% / "
                + str(round(CAL_REF_PHASE_TOL_DEG))
                + " deg)"
            )

        ordered = []
        if entries:
            try:
                ordered = save_calibration_file(entries)
                self._calibration_entries = entries
                self._calibration_error = None
            except OSError as exc:
                error = "could not write " + CALIBRATION_FILE + ": " + str(exc)

        passed = sum(1 for result in results if result["status"] in ("pass", "warn"))
        if not results or passed == 0 or not reference_ok:
            status = "fail"
        elif error:
            status = "warn"
        elif any(result["status"] == "warn" for result in results):
            status = "warn"
        else:
            status = "pass"

        payload = {
            "type": "hwtest_calibration",
            "seq": seq,
            "file": CALIBRATION_FILE,
            "fixture": fixture_kind,
            "range": self._range_name,
            "entries": ordered,
            "comparison": comparison,
            "status": status,
            "error": error,
        }
        emit(payload)
        self._set_led(status == "fail")
        return payload

    def excite(self, seq=0, freq_hz=DEFAULT_FREQ_HZ, range_name=None):
        """Leave the AD5933 excitation running for an AFE scope test."""
        try:
            frequency = float(freq_hz)
            if frequency <= 0:
                raise ValueError("frequency must be positive")
            self._apply_range(range_name)
            self._driver.start_continuous(frequency)
        except Exception as exc:  # noqa: BLE001 - report, do not crash
            emit({"type": "hwtest_error", "message": f"{type(exc).__name__}: {exc}"})
            return
        emit(
            {
                "type": "hwtest_excite",
                "seq": seq,
                "f": frequency,
                "range": self._range_name,
                "status": "on",
            }
        )

    def _temperature_only(self):
        try:
            temperature = self._driver.temperature_c()
        except Exception as exc:  # noqa: BLE001
            emit({"type": "hwtest_error", "message": f"{type(exc).__name__}: {exc}"})
            return
        emit({"type": "hwtest_temp", "temp_ad5933_c": temperature})

    def handle(self, message):
        kind = message.get("type")
        if kind == "hwtest_run":
            self.run_once(
                seq=message.get("seq", 0),
                freq_hz=message.get("f", DEFAULT_FREQ_HZ),
                capacitance_f=message.get("c_f", self._capacitance_f),
                resistance_ohm=message.get("r_ohm", self._resistance_ohm),
                fixture_kind=message.get("fixture", self._fixture_kind),
                range_name=message.get("range", self._range_name),
                samples=message.get("samples", self._samples),
                tol_pct=message.get("tol_pct", self._tol_pct),
                tol_deg=message.get("tol_deg", self._tol_deg),
                drift_pct=message.get("drift_pct", self._drift_pct),
                drift_deg=message.get("drift_deg", self._drift_deg),
            )
        elif kind == "hwtest_calibrate":
            self.calibrate(
                seq=message.get("seq", 0),
                freqs=message.get("freqs", list(DEFAULT_CAL_FREQS)),
                capacitance_f=message.get("c_f", self._capacitance_f),
                resistance_ohm=message.get("r_ohm", self._resistance_ohm),
                fixture_kind=message.get("fixture", self._fixture_kind),
                range_name=message.get("range", self._range_name),
                samples=message.get("samples", self._samples),
                tol_pct=message.get("tol_pct", self._tol_pct),
                tol_deg=message.get("tol_deg", self._tol_deg),
                drift_pct=message.get("drift_pct", self._drift_pct),
                drift_deg=message.get("drift_deg", self._drift_deg),
            )
        elif kind == "hwtest_mux":
            self.mux_test(
                seq=message.get("seq", 0),
                freq_hz=message.get("f", DEFAULT_FREQ_HZ),
                min_raw=message.get("min_raw", MUX_TEST_OPEN_RAW),
            )
        elif kind == "hwtest_excite":
            self.excite(
                seq=message.get("seq", 0),
                freq_hz=message.get("f", DEFAULT_FREQ_HZ),
                range_name=message.get("range", self._range_name),
            )
        elif kind == "hwtest_identify":
            self.boot()
        elif kind == "hwtest_temp":
            self._temperature_only()
        elif kind == "hwtest_stop":
            self.stop()
        else:
            emit({"type": "hwtest_error", "message": f"unknown message type: {kind!r}"})
        return kind

    def run(self, stream=None):
        if stream is None:
            stream = sys.stdin
        self._running = True
        while self._running:
            line = read_line(stream)
            if line is None:
                # Keep the bench firmware alive when the USB host has not
                # opened the port yet; host-side test streams still end at EOF.
                if stream is sys.stdin:
                    time.sleep(0.01)
                    continue
                self._running = False
                break
            if not line:
                continue
            try:
                message = json.loads(line)
                if not isinstance(message, dict) or "type" not in message:
                    raise ValueError("message must be a JSON object with a 'type'")
            except ValueError as exc:
                emit({"type": "hwtest_error", "message": f"malformed message: {exc}"})
                continue
            try:
                self.handle(message)
            except Exception as exc:  # noqa: BLE001 - never crash the command loop
                emit({"type": "hwtest_error", "message": f"internal error: {exc}"})


def main():
    if I2C is None or Pin is None:
        raise RuntimeError("machine.I2C is only available on the ESP32")
    i2c = I2C(I2C_ID, scl=Pin(I2C_SCL), sda=Pin(I2C_SDA), freq=I2C_FREQ)
    driver = AD5933(
        i2c,
        addr=AD5933_ADDR,
        mclk_hz=AD5933_MCLK_HZ,
        output_range=AD5933_OUTPUT_RANGE,
        pga_gain=AD5933_PGA_GAIN,
        settle_cycles=AD5933_SETTLE_CYCLES,
        timeout_ms=AD5933_TIMEOUT_MS,
    )
    try:
        driver.initialize()
    except Exception:  # noqa: BLE001 - the first run reports the failure
        pass
    led = status_led.StatusLED(
        LED_PIN, LED_ACTIVE_HIGH, LED_FLASH_MS, LED_FLASH_DURATION_MS
    )
    firmware = HwTestFirmware(driver, mux=MuxBank(), led=led)
    firmware.boot()
    # The host tool sends hwtest_run. Do not auto-run here: a blocked I2C
    # transaction in the boot test would prevent the command loop from starting.
    firmware.run()


if __name__ == "__main__":
    main()
