connythecreator/crimson-veil/(commit log)

2026-10-06 1st rendition of pyeit, matching the sensors for the project. Seems to be working. Will change pipeline.py and make actual pyeit_solver.py software file according to this
2026-10-14 3D_Models + 3.5in LCD Driver Fixes
2026-10-14 Fix ESP32 scan transport and firmware command loop
2026-10-19 Add Witty Pi BMS, hardware self-test, kiosk controls, touch fix
    - Witty Pi 4 L3V7 BMS: veil-bms telemetry service, SoC/runtime/four temps
    in metrics, SYSUP_PIN 17->16 overlay, UWI suppressed
    - Pre-start hardware self-test (service checks + terminal-style kiosk screen)
    - Kiosk: remove title header, left EIT stage with single-scan/monitor
    buttons, self-test phase, --dev; fix acquisition lattice stuck on cancel
    - Touch: invert Y (not X) and calibrate the panel's raw range
    - ESP32: probe/selftest backend calls; firmware selftest handler
    - Docs and tests
2026-10-19 Add Pi CAD v0.7 and ignore agent/vendor/video artifacts
    - Commit the Pi case CAD sources, previews and STL exports (v0.7),
    excluding backup copies
    - Ignore .claude/ worktrees, downloaded 3D model packs/snapshots,
    video generation assets (marketing, trailer, mp4/blend/ass) and backups
2026-10-19 Integrate pyEIT solver, baseline capture, mock firmware, ESP uploader
    - Port the validated pyEIT solver, pipeline/session baseline workflow,
    transport hardening, and requirements-pyeit
    - Kiosk: Calibration page captures/recaptures the pyEIT reference; scans
    are gated until a baseline exists; protocol/state support
    - MicroPython mock AD5933/mux driver, board_config, and pty launcher
    - ESP32 firmware uploader (dev CLI + backend WS command) with mpremote,
    hard reset, port auto-detection, boot-noise tolerance
    - Fix MicroPython tuple unpacking, upload argument, baseline guard
    - Configure the device backend for esp32 + pyeit; docs/tests
2026-10-19 Enlarge EIT view, add mock anomaly motion, per-count electrode tables
    - Kiosk: larger EIT disc/ring (72% stage, ~102 px disc) for detail
    - Mock firmware: cycle an 8-position anomaly so monitor mode shows motion
    - Add 4/8/16 electrode tables as per-count flat-float modules (fits ESP32
    RAM) and make board_config.N_ELECTRODES configurable
    - Uploader --electrodes and WS upload_firmware.electrodes; the kiosk ring
    renders the count reported in hello (verified 16 on-device)
    - Docs/tests
2026-10-27 Update Pi CAD v0.7, add dimensioned drawings and CE07929 case
2026-10-27 Load bench calibration in firmware and report it in self-test
2026-10-27 Rewrite README for the full device and add subsystem design notes
2026-10-27 Add KiCad front-end board and LTspice bench sources
2026-10-27 Thin the CE07929 case floor and lower the board stack
2026-11-02 Changed pyEIT test to output in same heatmap format as GUI on hardware
